gabriel-bettanin/LAIKA/Docs/Fotos/3D Printed Robot Actuator.jpg

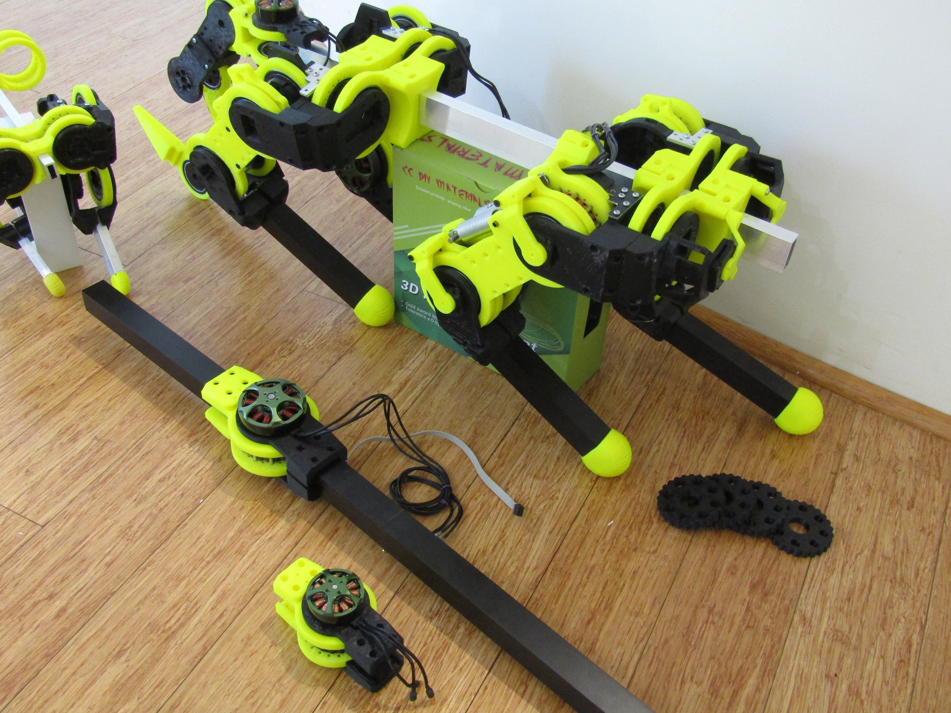
Docs/Fotos/3D Printed Robot Actuator.jpg
