gabriel-bettanin/LAIKA/Actuator/Electronics/3D Models/JST_Pins/JST/HLB1uQQOXyzxK1RjSspjq6AS.pXaA.jpg_q50.jpg

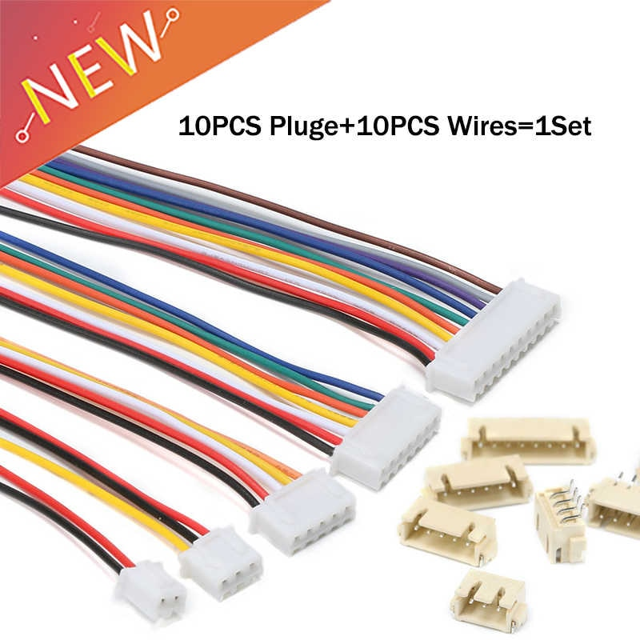
Actuator/Electronics/3D Models/JST_Pins/JST/HLB1uQQOXyzxK1RjSspjq6AS.pXaA.jpg_q50.jpg
