gabriel-bettanin/LAIKA/README.md

# laika
Affordable robotic's actuator for dynamic robots
