gabriel-bettanin/LAIKA/Docs/PET/1. Reunião de Projetos - Iniciação.pptx

## LAIKA

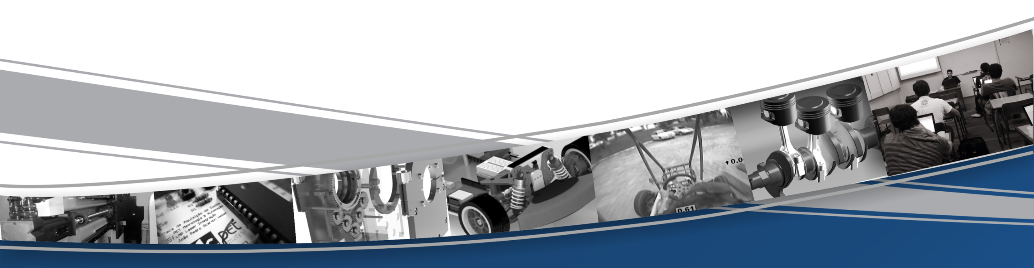
[picture p3: figure]

Gabriel Antonio Nalin Bettanin

## Agenda

- Apresentação do Projeto
  - Motivação
  - Escopo
  - Objetivo
- Análise de Riscos
- Etapas

## Apresentação do Projeto

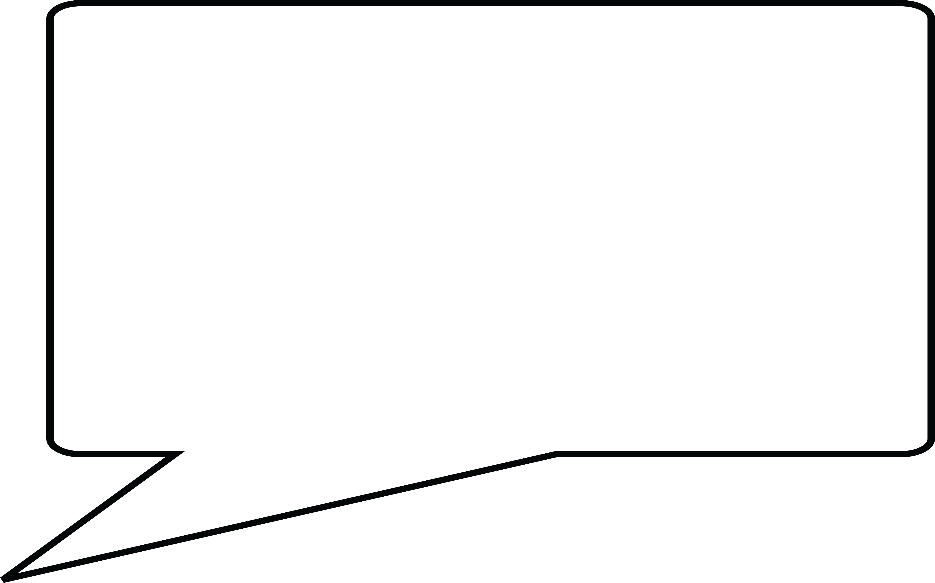
[picture p4: figure]

Pô Bettanin por quê você escolheu esse nome ??

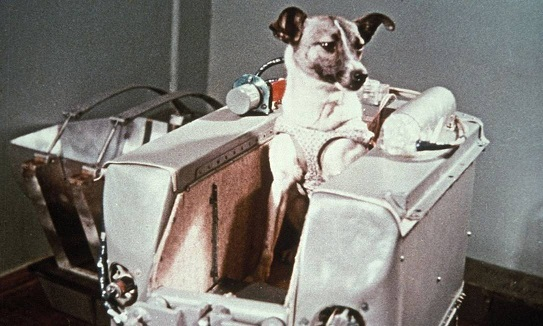
[picture p5: figure]
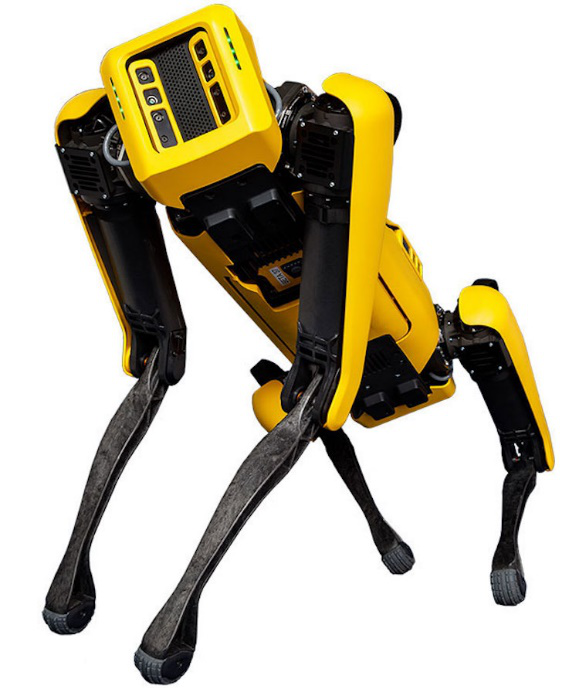
[picture p6: figure]

1954 - 1957

## Apresentação do Projeto

L egged
A rchitecture
for I mplementing
K inematics
A lgorithms

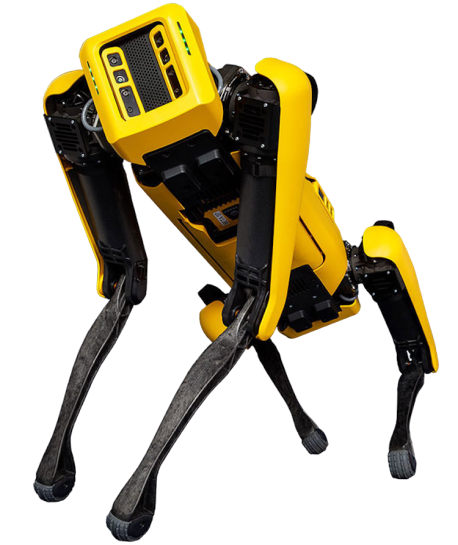
[picture p7: figure]

## Apresentação do Projeto

Arquitetura robótica quadrupede para a implementação de algoritmos cinemáticos

## Apresentação do Projeto

- Robôs são o futuro
- Brasil possui poucas iniciativas nessa área
- Plataforma P&D multidisciplinar

## Apresentação do Projeto

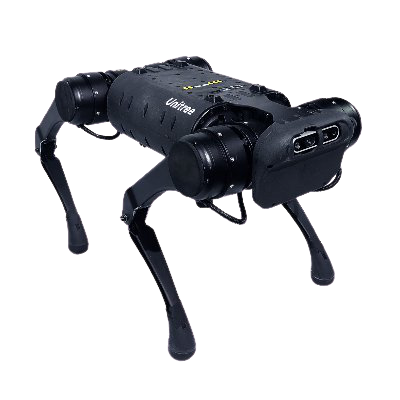
[picture p8: figure]
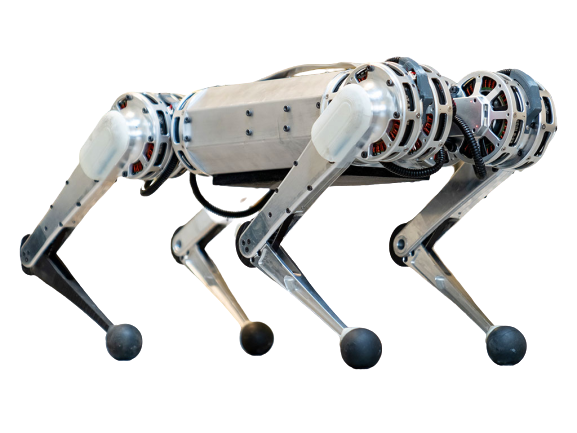
[picture p9: figure]
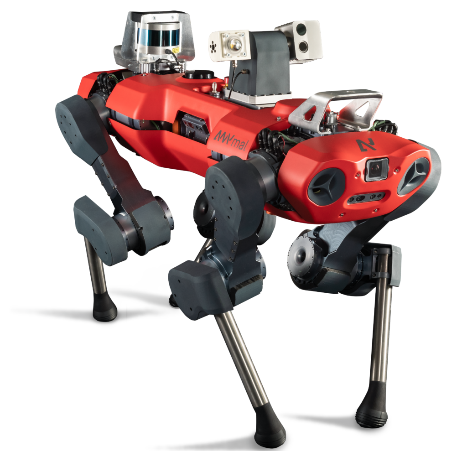
[picture p10: figure]
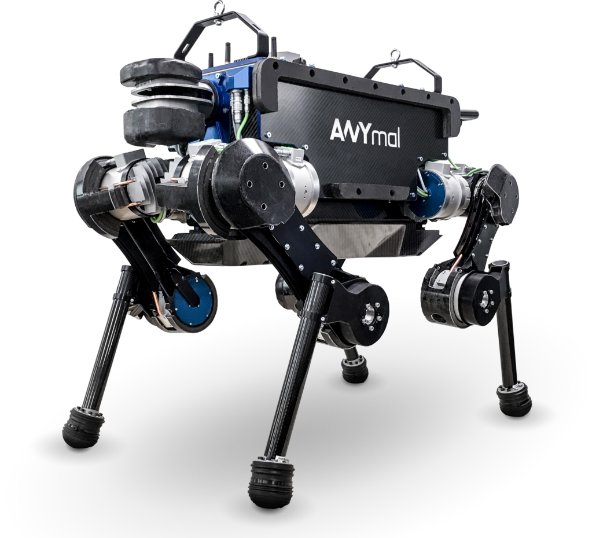
[picture p11: figure]

## Definição do Escopo

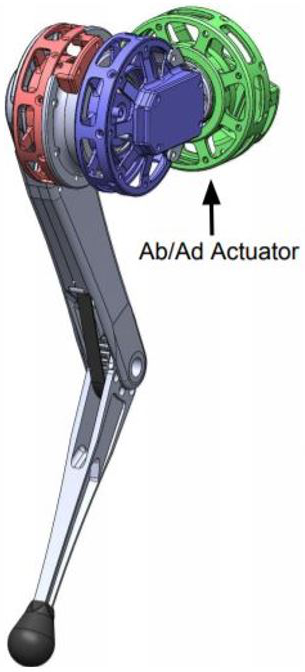
[picture p12: figure]

Perna

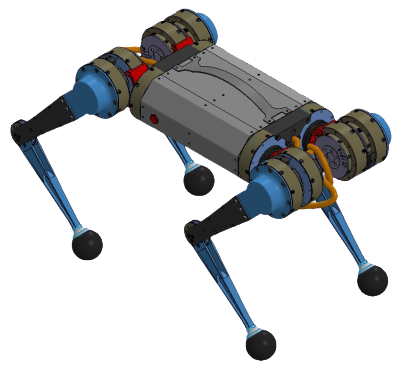
[picture p13: figure]

Quadrupede

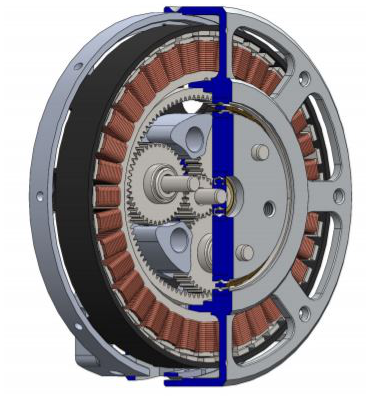
[picture p14: figure]

Atuador

## Objetivos

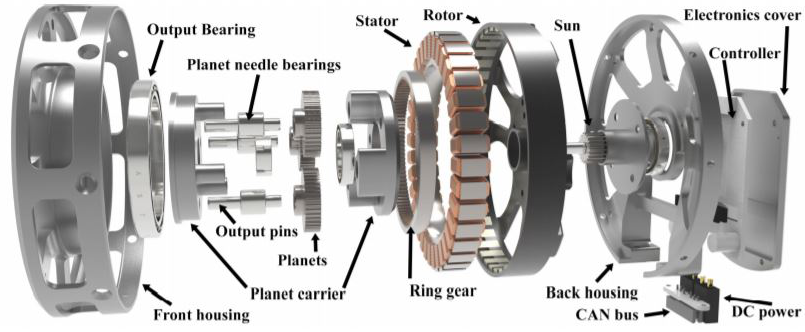
[picture p15: figure]

## Objetivos

- Desenvolvimento de um atuador robótico de baixo custo
  - Custo: < R$ 2000,00
  - Torque máximo: ~15N.m
  - Torque contínuo : ~7N.m
  - Robusto, dinâmico e backdrivable
  - OpenSource

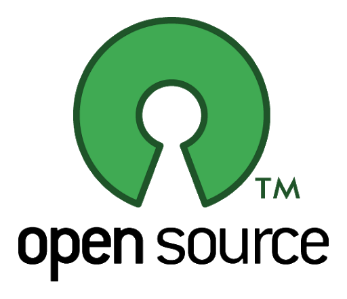
[picture p16: figure]

## Análise de Riscos

  - Possíveis problemas:
    - Orçamento
    - Prototipação em quarentena
    - Áreas complexas e diversas
  - Problemas descartados:
    - Escassez de informações

## Etapas

- Macro 1 – Estudos
  - Leitura de artigos (IEEE, ICRA, MIT, ETH, ...)
  - Documentação de referência (Git, CAD, ...)
  - Acompanhamento de projetos existentes (Hackaday)
  - Cursos (Controle de motores, dinâmica, robótica)
Duração de 30 dias

## Etapas

- Macro 2 – Eletrônica
  - Driver para motor BLDC
  - Placa “mestre”
  - Duração de 30 dias
- Macro 3 – Firmware
  - Adaptação de firmwares existentes
  - Modelo cinemático para testes
  - Duração de 20 dias

Macro 4 – Mecânica
Adaptar motor
Embutir engrenagens
Duração de 30 dias
Macro 5 – Validação
Testes de desempenho (mecânico, elétrico, térmico)
Duração de 10 dias

## Slide 14

Gabriel Antonio Nalin Bettanin
gabriel.bettanin@labmetro.ufsc.br

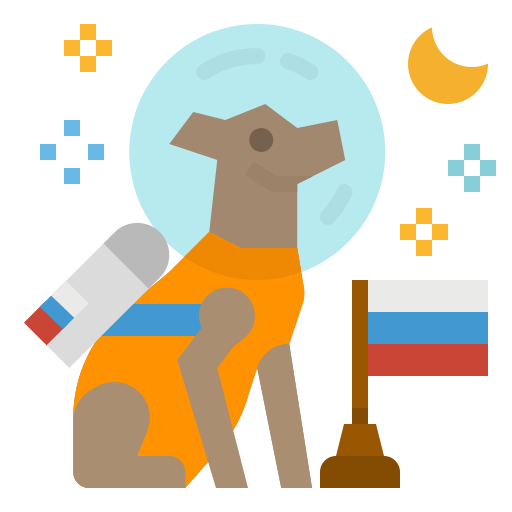
[picture p17: figure]
