gabriel-bettanin/LAIKA/References/Artigos/BLDC/Motor Modelling notes.pdf

# Motor Modeling Notes

Ben Katz

November 2016
Last Modified 1/5/2017

In the process of writing a motor simulator, I found it frustratingly difficult to find easily-understandable references which made assumptions similar to those I care about, and easily allowed for things like funny flux-linkages, non-sinusoidaly varying inductance, and computing everything from the stator reference frame, rather than the D/Q frame. These notes are a neater version of the chicken-scratch I generated while working through the relevant equations on my own. Maybe someone will read this and find it useful. This work was done in the process of building a motor-simulation tool, the source of which is available at https://github.com/bgkatz/motor-modeling

Full warning, these notes assume some basic motor and E&M familiarity. I’m not starting with a diagram of a motor and explaining from scratch how it works. This is mostly for myself, really, so I can look back and see how I approached this problem. And writing things down is a good way to clarify them to myself.

If you spot any egregious errors please let me know.

## 1 Modeling Goals

Here are the goals of this motor modeling exercise:

- Model everything at the phases, rather than in D/Q coordinates
- Make no assumptions about phase inductances (i.e. they don’t have to be constant or vary sinusoidally, phases can saturate)
- Make no assumptions about the shape of the rotor-flux linkage (i.e. it doesn’t need to be sinusoidal, it can very with current, etc.)
- Account for mutual inductance between phases

1

## 2 Voltage Equations

### 2.1 A Single Phase

The first step is to look at the voltage equation for a single phase of the motor. This phase has a resistance R, a current through it i, and a flux linkage λ. Voltage across that phase is:

v = R · i +

dλ
dt | (1)

The first trick is decomposing the dλ
dt term. First of all, what is λ, equal to, let alone its time derivative? Depending on what effects you choose to model, the λ term can become very large. In this case, I’m choosing to consider:
- The flux linked by the the rotor permanent magnets, λr
- The flux linked by the phase itself, which is equal to the self-inductance of the phase times the current through the phase: La · ia, where La is the self-inductance of phase a.
- The flux linked to the phase by all the other phases. For every other phase, the flux linked to the phase of interest is their mutual inductance times the current through the other phase: For phase a, this is the sum of Lan · in for every other phase n.

To put everything into context, here’s flux linked by phase a in a 3-phase motor, which has phases b and c as well.

λa = λra + La · ia + Lab · ib + Lac · ic | (2)

In general, none of these values are constants! λr, La, Lab, and Lac are typically functions of the rotor position and current (θ, and ia, ib, and ic), λr and a function of rotor position and phase current. For special motors under certain operating conditions, some terms might be pretty much constant, causing their time derivatives to be zero and drop out. For example, in a surface permanent magnet motor operating at low-ish currents, (i.e. a typical ”brushless” motor), the inductances are basically constant, so their derivatives are equal to zero (if you ignore current-varying inductance, i.e. saturation). And for a reluctance motor, the PM flux is zero, so the derivative of λr is zero.
Since none of the values in (2) are constants, taking the time derivative of that expression makes it even longer:

dλa
dt =

dλr
dt + La

dia
dt + ia

dLa
dt + Lab

dib
dt + ib

dLab
dt + Lac

dic
dt + ic

dLac
dt (3)

Then the expanded voltage equation for phase a is:

va = La

dia
dt + Lab

dib
dt + Lac

dic
dt + ia

dLa
dt + ib

dLab
dt + ic

dLac
dt +

dλra
dt + Raia (4)

2

### 2.2 Back-EMF

You’d expect there to be some term in the phase voltage equation that looks like your classic brushed-motor ”Back-EMF”, i.e. a voltage proportional to the speed and torque constant of the motor. Since all the derivatives are with respect to time, these terms are a little less obvious. Ignoring magnetic saturation (inductance depending on current), generally, λr and L are functions of rotor position, θ. So saying L = L(θ) and λr = λr(θ) and taking the time-derivatives gives you:

d

dtλr(θ) = dθ
dt

dλr
dθ = ω

dλr
dθ | (5)

d

dtL(θ) = dθ
dt

dL
dθ = ω

dL
dθ | (6)

where ω is angular velocity.
Plugging those into (4) gives you two voltages proportional to angular velocity! The λ term is your ”normal” back-emf from the permanent magnets, and the L term is why pure reluctance motors (with no magnets) still have back-emf.

### 2.3 Model All the Phases!

By looking at (4), you can just write down the voltage equations for the remaining phases by symmetry. These equations lend themselves to being written in matrix form. In it’s entirety, the system of equations is as follows. I think it’s important to fully write it out once:

va
vb
vc
- =
La | Lab | Lac
Lab | Lb | Lbc
Lac | Lbc | Lc

dia
dt
dib
dt +

dic
dt

+

d
dt
La | Lab | Lac
Lab | Lb | Lbc
Lac | Lbc | Lc

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
Ra | 0 | 0
0 | Rb | 0
0 | 0 | Rc

ia
ib
ic
- (7)

That’s extremely long, so from now on, I’ll use the following abbreviations.

•

L
is the matrix of inductances.

•

dL
dt
is the matrix of inductance derivatives.

3

•

R
is the resistance matrix.

•

v
is the column vector of phase voltages.

•

i
is the column vector of currents.

•

di
dt
is the column vector of current derivatives.

•

dλr
dt
is the column vector of PM flux linkage derivatives.

Given those abbreviations, the voltage equation is:

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
Since I’m trying to model motors on a computer, the order of things needs some re-scrambling. In my case, -v
is a known (set by the inverter), and I’m trying to solve for the currents and current derivatives. The way about this is to assume that over a short time period, currents are constant, and solve for their derivatives, -

di
dt
. Numerically integrating these derivatives gives currents. So the actual equation getting solved by the computer is:

di
dt
=
L

−1 -
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
| (9)

## 3 Winding Termination

The previously described voltage equations solve for the voltages across each phase. This is not the same thing as the terminal voltages of the motor. Since an inverter sets the terminal voltages, not the phase voltages, to actually simulate a motor we need to get the equations in terms of the terminal voltages (u, v, w) rather than the phase voltages (va, vb, vc).

### 3.1 Independent Phases

Here’s the simplest case. Each phase is independently controlled. This looks like a wye-terminated motor with the center point grounded. The phase voltages are equal to the terminal voltages.

va | = u
vb | = v | (10)
vc | = w

### 3.2 Delta

The delta case is also easy. The phase voltages are just the differences of the terminal voltages:

va | = u − v
vb | = v − w | (11)
vc | = w − u
| 4

### 3.3 Wye

Things get a bit more unpleasant when dealing with a wye-terminated motor. To solve wye motors, I introduced another unknown variable: N, the neutral voltage (at the center point). The phase voltages are then equal to:

va | = u − N
vb | = v − N | (12)
vc | = w − N

The extra unknown comes with another constraint, ia +ib +ic = 0, i.e. KCL at the center node.
To solve, I substituted the above into the voltage equations (8), so there were terminal voltages on the left, and neutral voltages on the right. Then I re-scrambled the matrices to be 4x4 to add the current constraint. Intuitively, I’m fairly sure there’s a more elegant way to enforce the currents-sum-to-zero constraint without explicitly solving for N, (like a reaction force in a mechanical dynamics problem, usually you can solve the dynamics without solving for the reaction force) but this was the method that I went with. Also, I actually enforce the constraint on the current derivatives (which must also sum to zero). Here’s the equation I end up solving for a wye motor:

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
1 | 1 | 1 0

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
0 | 0 | 0 0

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
| [R] | 0
| | 0
0 | 0 | 0 0

[i]
0
(13)

To solve, like (10), move things to the left side of the equation and multiply by the inverse of the new, modified inductance matrix. The resulting vector is the current derivatives and the neutral voltage.

## 4 Power and Torque

To find power from the voltage equations, both sides get dotted with the current vector, since power is current times voltage. The left side of the equation is

5

electrical power going into the terminals of the motor (phase voltages times phase currents). The right side of the equation takes a little interpretation. First, the easiest term is the one with resistances. Doing the dot product, the term is
Rai

2
a + Rbi

2
b + Rci

2
c

(14)

which is the power dissipated in the stator resistance.

Next up is the inductance term, which comes out to

L

di
dt
·
i
(15)

which is the power going into the inductors (i.e. rate of energy getting stored in the magnetic fields)
Finally, there are the remaining Back-EMF terms:

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
(16)

which correspond to the mechanical power of the motor. The two summed terms in (16) come from the two different torque sources - permanent-magnet torque, and reluctance torque.

To get torque, just divide this term by the angular velocity of the motor, since power is also equal to torque times angular velocity. Keep in mind that these equations have all been per pole-pair, so to get actual speed and torque, divide and mulitply by number of pole-pairs respectively.

## 5 Useful References

Kirtley, J.L. 6.061 Class Notes, Ch 12 Permanent Magnet ”Brushless” DC Motors
https://ocw.mit.edu/courses/electrical-engineering-and-computer-science/6-061-introduction-to-electric-power-systems-spring-2011/readings/MIT6_061S11_ch12.pdf (https://ocw.mit.edu/courses/electrical-engineering-and-computer-science/6-061-introduction-to-electric-power-systems-spring-2011/readings/MIT6_061S11_ch12.pdf)

Mevey, James Robert. Sensorless Field Oriented Control of Brushless Permanent Magnet Synchronous Motors http://krex.k-state.edu/dspace/bitstream/handle/2097/1507/JamesMevey2009.pdf;jsessionid=932443A6F509B241FE69DA96D4A0207A?sequence=1 (http://krex.k-state.edu/dspace/bitstream/handle/2097/1507/JamesMevey2009.pdf;jsessionid=932443A6F509B241FE69DA96D4A0207A?sequence=1)

6
