gabriel-bettanin/LAIKA/Actuator/Financial/JLCPCB_PCB Invoice.pdf

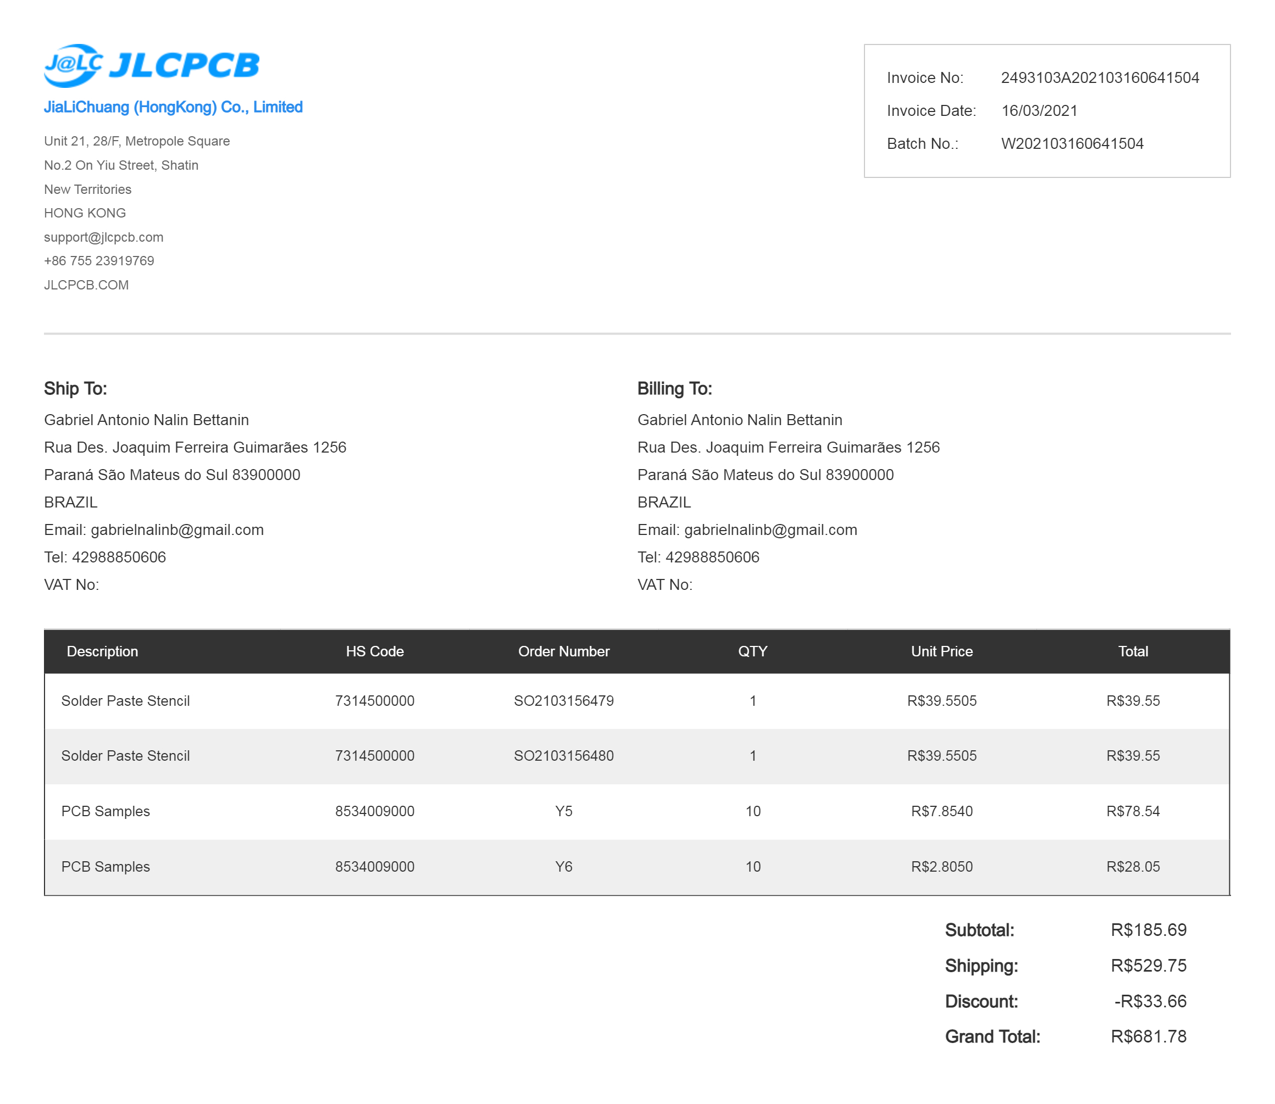
[picture p18: page 1]
