gabriel-bettanin/LAIKA/Actuator/Electronics/3D Models/JST_Pins/JST/3-Pin JST XH Female/85227.jpg

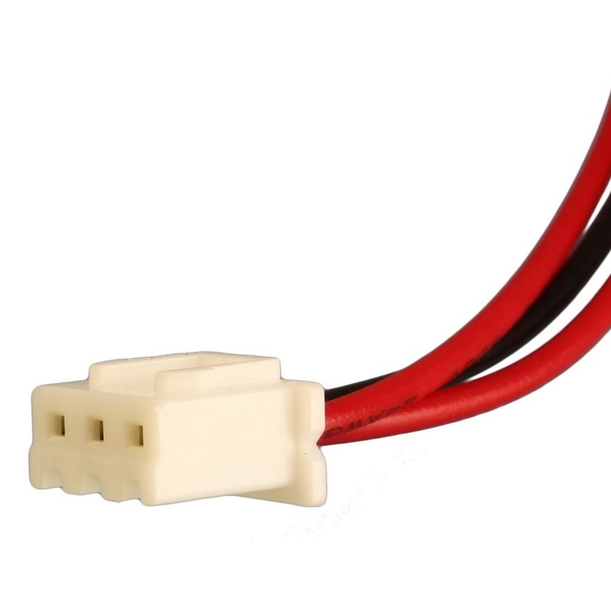
Actuator/Electronics/3D Models/JST_Pins/JST/3-Pin JST XH Female/85227.jpg
