gabriel-bettanin/LAIKA/Actuator/Electronics/3D Models/XT-60/XT60 Female Connector 3DView.JPG

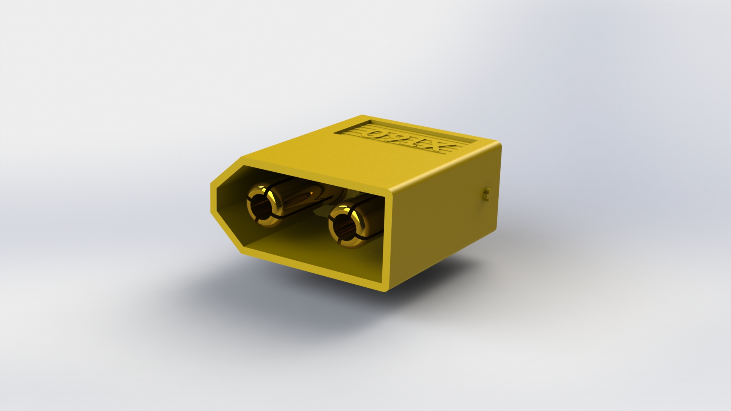
Actuator/Electronics/3D Models/XT-60/XT60 Female Connector 3DView.JPG
