gabriel-bettanin/LAIKA/Actuator/Electronics/3D Models/XT_30/XT30PW-M_1.png

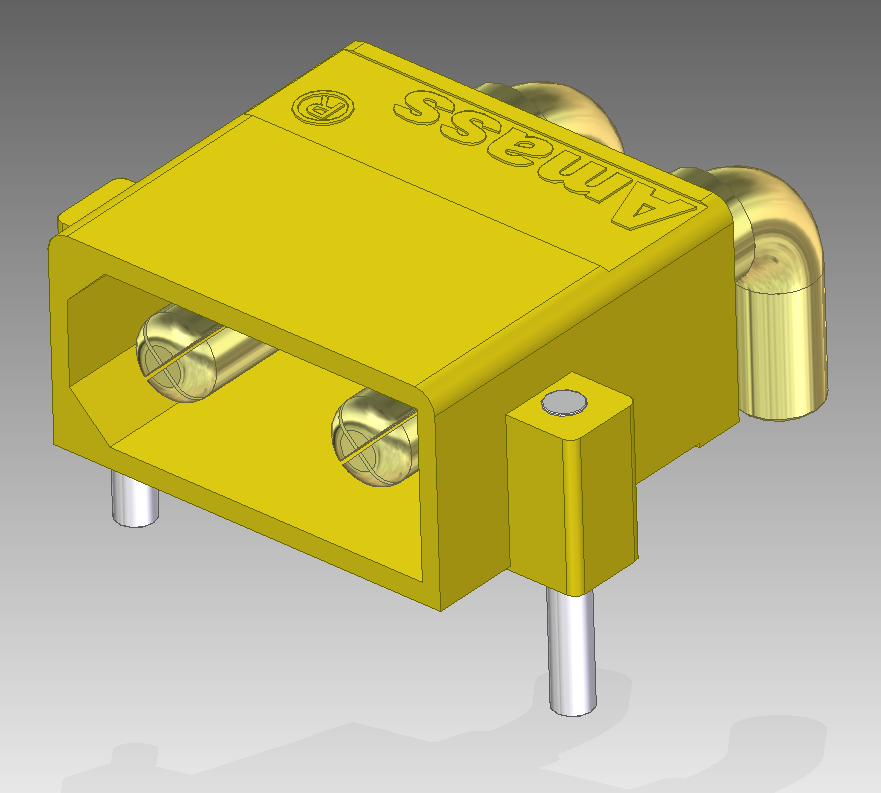
Actuator/Electronics/3D Models/XT_30/XT30PW-M_1.png
