gabriel-bettanin/LAIKA/Actuator/Electronics/3D Models/XT_30/XT30PW-M_2.png

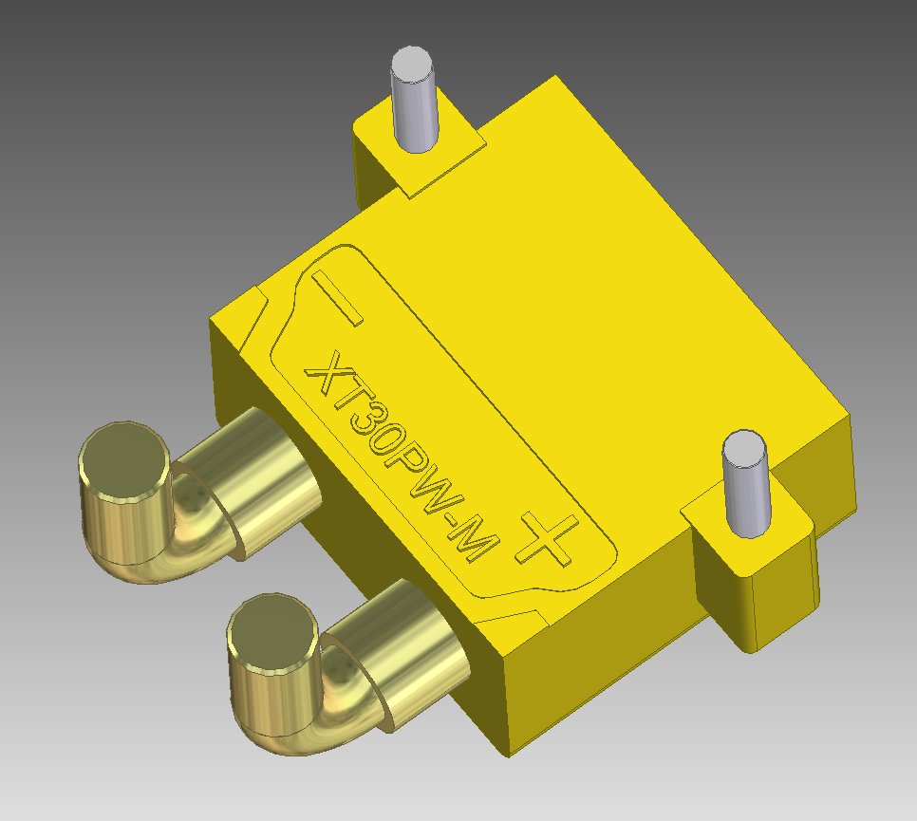
Actuator/Electronics/3D Models/XT_30/XT30PW-M_2.png
