gabriel-bettanin/LAIKA/Actuator/Mechanics/Cycloidal Drive/Screws/Hex Nut/Rendering/Capture.PNG

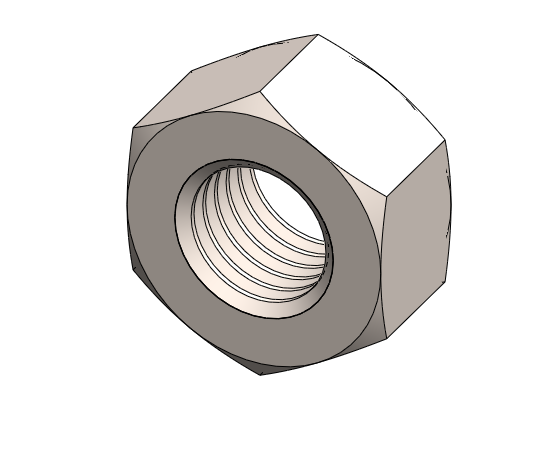
Actuator/Mechanics/Cycloidal Drive/Screws/Hex Nut/Rendering/Capture.PNG
