gabriel-bettanin/LAIKA/Actuator/Mechanics/Cycloidal Drive/Screws/Hex Nut/Rendering/Nut.3.jpg

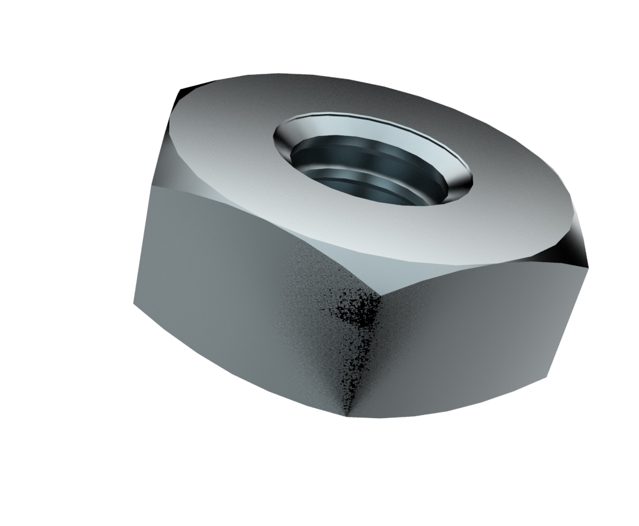
Actuator/Mechanics/Cycloidal Drive/Screws/Hex Nut/Rendering/Nut.3.jpg
