gabriel-bettanin/LAIKA/Actuator/Mechanics/Cycloidal Drive/Screws/Hex Nut/Rendering/Nut.jpg

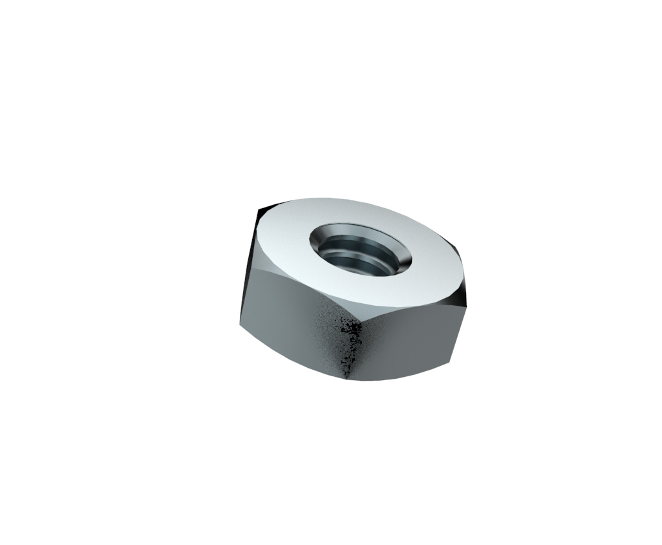
Actuator/Mechanics/Cycloidal Drive/Screws/Hex Nut/Rendering/Nut.jpg
