gabriel-bettanin/LAIKA/Actuator/Mechanics/Cycloidal Drive/Screws/screws-m3-to-m6-din912-iso4762-1.snapshot.2/RENDERING/din912-m3tom6.png

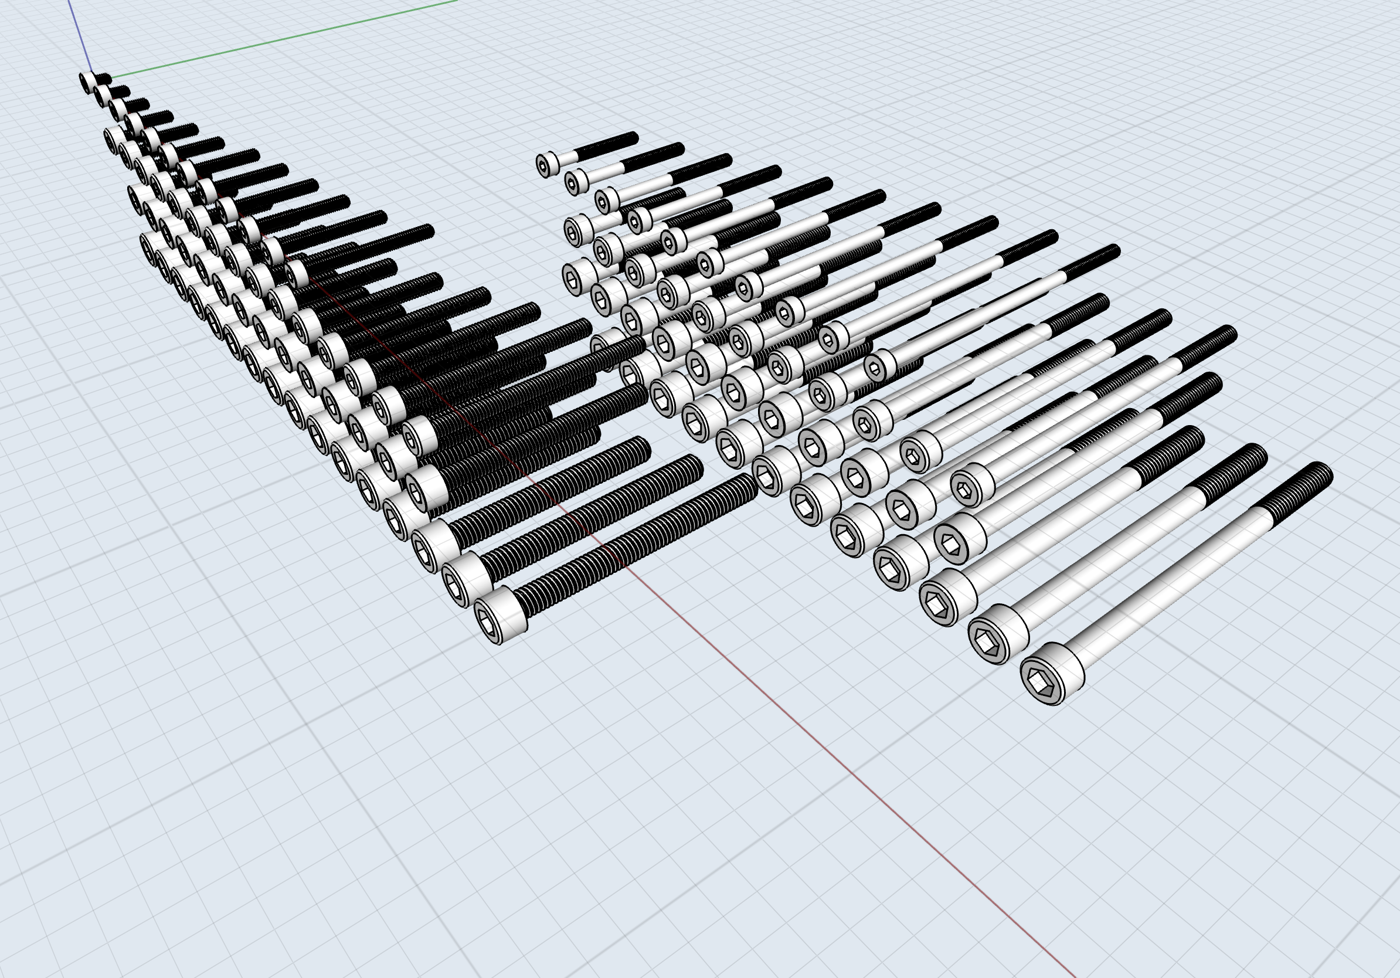
Actuator/Mechanics/Cycloidal Drive/Screws/screws-m3-to-m6-din912-iso4762-1.snapshot.2/RENDERING/din912-m3tom6.png
