gabriel-bettanin/LAIKA/Docs/Fotos/9bb722f0e85ddbc1ce0f064534fd2311---cone-da-linguagem-de-programa----o-python-by-vexels.png

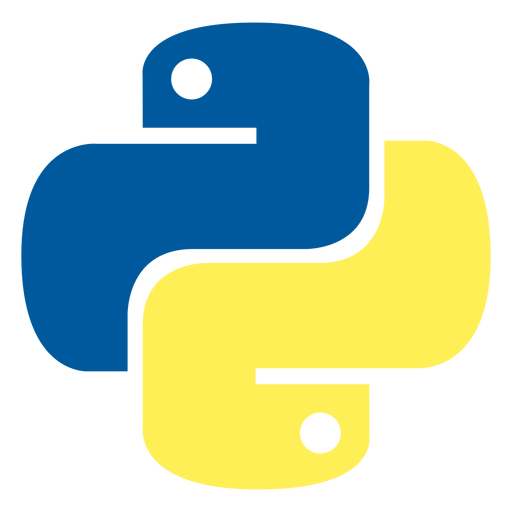
Docs/Fotos/9bb722f0e85ddbc1ce0f064534fd2311---cone-da-linguagem-de-programa----o-python-by-vexels.png
