gabriel-bettanin/LAIKA/Docs/Fotos/actuator.JPG

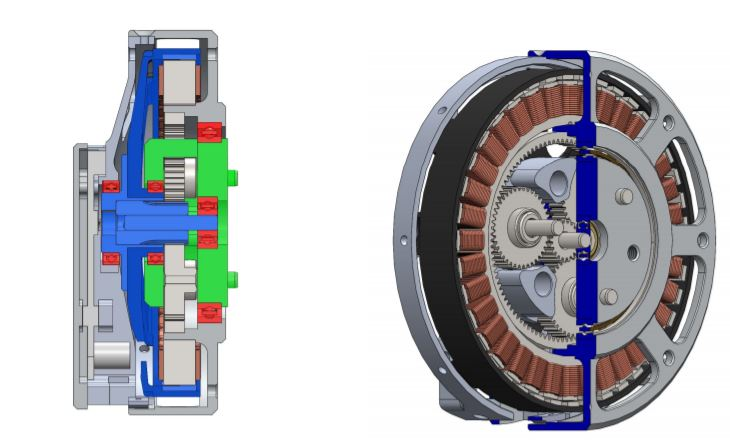
Docs/Fotos/actuator.JPG
