gabriel-bettanin/LAIKA/Docs/Fotos/anymal 2.png

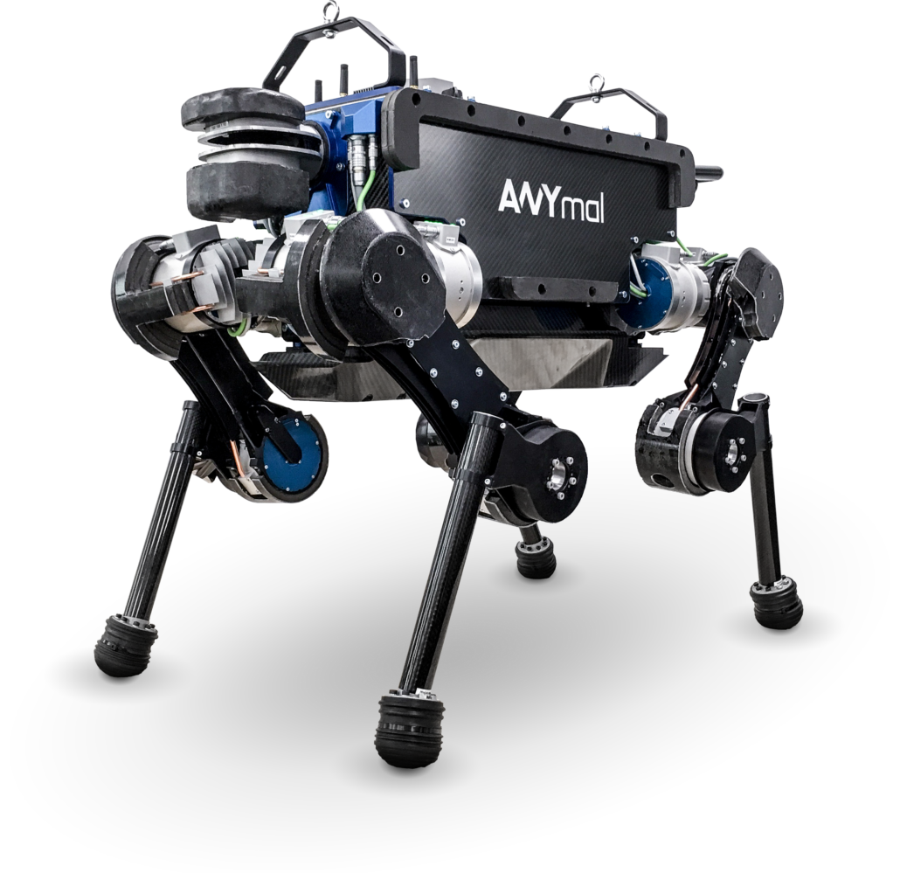
Docs/Fotos/anymal 2.png
