gabriel-bettanin/LAIKA/Docs/Fotos/Atlas_DRC.jpg

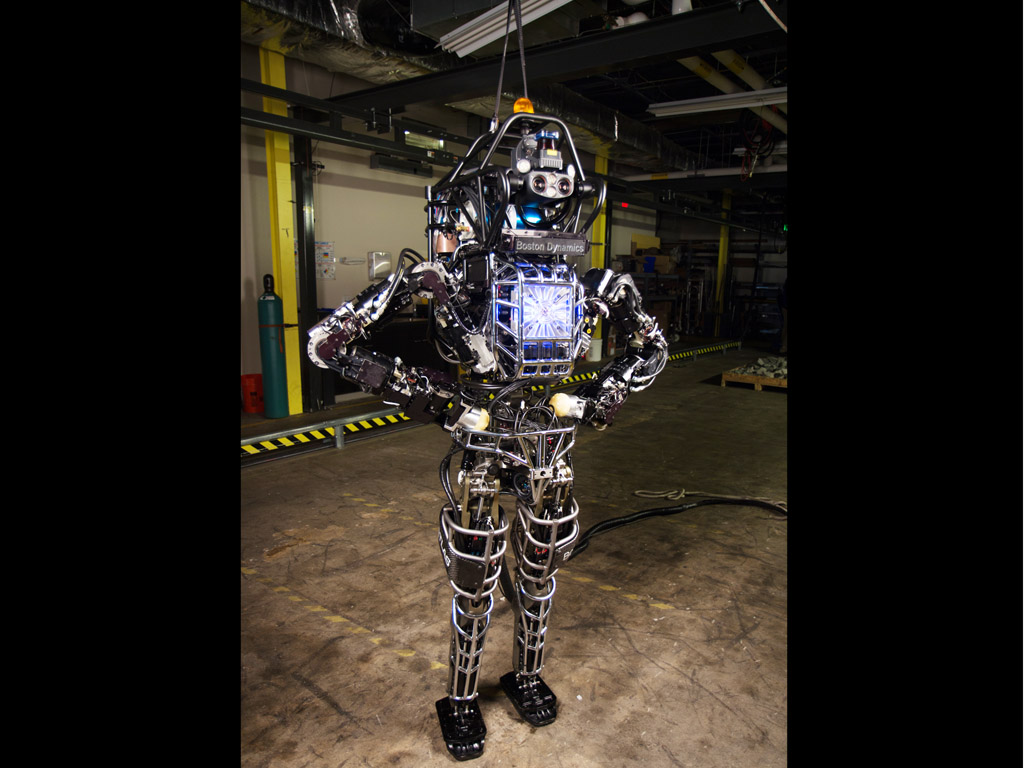
Docs/Fotos/Atlas_DRC.jpg
