gabriel-bettanin/LAIKA/Docs/Fotos/bigdog-thumb@2x.jpg

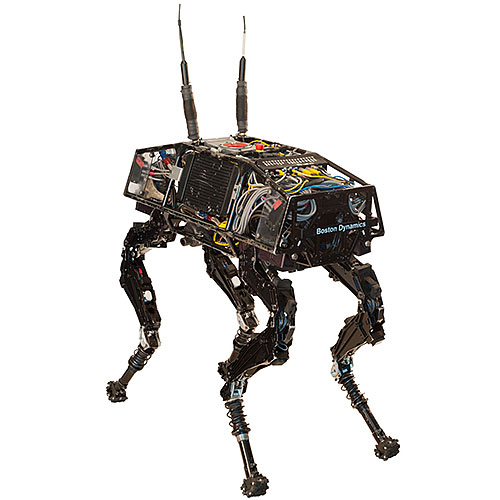
Docs/Fotos/bigdog-thumb@2x.jpg
