gabriel-bettanin/LAIKA/Docs/Fotos/Blackbird Bipedal Robot.jpeg

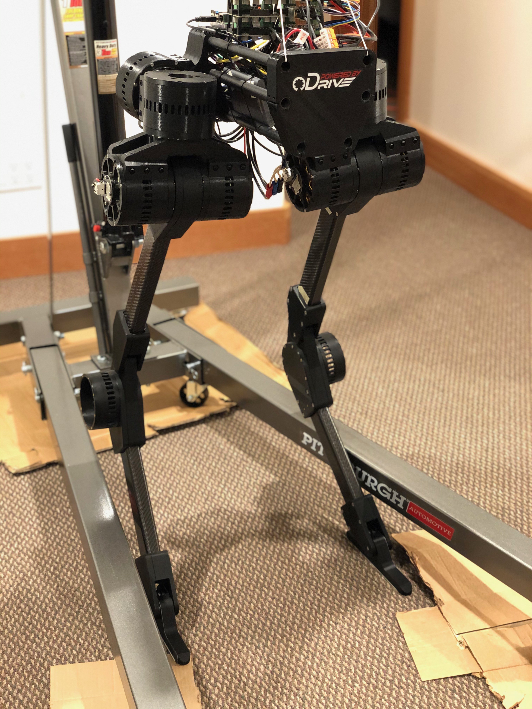
Docs/Fotos/Blackbird Bipedal Robot.jpeg
