gabriel-bettanin/LAIKA/Docs/Fotos/BLDC Walker.jpg

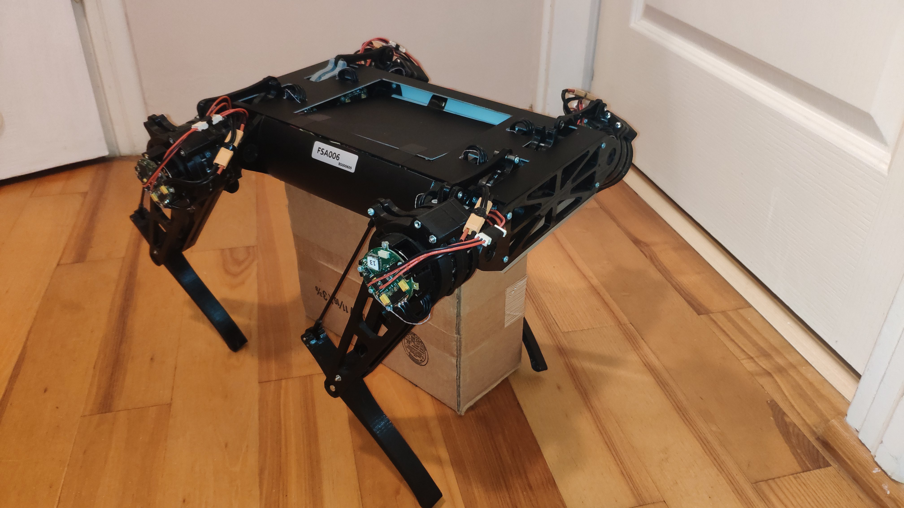
Docs/Fotos/BLDC Walker.jpg
