gabriel-bettanin/LAIKA/Docs/Fotos/bldc.JPG

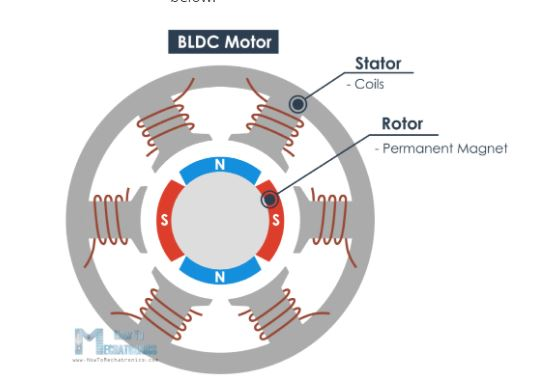
Docs/Fotos/bldc.JPG
