gabriel-bettanin/LAIKA/Docs/Fotos/Capturar.JPG

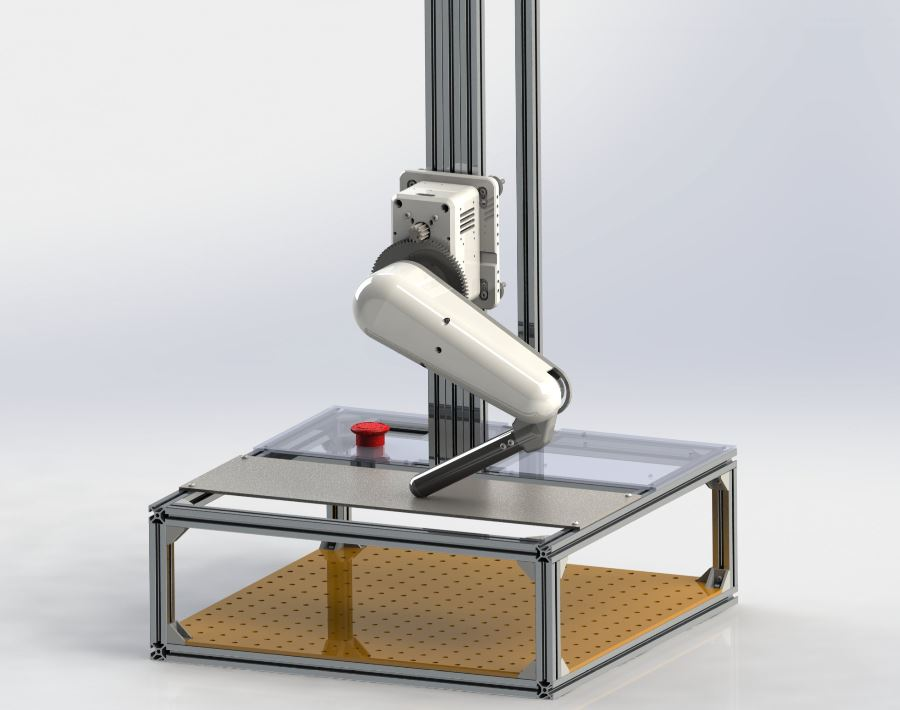
Docs/Fotos/Capturar.JPG
