gabriel-bettanin/LAIKA/Docs/Fotos/cheetah-removebg-preview.png

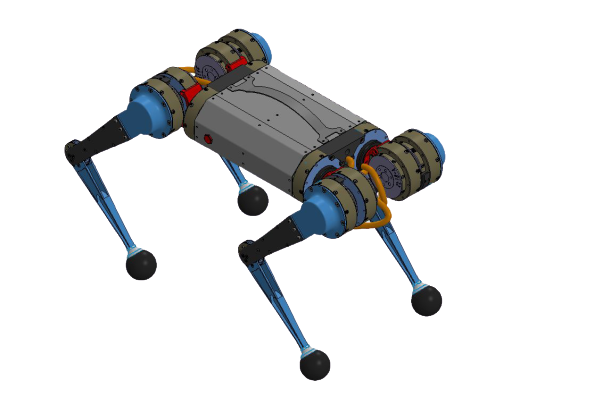
Docs/Fotos/cheetah-removebg-preview.png
