gabriel-bettanin/LAIKA/Docs/Fotos/cheetah.JPG

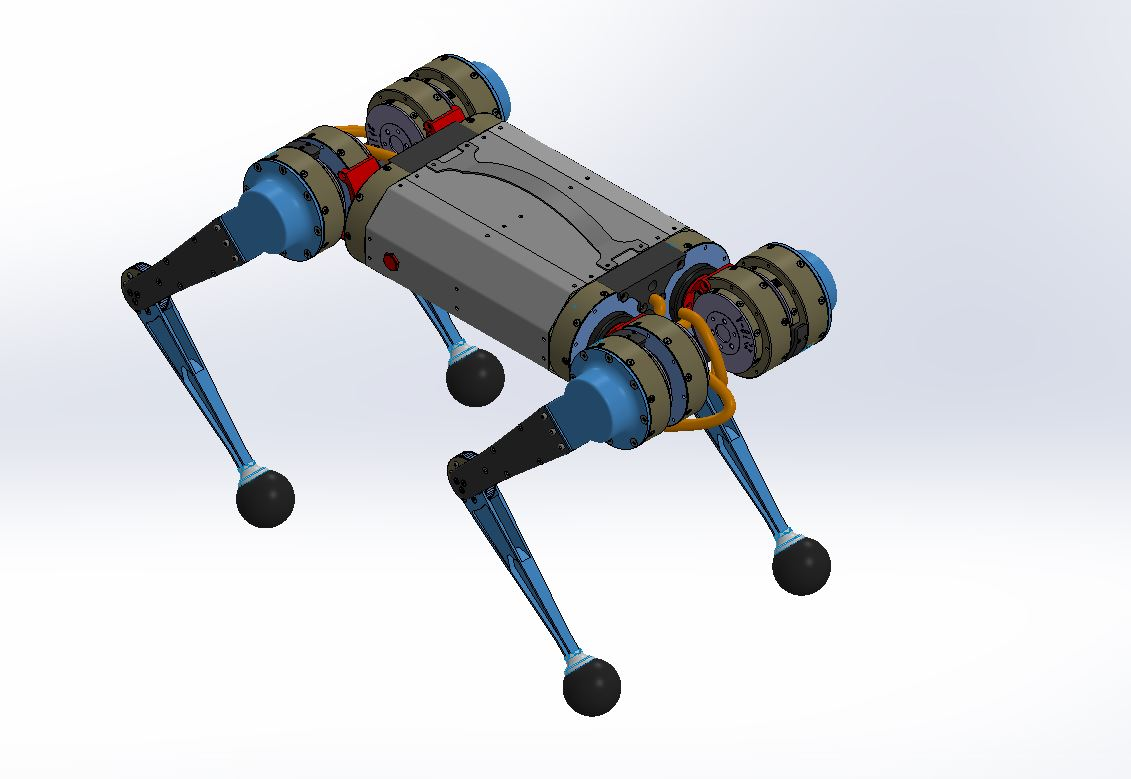
Docs/Fotos/cheetah.JPG
