gabriel-bettanin/LAIKA/Docs/Fotos/dialog.png

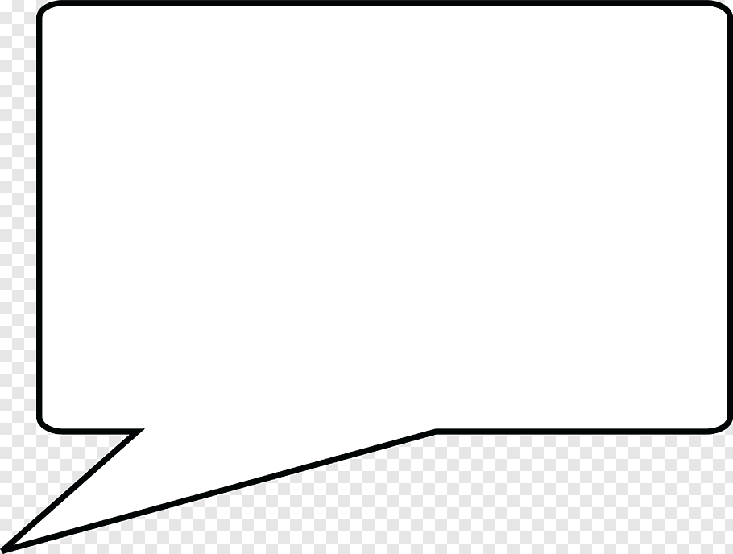
Docs/Fotos/dialog.png
