gabriel-bettanin/LAIKA/Docs/Fotos/dogs.png

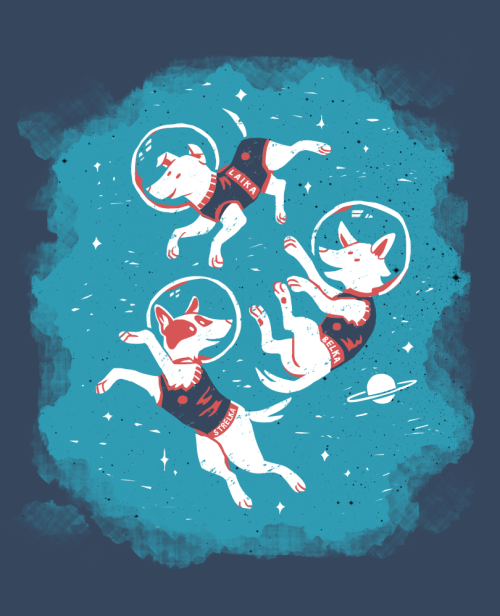
Docs/Fotos/dogs.png
