gabriel-bettanin/LAIKA/Docs/Fotos/engrenagem-planetaria-03.jpg

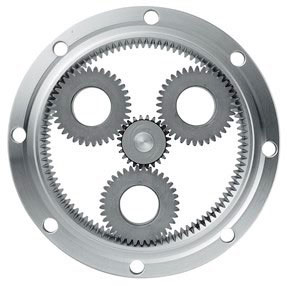
Docs/Fotos/engrenagem-planetaria-03.jpg
