gabriel-bettanin/LAIKA/Docs/Fotos/Estator.JPG

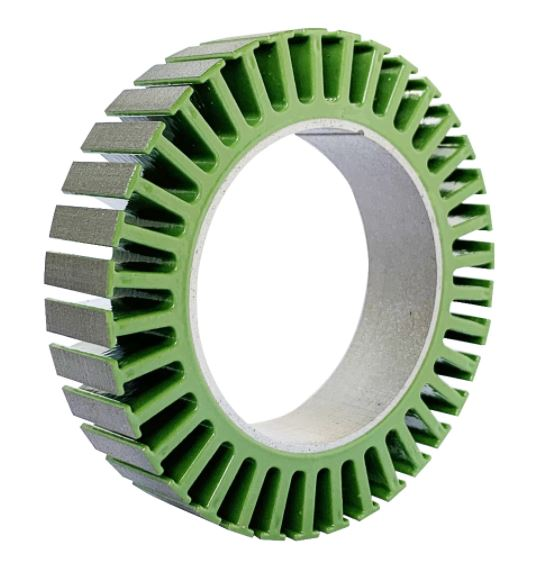
Docs/Fotos/Estator.JPG
