gabriel-bettanin/LAIKA/Docs/Fotos/leg 2.JPG

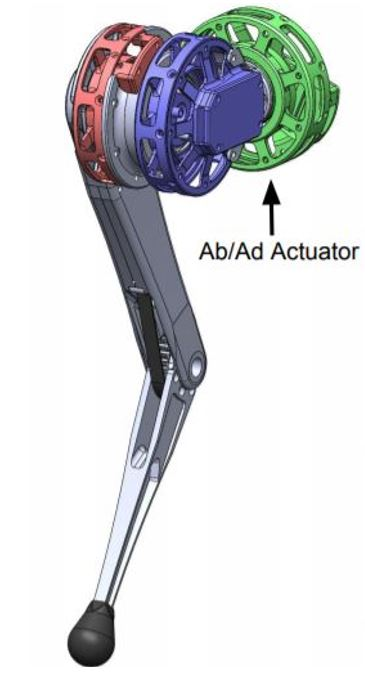
Docs/Fotos/leg 2.JPG
