gabriel-bettanin/LAIKA/Docs/Fotos/Leg.JPG

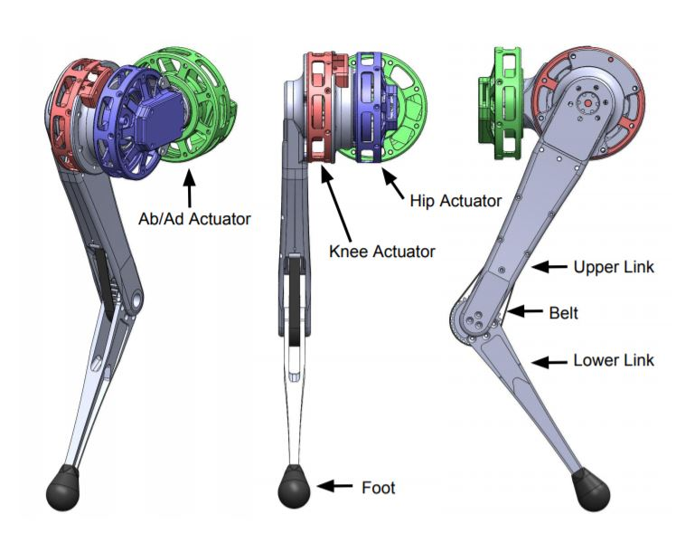
Docs/Fotos/Leg.JPG
