gabriel-bettanin/LAIKA/Docs/Fotos/minicheetah-photo1-full.jpg

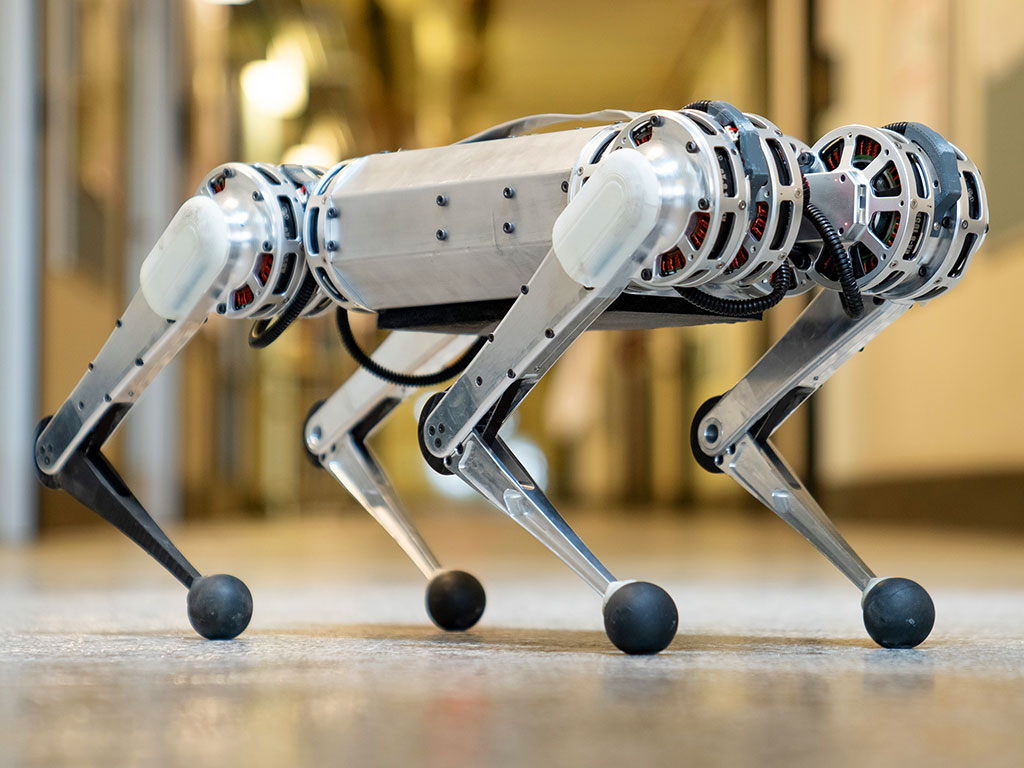
Docs/Fotos/minicheetah-photo1-full.jpg
