gabriel-bettanin/LAIKA/Docs/Fotos/MIT actuator.JPG

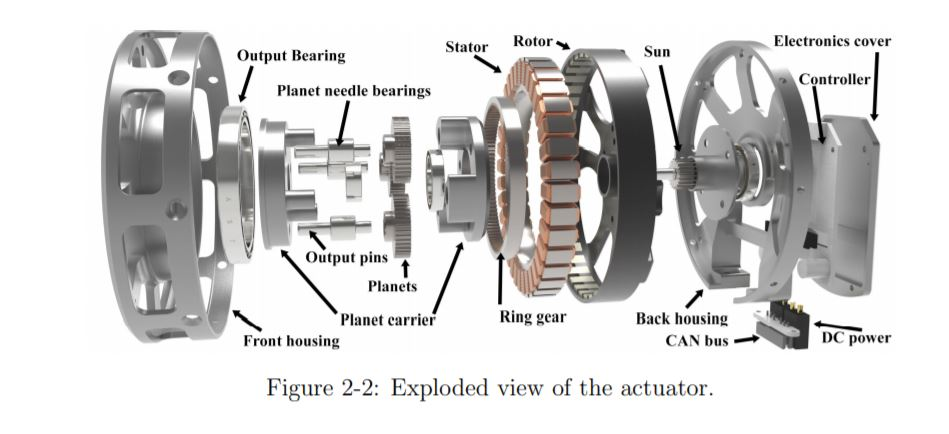
Docs/Fotos/MIT actuator.JPG
