gabriel-bettanin/LAIKA/Docs/Fotos/mj.JPG

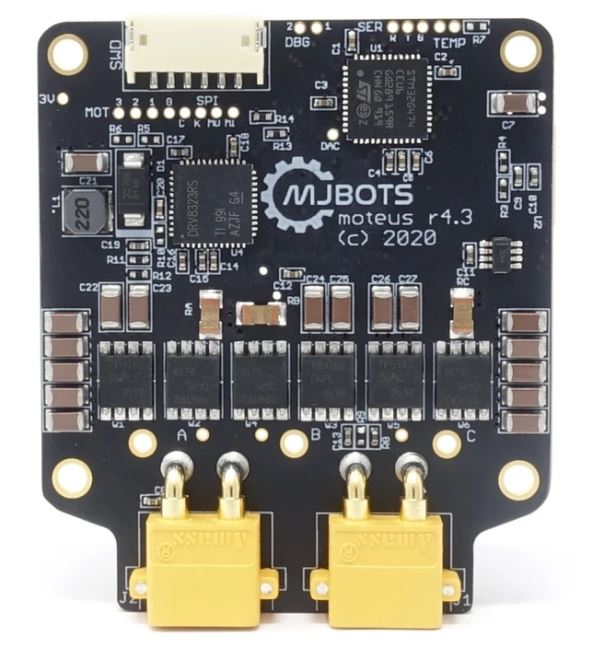
Docs/Fotos/mj.JPG
