gabriel-bettanin/LAIKA/Docs/Fotos/motor 2.JPG

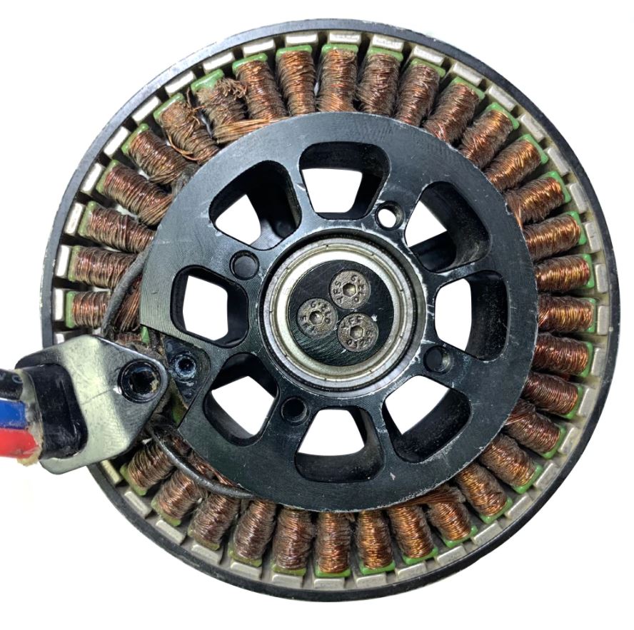
Docs/Fotos/motor 2.JPG
