gabriel-bettanin/LAIKA/Docs/Fotos/motor.JPG

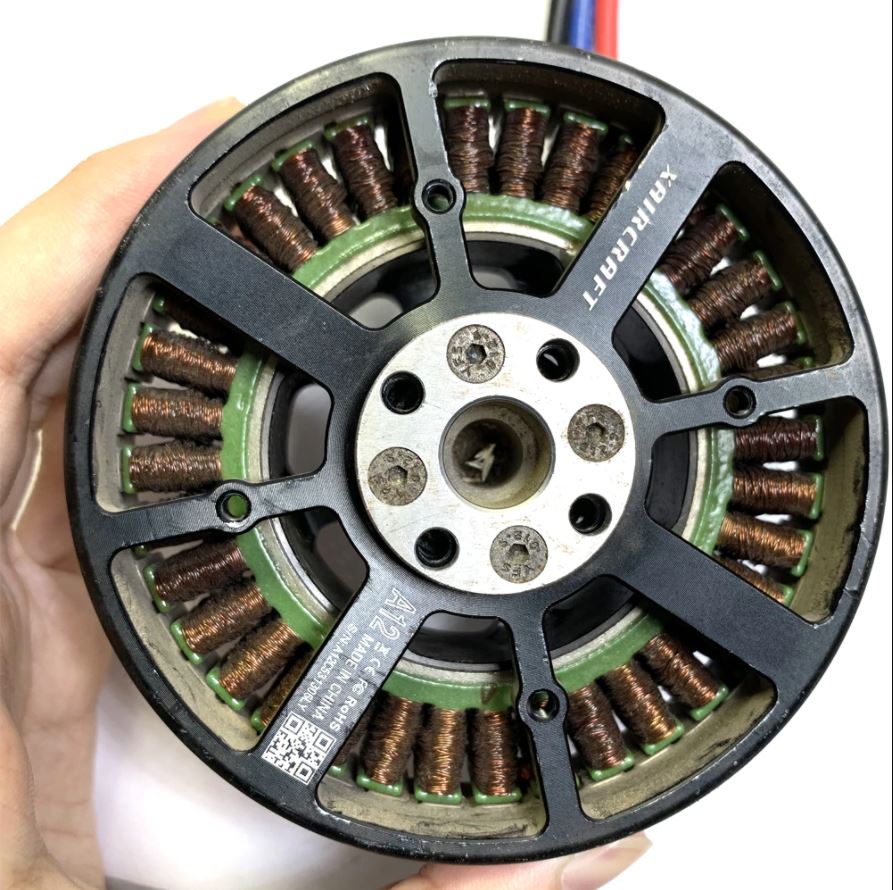
Docs/Fotos/motor.JPG
