gabriel-bettanin/LAIKA/Docs/Fotos/odrive.jpeg

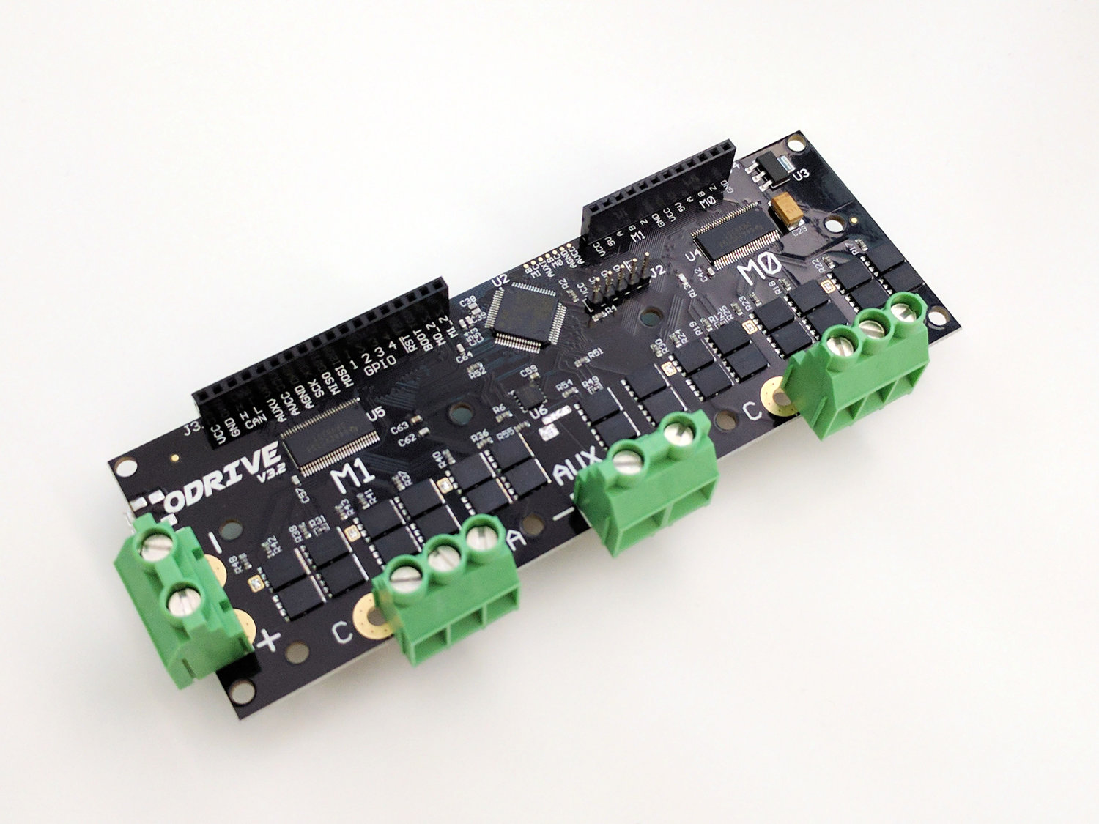
Docs/Fotos/odrive.jpeg
