gabriel-bettanin/LAIKA/Docs/Fotos/OpenTorque.png

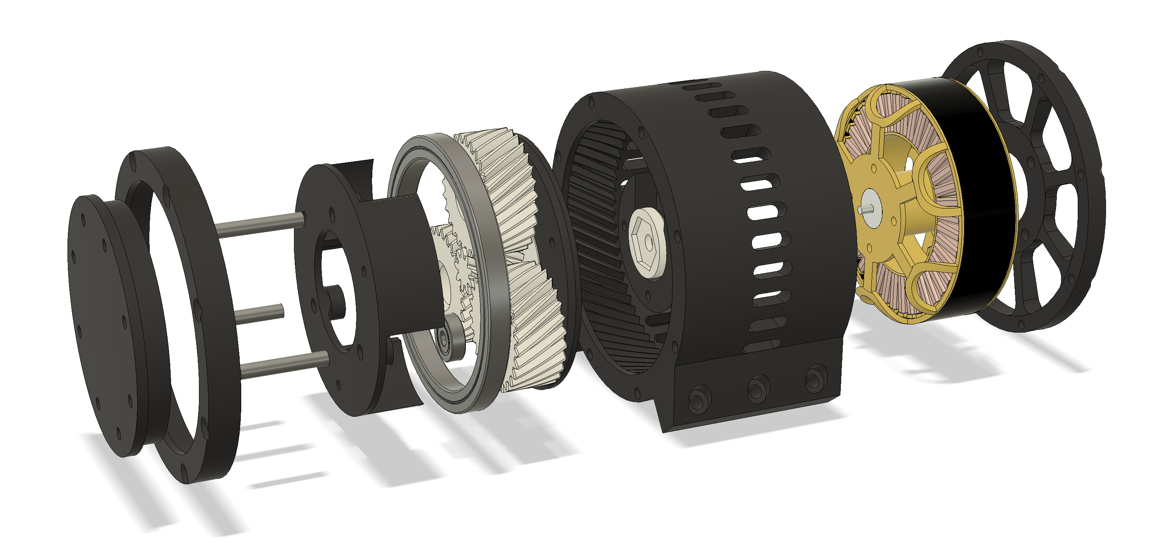
Docs/Fotos/OpenTorque.png
