gabriel-bettanin/LAIKA/Docs/Fotos/papers.JPG

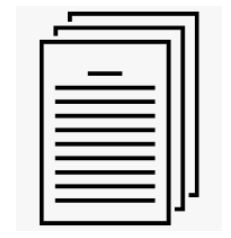
Docs/Fotos/papers.JPG
