gabriel-bettanin/LAIKA/Docs/Fotos/pcb.jpg

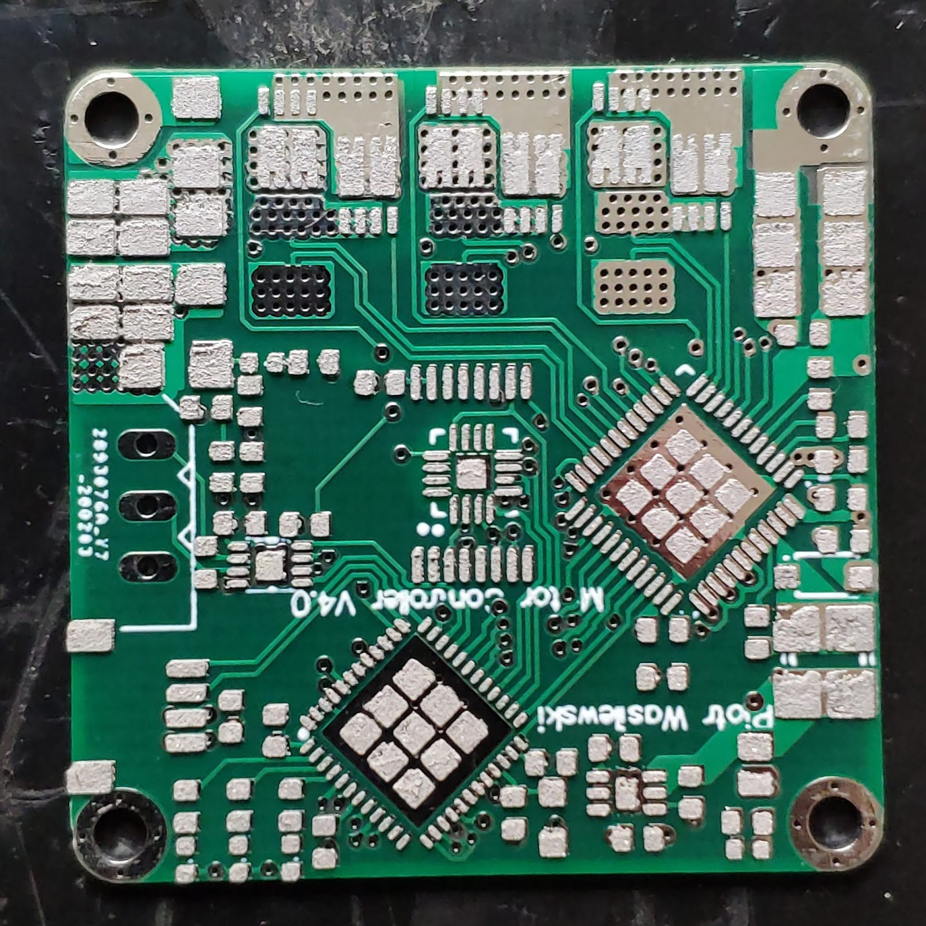
Docs/Fotos/pcb.jpg
