gabriel-bettanin/LAIKA/Docs/Fotos/ring gear.jpg

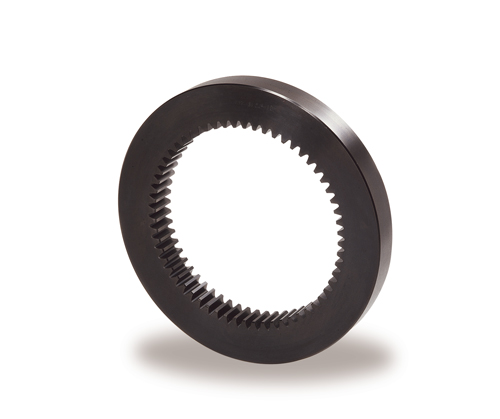
Docs/Fotos/ring gear.jpg
