gabriel-bettanin/LAIKA/Docs/Fotos/spot 3.png

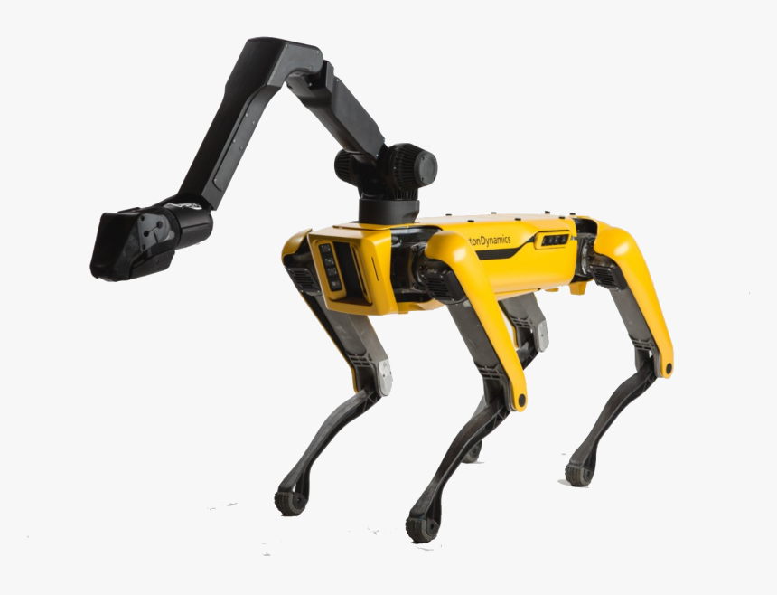
Docs/Fotos/spot 3.png
