gabriel-bettanin/LAIKA/Docs/Fotos/spot.jpeg

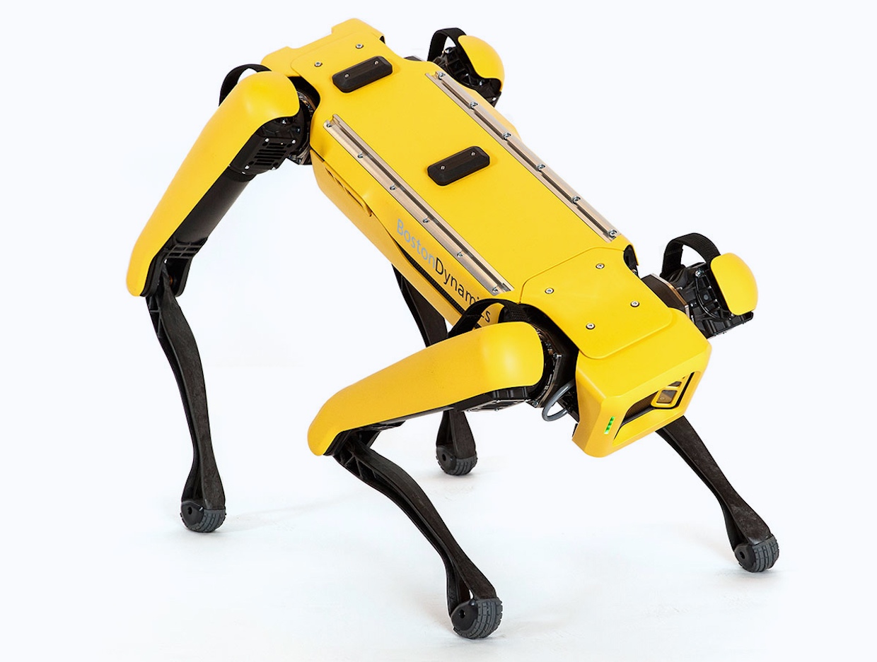
Docs/Fotos/spot.jpeg
