gabriel-bettanin/LAIKA/Docs/Fotos/Spot_field.JPG

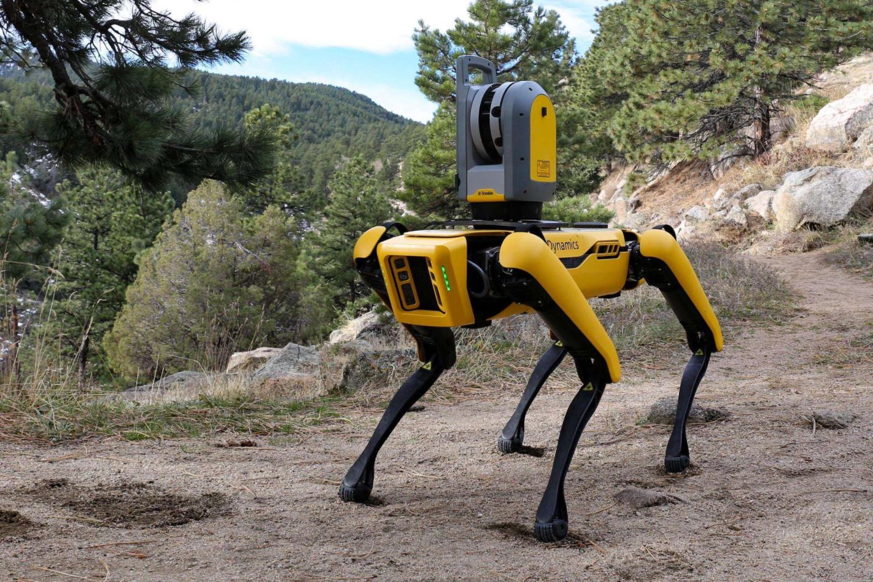
Docs/Fotos/Spot_field.JPG
