gabriel-bettanin/LAIKA/Docs/Fotos/TipTap.png

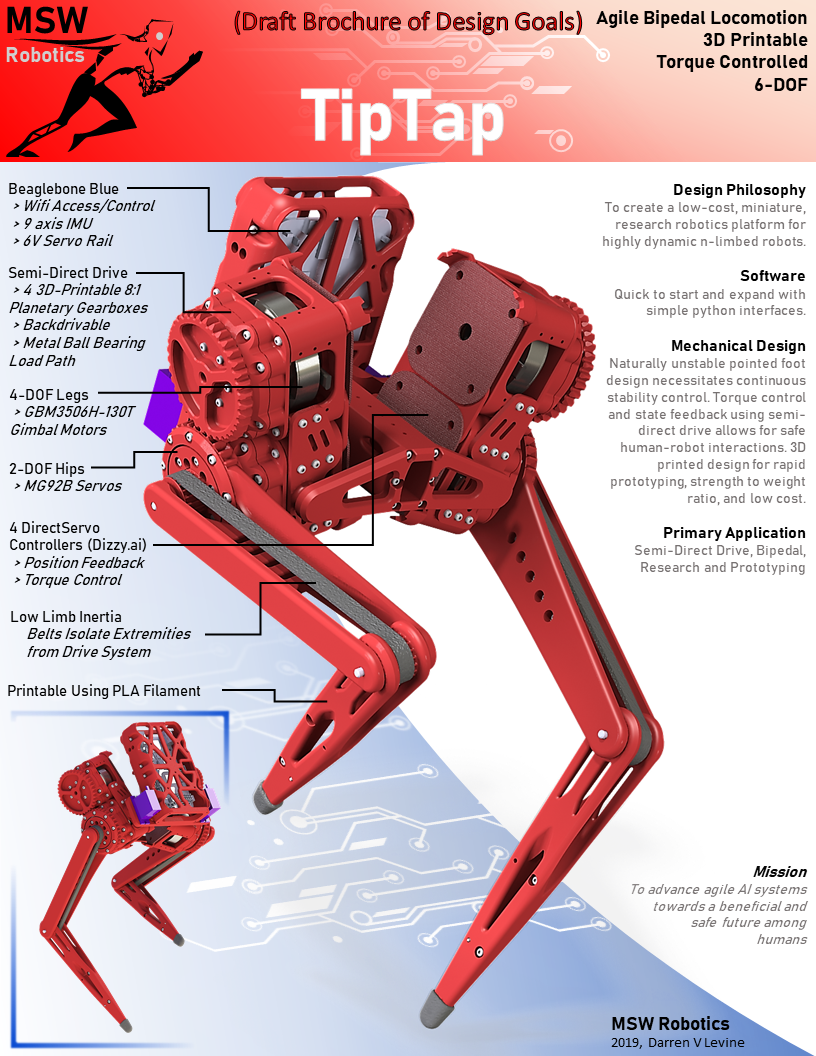
Docs/Fotos/TipTap.png
