gabriel-bettanin/LAIKA/Docs/Fotos/unitree.jpg

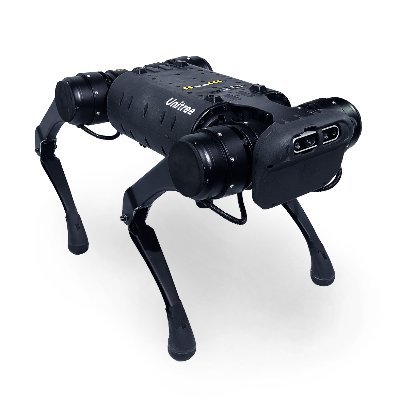
Docs/Fotos/unitree.jpg
