gabriel-bettanin/LAIKA/Docs/Fotos/Vooo-Insights-Image_python_02.png

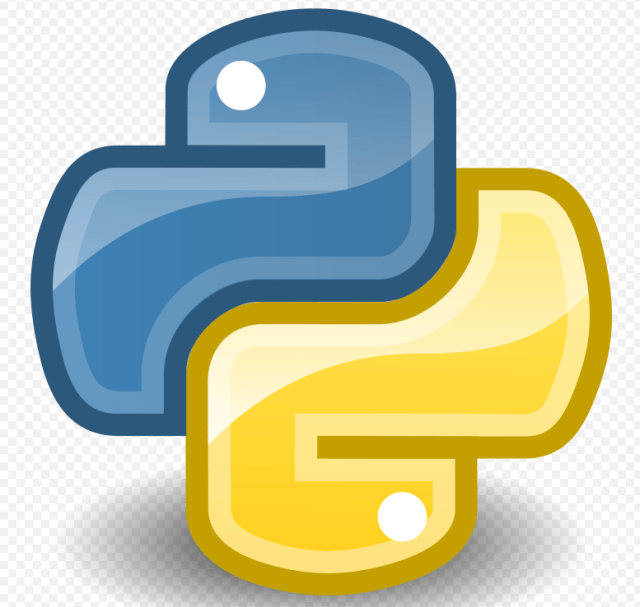
Docs/Fotos/Vooo-Insights-Image_python_02.png
