gabriel-bettanin/LAIKA/References/Windings.JPG

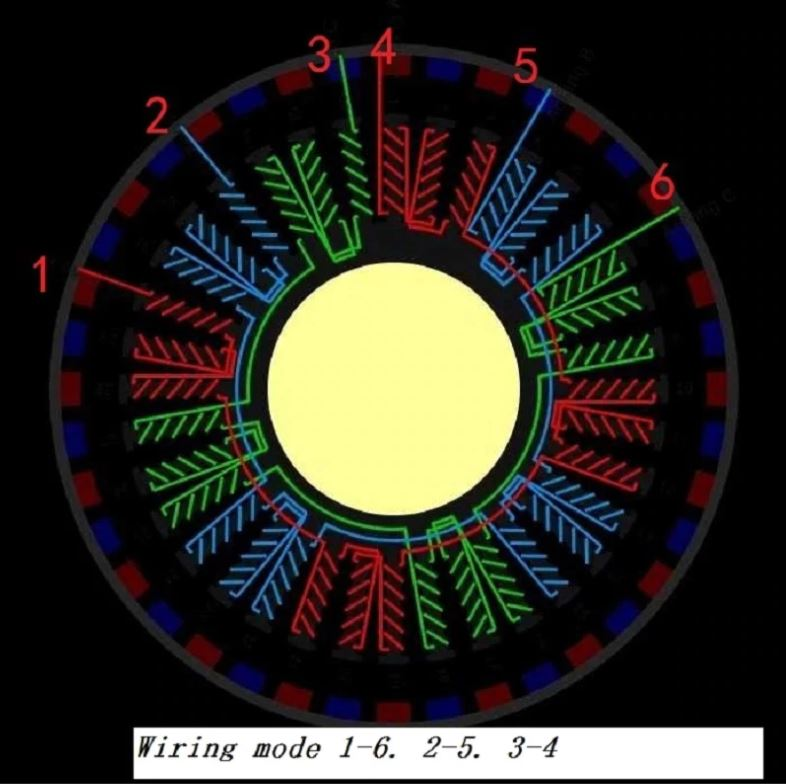
References/Windings.JPG
