gabriel-bettanin/LAIKA/Actuator/Electronics/BOM - Total.xlsx

Qty | Value | Supplier | Link | Price | Device | Package | Parts | Description | Type
1 | 1uF 50v | LCSC (50un) | https://lcsc.com/product-detail/Multilayer-Ceramic-Capacitors-MLCC-SMD-SMT_Samsung-Electro-Mechanics-CL10A105KB8NNNC_C15849.html | $0.39 | C-USC0603K | C0603K | C6 | CAPACITOR, American symbol | Capacitors
1 | 4.7uF 10v | LCSC (50un, C0603K) | https://lcsc.com/product-detail/Multilayer-Ceramic-Capacitors-MLCC-SMD-SMT_Samsung-Electro-Mechanics-CL10A475KP8NNNC_C1705.html | $0.27 | C-USC0402K | C0402K | C9 | CAPACITOR, American symbol
1 | 47nF 50v | LCSC (50un) | https://lcsc.com/product-detail/Multilayer-Ceramic-Capacitors-MLCC-SMD-SMT_Samsung-Electro-Mechanics-CL05B473KB5VPNC_C307339.html | $0.61 | C-USC0402K | C0402K | C5 | CAPACITOR, American symbol
2 | .1uF 50v | LCSC (50un) | https://lcsc.com/product-detail/Multilayer-Ceramic-Capacitors-MLCC-SMD-SMT_Samsung-Electro-Mechanics-CL10B104JB8NNNC_C24452.html | $0.37 | C-USC0603K | C0603K | C2, C4 | CAPACITOR, American symbol
3 | 1uF 10v | LCSC (50un) | https://lcsc.com/product-detail/Multilayer-Ceramic-Capacitors-MLCC-SMD-SMT_Samsung-Electro-Mechanics-CL05A105KP5NNNC_C14445.html | $0.29 | C-USC0402K | C0402K | C7, C10, MC1 | CAPACITOR, American symbol
3 | 22uF 10v | LCSC (50un) | https://lcsc.com/product-detail/Multilayer-Ceramic-Capacitors-MLCC-SMD-SMT_Murata-Electronics-GRM188R61A226ME15D_C84419.html | $1.89 | C-USC0603K | C0603K | C3, C19, C20 | CAPACITOR, American symbol
3 | DNP | DNP |  |  | C-USC0402K | C0402K | YCAP1, YCAP2, YCAP3 | CAPACITOR, American symbol
8 | .1uF 10v | LCSC (100un) | https://lcsc.com/product-detail/Multilayer-Ceramic-Capacitors-MLCC-SMD-SMT_Walsin-Tech-Corp-0402B104K100CT_C387941.html | $0.17 | C-USC0402K | C0402K | C18, C27, C31, C32, C33, C34, C41, VREFCAP | CAPACITOR, American symbol
17 | 10uF 50v | LCSC (200un) | https://lcsc.com/product-detail/Multilayer-Ceramic-Capacitors-MLCC-SMD-SMT_Samsung-Electro-Mechanics-CL31A106KBHNNNE_C13585.html | $7.32 | C-USC1206K | C1206K | C1, C8, C11, C12, C13, C14, C15, C16, C17, C21, C22, C23, C24, C25, C26, C28, C29 | CAPACITOR, American symbol
1 | 150kΩ 1% | LCSC (100un) | https://lcsc.com/product-detail/Chip-Resistor-Surface-Mount_KOA-Speer-Elec-RK73H1ETTP1503F_C159955.html | $0.25 | R-US_R0402 | R0402 | R26 | RESISTOR, American symbol | Resistors
1 | 54.9kΩ 1% | LCSC (100un) | https://lcsc.com/product-detail/Chip-Resistor-Surface-Mount_YAGEO-RC0402FR-0754K9L_C137959.html | $0.07 | R-US_R0402 | R0402 | R1 | RESISTOR, American symbol
2 | 10kΩ | LCSC (100un) | https://lcsc.com/product-detail/Chip-Resistor-Surface-Mount_Viking-Tech-AS02FTE1002_C304153.html | $0.20 | R-US_R0402 | R0402 | R3, R4 | RESISTOR, American symbol
2 | 10kΩ 1% |  |  |  | R-US_R0402 | R0402 | R2, R27 | RESISTOR, American symbol
2 | 200Ω | LCSC (100un) | https://lcsc.com/product-detail/Chip-Resistor-Surface-Mount_Resistor-Today-AECR0402F200RK9_C328309.html | $0.18 | R-US_R0402 | R0402 | R5, R22 | RESISTOR, American symbol
2 | .001Ω | LCSC (30un, R2512) | https://lcsc.com/product-detail/Chip-Resistor-Surface-Mount_Vishay-Intertech-WSL25121L000FEA18_C149567.html | $7.68 | R-US_R1210 | R1210 | R6, R7 | RESISTOR, American symbol
6 | TPH | LCSC (72un, TPH2R608NH,L1Q) | https://lcsc.com/product-detail/MOSFET_TOSHIBA-TPH2R608NH-L1Q_C146377.html | $93.30 | TPH | TPH5900CNH,L1Q | Q1, Q2, Q3, Q4, Q5, Q6 | Silicon N-channel MOSFET | MOSFETs
1 | CSTCE | LCSC (15un, 3213) | https://lcsc.com/product-detail/Ceramic-Resonators_Murata-Electronics-CSTCE8M00G52-R0_C22549.html | $2.87 | CSTCE8M00G15C99-R0 | SMD/SMT | XT1 | 8MHz Ceramic Resonator | Resonators
1 | 500mA 60V | LCSC (20un) | https://lcsc.com/product-detail/Schottky-Barrier-Diodes-SBD_Changjiang-Electronics-Tech-CJ-MBR0560_C77338.html | $0.60 | MBR0520 | SOD123 | D1 | Schottky Barrier Diode | Diodes
2 | GREEN | LCSC (40un) | https://lcsc.com/product-detail/Light-Emitting-Diodes-LED_Everlight-Elec-19-217-GHC-YR1S2-3T_C72043.html | $0.98 | LED0603 | LED0603 | LED1, LED2 | LEDs
1 | 22uH | LCSC (15un, 4.5x4x3.2mm) | https://lcsc.com/product-detail/Power-Inductors_BOURNS-SDR0403-220ML_C139479.html | $2.89 | SDR0302 | SDR0302 | L1 | POWER INDUCTOR | Inductors
1 | 600Ω | LCSC (20un) Mouser(1210) | https://lcsc.com/product-detail/Common-Mode-Chokes-Filters_EMTEK-CMF2012F-601M-2P-T_C252127.html | $1.81 | INDUCTOR0603 | INDUCTOR0603 | CHOKE | Inductors
1 | STM32F446RET6 | AliExpress (10un) | https://pt.aliexpress.com/item/1005001658454277.html?spm=a2g0o.cart.0.0.5ca63c002DVQYl&mp=1 | $89.40 | STM32F446RET6 | TQFP64 | U$3 | ARM DSP Chip used on the WAV Trigger board. | ICs
1 | DRV8323RH | AliExpress (15un) | https://pt.aliexpress.com/item/4001211591250.html?spm=a2g0o.cart.0.0.70de3c00iFTwoO&mp=1 | $77.76 | DRV8323RH | QFN50P700X700X90-49N | U$1
1 | MA700 | Ali Express (20un) | https://pt.aliexpress.com/item/4001190707122.html?spm=a2g0o.cart.0.0.70de3c00iFTwoO&mp=1 | $34.40 | MA700 | QFN16 | U$11
1 | MCP2542 | LCSC (15un) | https://lcsc.com/product-detail/CAN-ICs_Microchip-Tech-MCP2542FDT-E-MNY_C114028.html | $14.00 | MCP2542 | TDFN-8 | U$6
1 | LDFM | LCSC (15un, NCP176AM) | https://lcsc.com/product-detail/Dropout-Regulators-LDO_ON-Semiconductor-NCP176AMX330TCG_C233363.html | $2.10 | NCP176AMX330TCG (LDFM33PUR) | DFN6-3X3 | LDFM33PUR | Low drop voltage regulator
1 | SM07B-SRSS-TB | LCSC (15un) | https://lcsc.com/product-detail/Wire-To-Board-Wire-To-Wire-Connector_JST-Sales-America-SM07B-SRSS-TB-LF-SN_C160406.html | $3.13 | SM07B-SRSS-TB | SM07B-SRSS-TB | PROG | Disconnectable Crimp style connector, 1.0mm pitch7 contacts | Connectors
1 | XT30 | LCSC (15un, XT30PW-M) | https://lcsc.com/product-detail/Wire-To-Board-Wire-To-Wire-Connector_JST-Sales-America-SM03B-SRSS-TB-LF-SN_C160403.html | $1.42 | XT30 | XT30_HORIZONTAL | U$9
1 | 5267-3 | LCSC (15un, SM03B-SRSS) | https://lcsc.com/product-detail/Power-Connectors_Changzhou-Amass-Elec-XT30PW-M_C431092.html | $6.60 | 5267-3 | 5267-3 | CAN
3 | 18_AWG_PAD |  |  |  | 18_AWG_PAD | 18_AWG_PAD | U$2, U$4, U$5
 |  |  |  | $350.95
 |  |  |  | R$1754.75
12 | A12 BLDC Motor | AliExpress (12un) | https://www.aliexpress.com/item/4000772646221.html?spm=a2g0s.9042311.0.0.5654b90asmshLd | $480.00 | Mecânica
12 | Planetary Gearbox | AliExpress (12un) | https://pt.aliexpress.com/item/4000811410917.html?spm=a2g0s.9042311.0.0.5654b90asmshLd | $528.00
 |  |  |  | $1008.00
 |  |  |  | R$5040.00
3 | Filamento PETG 1.75mm 1kg | Boa Impressão 3D (3un) | https://boaimpressao3d.com.br/shop/filamentos-para-impressora-3d/petg/petg-1kg/petg-1kg-carretel/filamento-petg-1-75mm-impacto-preto-1kg-material-3d/ | R$495 | Impressão 3D
3 | Filamento PLA 1.75mm 1kg | Boa Impressão 3D (3un) | https://boaimpressao3d.com.br/shop/filamentos-para-impressora-3d/pla/1kg/pla-1kg-carretel/filamento-material-3d-pla-1-75mm-branco-1kg/ | R$450
 |  |  |  | R$945
4 | Bateria 11.1V 5000mAh | Aliexpress (4un) | https://www.aliexpress.com/item/1005001444690413.html | $160.00 | Baterias
 |  |  |  | R$800.00
1 | NVIDIA Jetson Nano 2GB Developer Kit | Aliexpress (1un) | https://www.aliexpress.com/item/1005001688933784.html | $70.00 | Controle
1 | Teensy 4.1 | Aliexpress (1un) | https://www.aliexpress.com/item/4001148959991.html | $40.00
1 | Raspberry 4b | Aliexpress (1un) | https://www.aliexpress.com/item/4000054868537.html | $62.00
 |  |  |  | $172.00
 |  |  |  | R$860.00
 | Total | R$9399.75
