gabriel-bettanin/LAIKA/Actuator/Electronics/LCSC_Components.xlsx

"LCSC Part Number" | Manufacture Part Number | Manufacturer | Customer NO. | Package | Description | RoHS | Order Qty. | Min\Mult Order Qty. | Unit Price | Order Price
C1591 | CL10B104KB8NNNC | Samsung Electro-Mechanics |  | 1206 | 10uF Â±10% 50V X5R 1206 | YES | 200 | 10\10 | $0.046900 | $9.38
C13585 | CL31A106KBHNNNE | Samsung Electro-Mechanics |  | 603 | 100nF Â±10% 50V X7R 0603 | YES | 100 | 50\50 | $0.004800 | $0.48
C15849 | CL10A105KB8NNNC | Samsung Electro-Mechanics |  | 603 | 1uF Â±10% 50V X5R 0603 | YES | 100 | 50\50 | $0.010400 | $1.04
C19666 | CL10A475KO8NNNC | Samsung Electro-Mechanics |  | 603 | 4.7uF Â±10% 16V X5R 0603 | YES | 50 | 50\50 | $0.013900 | $0.70
C24452 | CL10B104JB8NNNC | Samsung Electro-Mechanics |  | 603 | 100nF Â±5% 50V X7R 0603 | YES | 50 | 50\50 | $0.007800 | $0.39
C84419 | GRM188R61A226ME15D | Murata Electronics |  | 603 | 22uF Â±20% 10V X5R 0603 | YES | 50 | 10\10 | $0.040600 | $2.03
C282684 | TCC0603X7R473K500CT | CCTC |  | 603 | 47nF Â±10% 50V X7R 0603 | YES | 50 | 50\50 | $0.004900 | $0.25
C22807 | 0603WAF1503T5E | UNI-ROYAL(Uniroyal Elec) |  | 603 | 150kÎ© Â±1% 0.1W Â±100ppm 0603 | YES | 100 | 100\100 | $0.001400 | $0.14
C23077 | 0603WAF5492T5E | UNI-ROYAL(Uniroyal Elec) |  | 603 | 54.9kÎ© Â±1% 0.1W Â±100ppm0603 | YES | 100 | 100\100 | $0.001400 | $0.14
C98220 | RC0603FR-0710KL | YAGEO |  | 603 | 10kÎ© Â±1% 0.1W Â±100ppm 0603 | YES | 100 | 100\100 | $0.001500 | $0.15
C163878 | WR06X2000FTL | Walsin Tech Corp |  | 603 | 200Î© Â±1% 0.1W Â±100ppm 0603 | YES | 100 | 100\100 | $0.001300 | $0.13
C914835 | PA1206FRF470R001Z | YAGEO |  | 1206 | 0.001Î© Â±1% 1W Â±100ppm 1206 | YES | 20 | 5\5 | $0.117700 | $2.35
C72043 | 19-217/GHC-YR1S2/3T | Everlight Elec |  | 603 | Green 520~535nm 0603 | YES | 40 | 20\20 | $0.030200 | $1.21
C77338 | MBR0560 | Changjiang Electronics Tech (CJ) |  | SOD-123 | 60V 500mA 700mV @ 500mA SOD-123 | YES | 20 | 20\20 | $0.035200 | $0.70
C22549 | CSTCE8M00G52-R0 | Murata Electronics |  | 3213 | 8MHz Â±0.5% 10pF 40Î© 3213 | YES | 7 | 1\1 | $0.251000 | $1.76
C307600 | LQH32PH220MNCL | Murata Electronics |  | 1210 | 22uH Â±20% 550mA 685mÎ© 1210 Inductors | YES | 10 | 1\1 | $0.211500 | $2.12
C216132 | SBM1608G601GSP | Sunltech Tech |  | 603 | 600Î© @ 100MHz 500mA 1 500mÎ© 0603 Ferrite Beads | YES | 50 | 50\50 | $0.004500 | $0.23
C114028 | MCP2542FDT-E/MNY | Microchip Tech |  | TDFN-8 | Transceiver CAN 1/1 8Mbps TDFN-8 CAN ICs RoHS | YES | 7 | 1\1 | $1.485900 | $10.40
C233363 | NCP176AMX330TCG | ON Semiconductor |  | XDFN-6 | Fixed 5.5V 3.3V 165mV @ 500mA XDFN-6 Dropout Regulators(LDO) RoHS | YES | 10 | 1\1 | $0.127000 | $1.27
C458253 | PSMN1R4-40YLDX | Nexperia |  | SOT669 | N-Channel 40V 100A(Tc) 2.2V @ 1mA 1.4mÎ© @ 25A,10V 238W(Tc) SOT669 MOSFET RoHS | YES | 30 | 1\1 | $0.714100 | $21.42
 |  |  |  |  |  |  |  |  |  | =SOMA(K3:K13)
