gabriel-bettanin/LAIKA/Actuator/Financial/Costs.xlsx

 | NOME | QTD | CUSTO UN | CUSTO | FRETE | TAXA | CUSTO TOTAL
Bangood | Baterias | 3 | R$70.77 | R$212.31 | R$76.05 | R$0 | R$288.36
Mercado Livre | Fio de Cobre | 1 | R$65.00 | R$65.00 | R$0 | R$0 | R$65.00
 | ESC e conectores | 1 | R$112.00 | R$112 | R$25.90
JLCPCB | PCB Driver | 10 | R$7.85 | R$78.54 | R$124.02 | R$0 | R$202.56
 | Stencil Driver | 1 | R$39.55 | R$39.55 | R$124.02 | R$0 | R$163.57
 | PCB CAN | 10 | R$2.81 | R$28.05 | R$124.02 | R$0 | R$152.07
 | Stencil CAN | 1 | R$39.55 | R$39.55 | R$124.02 | R$0 | R$163.57
LCSC | Componentes LCSC | 1 | R$315.68 | R$315.68 | R$69.99 | R$0 | R$385.67
Mouser | Componentes Mouser | 1 | R$514.70 | R$514.70 | R$203.10 | R$747.1 | R$1464.90
AliExpress | Conectores JST 7 | 10 | R$0.69 | R$6.91 | R$13.12 | R$0 | R$20.04
 | Conectores JST 3 | 10 | R$0.46 | R$4.60 | R$13.13 | R$0 | R$17.73
 | Sensor Hall | 5 | R$11.40 | R$56.98 | R$9.09 | R$0 | R$66.07
 | STM32 | 5 | R$30.22 | R$151.08 | R$0 | R$0 | R$151.08
 | Conectores XT30 | 10 | R$1.97 | R$19.68 | R$29.47 | R$0 | R$49.15
 | Engrenagens | 3 | R$228.85 | R$686.55 | R$0 | R$0 | R$686.55
 | Motores | 3 | R$220.40 | R$661.21 | R$116.12 | R$0 | R$777.33
