gabriel-bettanin/LAIKA/References/Controllers/MIT Electronics/0_BOM_V2.xlsx

Device | Qty | Parts | Manufacturer | Manufacturer # | Vendor | Vendor # | Cost Each (1) | Cost Each (100) | Cost Each (500)
MOSFET | 6 | Q1-Q6 | NXP | PSMN3R3-40YS,115 | Digikey | 568-5590-1-ND | 1.18 | 0.8195 | 0.67776 | 7.08 | 4.917 | 4.06656
DRV8302 | 1 | U1 | TI | DRV8302DCAR | Digikey | 296-29544-1-ND | 6.14 | 4.5225 | 3.8475 | 6.14 | 4.5225 | 3.8475
1 mOhm 1% 1210 | 2 | R13, R14 | Rohm | PMR25HZPFV1L00 | Digikey | RHM.001APCT-ND | 0.64 | 0.3593 | 0.25994 | 1.28 | 0.7186 | 0.51988
10 Ohm 0603 | 6 | R1-R6 | Yageo | RC0603JR-0710RL | Digikey | 311-10GRCT-ND | 0.1 | 0.0044 | 0.0027 | 0.6 | 0.0264 | 0.0162
10k 0603 | 6 | R7-R12, R19 | Yageo | RC0201JR-0710KL | Digikey | 311-10KNCT-ND | 0.1 | 0.0166 | 0.01014 | 0.6 | 0.0996 | 0.06084
.1 uF 50V 0603 | 10 | C11, C12, C13, C14, C16, C25, C27, C29, C31, C32, R25 | Kemet | C0603C104M5RACTU | Digikey | 399-7845-1-ND | 0.1 | 0.0121 | 0.00848 | 1 | 0.121 | 0.0848
10 uF 50V 1206 | 16 | C1-C6 | Samsung | CL31B106KBHNNNE | Digikey | 1276-6767-1-ND | 0.33 | 0.1367 | 0.10248 | 5.28 | 2.1872 | 1.63968
 | 2 | C7, C8 |  | UHE1V151MPD | Digikey | 493-1577-ND | 0.38 | 0.1518 | 0.11858 | 0.76 | 0.3036 | 0.23716
1 uF 50V 0603 | 3 | C10, C18, C19 | Yaiyo Yuden | UMK107AB7105KA-T | Digikey | 87-3247-1-ND | 0.25 | 0.0989 | 0.06982 | 0.75 | 0.2967 | 0.20946
4.7 uF 50V 0805 | 4 | C9, C15, C17, C21, | Samsung | CL21A475KBQNNNE | Digikey | 1276-1248-1-ND | 0.4 | 0.173 | 0.12608 | 1.6 | 0.692 | 0.50432
10 uF 10V 0805 | 1 | C30 | Murata | GRM21BR71A106MA73L | Digikey | 490-10517-1-ND | 0.21 | 0.074 | 0.05066 | 0.21 | 0.074 | 0.05066
47 uF 16V 1210 | 1 | C24 | Murata | GRM32ER61C476KE15K | Digikey | 490-6538-1-ND | 0.9 | 0.4554 | 0.36052 | 0.9 | 0.4554 | 0.36052
15 nF 0603 | 2 | C26, C41 | Murata | GRM188R71H153KA01D | Digikey | 490-1514-1-ND | 0.1 | 0.0198 | 0.01386 | 0.2 | 0.0396 | 0.02772
6.8 nF 0603 | 1 | C22 | Murata | GRM188R71H682KA01D | Digikey | 490-1508-1-ND | 0.1 | 0.0182 | 0.0127 | 0.1 | 0.0182 | 0.0127
120 pF 0603 | 1 | C23 | Samsung | CL10B121KB8NNNC | Digikey | 1276-1949-1-ND | 0.1 | 0.0053 | 0.00378 | 0.1 | 0.0053 | 0.00378
22 nF 0603 | 1 | C20 | Murata | GRM188R71C223KA01D | Digikey | 490-1527-1-ND | 0.1 | 0.0209 | 0.01464 | 0.1 | 0.0209 | 0.01464
150K 0603 | 1 | R17 | Panasonic | ERJ-1GEF1503C | Digikey | P150KABCT-ND | 0.1 | 0.0282 | 0.01268 | 0.1 | 0.0282 | 0.01268
200 K 0603 | 1 | R20 | Yageo | RC0603JR-07200KL | Digikey | 311-200KGRCT-ND | 0.1 | 0.0044 | 0.0027 | 0.1 | 0.0044 | 0.0027
16.2 K 1% 0603 | 1 | R21 | Panasonic | ERJ-3EKF1622V | Digikey | P16.2KHCT-ND | 0.1 | 0.0084 | 0.00514 | 0.1 | 0.0084 | 0.00514
49.9 K 1% 0603 | 1 | R18 | Panasonic | ERJ-3EKF4992V | Digikey | P49.9KHCT-ND | 0.1 | 0.0084 | 0.00514 | 0.1 | 0.0084 | 0.00514
22 uH | 1 | L1 | Bourns | SRN4018-220M | Digikey | SRN4018-220MCT-ND | 0.36 | 0.24 | 0.208 | 0.36 | 0.24 | 0.208
1.5A shotkey | 1 | D1 | Vishay | VSSA310S-M3/61T | Digikey | VSSA310S-M3/61TGICT-ND | 0.44 | 0.24 | 0.18222 | 0.44 | 0.24 | 0.18222
600R Choke | 1 | Choke | Pulse Electronics | PE-0603FB601ST | Digikey | 553-2384-1-ND | 0.1 | 0.0396 | 0.02112 | 0.1 | 0.0396 | 0.02112
JST 6 Pin | 1 |  | JST | SM06B-SRSS-TB(LF)(SN) | Digikey | 455-1806-1-ND | 0.83 | 0.5996 | 0.52136 | 0.83 | 0.5996 | 0.52136
JST 3 Pin | 2 |  | JST | SM03B-SRSS-TB(LF)(SN) | Digikey | 455-1803-1-ND | 0.53 | 0.379 | 0.3296 | 1.06 | 0.758 | 0.6592
STM32F446RET6 | 1 | Micro | ST | STM32F446RET6 | Digikey | 497-15376-ND | 8.59 | 6.4258 | 5.5955 | 8.59 | 6.4258 | 5.5955
MCP2562 CAN TXRX | 1 |  | Microchip | MCP2562-E/SN | Digikey | MCP2562-E/SN-ND | 0.9 | 0.68 | 0.68 | 0.9 | 0.68 | 0.68
AS5047D Encoder | 1 | Encoder | AMS | AS5047D-ATSM | Digikey | AS5047D-ATSMCT-ND | 12.32 | 6.9157 | 6.9157 | 12.32 | 6.9157 | 6.9157
Red LED 0603 | 2 | LED1, LED2 | Lite-On | LTST-C191KRKT | Digikey | 160-1447-1-ND | 0.29 | 0.1111 | 0.06666 | 0.58 | 0.2222 | 0.13332
200 R 0603 | 2 | R16, R22 | Yageo | RC0603JR-07200RL | Digikey | 311-200GRCT-ND | 0.1 | 0.0046 | 0.0046 | 0.2 | 0.0092 | 0.0092
8 MHz Resonator | 1 | XT1 | Murata | CSTCE8M00G15C99-R0 | Digikey | 490-7857-1-ND | 0.69 | 0.4585 | 0.43556 | 0.69 | 0.4585 | 0.43556
100 uF 50V Electrolytic | 2 | C7, C8 | Panasonic | EEE-FTH101XAP | Digikey | PCE5024CT-ND | 0.78 | 0.3932 | 0.3932 | 1.56 | 0.7864 | 0.7864
 |  |  |  |  |  |  |  |  |  | Qty 1 Total | Qty 100 Total | Qty 500 Total
 |  |  |  |  |  |  |  |  |  | 53.17 | 31.136 | 27.04326
