gabriel-bettanin/LAIKA/Actuator/Financial/Análise Financeira.xlsx

Sheet: Componentes
 | Nome | Fornecedor | Preço unitário | Frete | Qtd mínima | Qtd necessária/atuador | Situação
Motor BLDC | A12 | Swiss Motors (Aliexpress) (https://pt.aliexpress.com/item/4000772646221.html?spm=a2g0s.9042311.0.0.763cb90aiCPONc) | $40.00 | Grátis | 1 | 1 | Necessita manutenção ($10 + 5h de trabalho manual)
 | 8318 | Swiss Motors (Aliexpress) (https://pt.aliexpress.com/item/33012440834.html?spm=a2g0o.detail.1000023.5.1ef533da8Hze1i) | $65.00 | Grátis | 1 | 1 | No máximo 100 peças
 | 8318 | Freeerchgobby (Alibaba) (https://www.alibaba.com/product-detail/8318-Powerful-48V-Brushless-DC-Agriculture_60720257248.html) | $55.00 | $1700 | >= 200 (checar site) | 1
Rolamentos | 6812 2RS | Rolibras (https://loja.rolibras.com.br/produto/68122rss-m/) | R$42.00 | R$85 | 1 | 2 | Nacional
 | 6804 2RS | Rolibras (https://loja.rolibras.com.br/produto/68042rss-m/) | R$8.00 |  | 1 | 3 | Nacional
 | 6812 2RS | Zokol Precision Bearings (Aliexpress) (https://pt.aliexpress.com/item/32814750818.html) | $11.42 | $4,99 | 2 | 2 | Qualidade superior
 | 6804 2RS | Zokol Precision Bearings (Aliexpress) (https://pt.aliexpress.com/item/32814742918.html) | $5.97 | $1,98 | 10 | 3
Microcontrolador | STM32F446RET6 | Mouser (https://br.mouser.com/ProductDetail/STMicroelectronics/STM32F446RET6?qs=Ok1pvOkw6%2FqpQsWf8F4wtQ%3D%3D) | $7.87 | $40 | >= 100 (checar site) | 1 | Longo tempo de espera
 | STM32F446RET6 | Aliexpress (https://pt.aliexpress.com/item/4000117736641.html) | $13.00 | $3,72 | 5 | 1 | Em estoque
Driver do motor | DRV8323RS | Mouser (https://br.mouser.com/ProductDetail/Texas-Instruments/DRV8323RSRGZR?qs=Mv7BduZupUiaPRwy%2F9hIqw%3D%3D) | $4.00 | $40 | >= 100 (checar site) | 1 | Longo tempo de espera
 | DRV8323RS | Punuo Industrial (Alibaba) (https://www.alibaba.com/product-detail/Original-spot-DRV8323RSRGZR-screen-printing-DRV8323RS_1600317991515.html) | $27.00 | $15 | >=10 | 1 | Em estoque

Sheet: Custo Geral
 | NOME | QTD | CUSTO UN | CUSTO | FRETE | TAXA | CUSTO TOTAL
Bangood | Baterias | 3 | R$70.77 | R$212.31 | R$76.05 | R$0 | R$288.36
Mercado Livre | Fio de Cobre | 1 | R$65.00 | R$65.00 | R$0 | R$0 | R$65.00
 | ESC e conectores | 1 | R$112.00 | R$112 | R$25.90
JLCPCB | PCB Driver | 10 | R$7.85 | R$78.54 | R$124.02 | R$0 | R$202.56
 | Stencil Driver | 1 | R$39.55 | R$39.55 | R$124.02 | R$0 | R$163.57
 | PCB CAN | 10 | R$2.81 | R$28.05 | R$124.02 | R$0 | R$152.07
 | Stencil CAN | 1 | R$39.55 | R$39.55 | R$124.02 | R$0 | R$163.57
LCSC | Componentes LCSC | 1 | R$315.68 | R$315.68 | R$69.99 | R$0 | R$385.67
Mouser | Componentes Mouser | 1 | R$514.70 | R$514.70 | R$203.10 | R$747.1 | R$1464.90
AliExpress | Conectores JST 7 | 10 | R$0.69 | R$6.91 | R$13.12 | R$0 | R$20.04
 | Conectores JST 3 | 10 | R$0.46 | R$4.60 | R$13.13 | R$0 | R$17.73
 | Sensor Hall | 5 | R$11.40 | R$56.98 | R$9.09 | R$0 | R$66.07
 | STM32 | 5 | R$30.22 | R$151.08 | R$0 | R$0 | R$151.08
 | Conectores XT30 | 10 | R$1.97 | R$19.68 | R$29.47 | R$0 | R$49.15
 | Engrenagens | 3 | R$228.85 | R$686.55 | R$0 | R$0 | R$686.55
 | Motores | 3 | R$220.40 | R$661.21 | R$116.12 | R$0 | R$777.33
