gabriel-bettanin/LAIKA/References/CAD/Motors and Actuators/SpryDrive/SpryDrive BoM.xlsx

Item Number | Part Name | Per Actuator | Order Quantity | Unit Cost | Total Cost | Source | Alternate Source | Alternate Source 2 (Unverified)
1 | X318S or 9235 Motor | x1 | 1 | $55 ~ $105.50 |  | https://www.alibaba.com/product-detail/X8318S-Electric-Brushless-Motor-For-RC_60743175936.html | https://hobbyking.com/en_us/9235-100kv-turnigy-multistar-brushless-multi-rotor-motor.html | https://www.aliexpress.com/item/32980862851.html
2 | Frame | x1 | 1 | Filament |  | 3D Print - Nylon, ABS, or PLA
3 | Output Plate | x1 | 1 | Filament |  | 3D Print - Nylon, ABS, or PLA
4 | Back Plate | x1 | 1 | Filament |  | 3D Print - Nylon, ABS, or PLA
5 | Bearing Cover | x1 | 1 | Filament |  | 3D Print - Nylon, ABS, or PLA
6 | Magnet Holder | x1 | 1 | Filament |  | 3D Print - Nylon, ABS, or PLA
7 | Encoder Mount | x1 | 1 | Filament |  | 3D Print - Nylon, ABS, or PLA
8 | Output Mounting Plate | x1 | 1 | $29.00 | $29.00 | Sendcutsend.com
9 | Adapter Plate | x1
10 | M4x10 Flat Head Screws (Steel) | x4 | 1 | $1.37 | $1.37 | https://www.aliexpress.com/item/32964226154.html | https://www.mcmaster.com/91294a190
11 | M2x10 Flat Head Screws (Steel) | x16 | 1 | $1.82 | $1.82 | https://www.aliexpress.com/item/32964226154.html | https://www.mcmaster.com/91294a006
12 | M3x8 Ultra-Low Profile Socket Head Screws | x4 | 1 | $2.37 | $2.37 | https://www.aliexpress.com/item/4000231097606.html | https://www.mcmaster.com/90358a002
13 | M4x18 Dowel Pins | x3 | 1 | $5.79 | $5.79 | https://www.mcmaster.com/93600a455
14 | M2 Brass Heat-Set Inserts | x12 | 1 | $8.79 | $8.79 | https://www.mcmaster.com/94459a110 |  | https://www.aliexpress.com/item/4000232526110.html
15 | M2.5 Thin Hex Nuts | x4 | 1 | $2.35 | $2.35 | https://www.mcmaster.com/90710a025 | https://www.aliexpress.com/item/32895301400.html
16 | M4 Hex Nuts (Optional For Mounting) | x4 | 1 | $1.41 | $1.41 | https://www.mcmaster.com/90592a090
17 | Deep Groove Bearing 40x52x7 | x1 | 1 | $19.49 | $19.49 | https://www.vxb.com/6808-2RS-Bearing-Deep-Groove-6808-2RS-p/6808-2rsbearing.htm
18 | AS5048 Encoder Board and Magnet | x1 | 1 | $16.76 | $16.76 | https://www.digikey.com/product-detail/en/ams/AS5048A-TS_EK_AB/AS5048A-AB-1.0-ND/3188612
19 | VersaPlanetary 7:1 Gear Set | x1 | 1 | $14.99 | $14.99 | https://www.vexrobotics.com/versaplanetary.html
20 | VersaPlanetary Ring | x1 | 1 | $9.99 | $9.99 | https://www.vexrobotics.com/217-2816.html
 | TOTAL |  |  |  | $114.13 | Total does not include motor, 3D printing costs, and shipping.
