gabriel-bettanin/LAIKA/Actuator/Electronics/3D Models/JST_Pins/JST/3-Pin JST XH Female/JST(XH) 3Pin .SLDASM

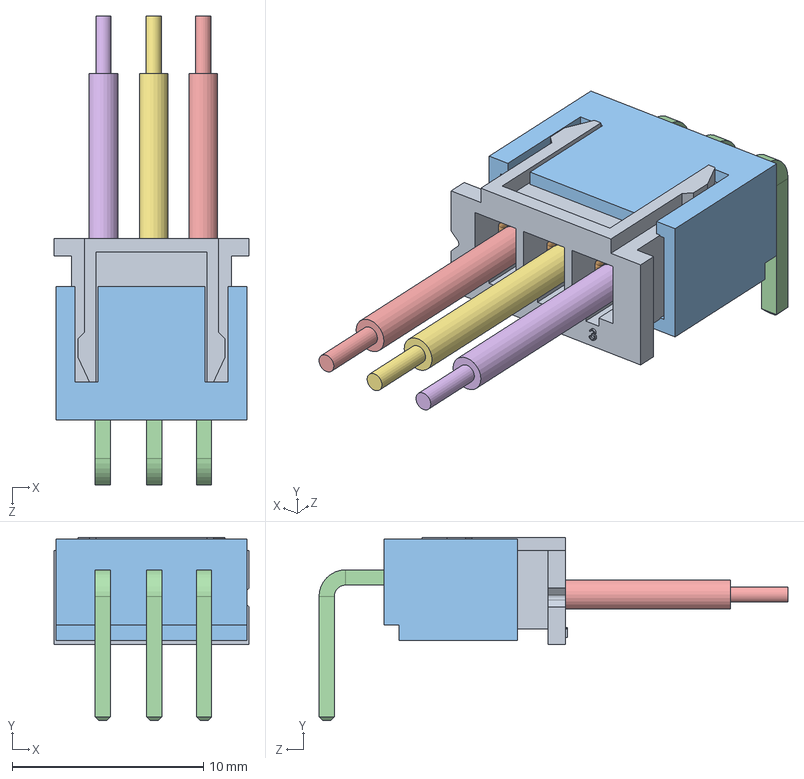
[picture p62: CAD file, 2021-11-09]
Actuator/Electronics/3D Models/JST_Pins/JST/3-Pin JST XH Female/JST(XH) 3Pin .SLDASM
10.2 x 9.60 x 24.6 mm
JST - XH MALE 2S
