gabriel-bettanin/LAIKA/Actuator/Electronics/3D Models/USB2CAN.SLDASM

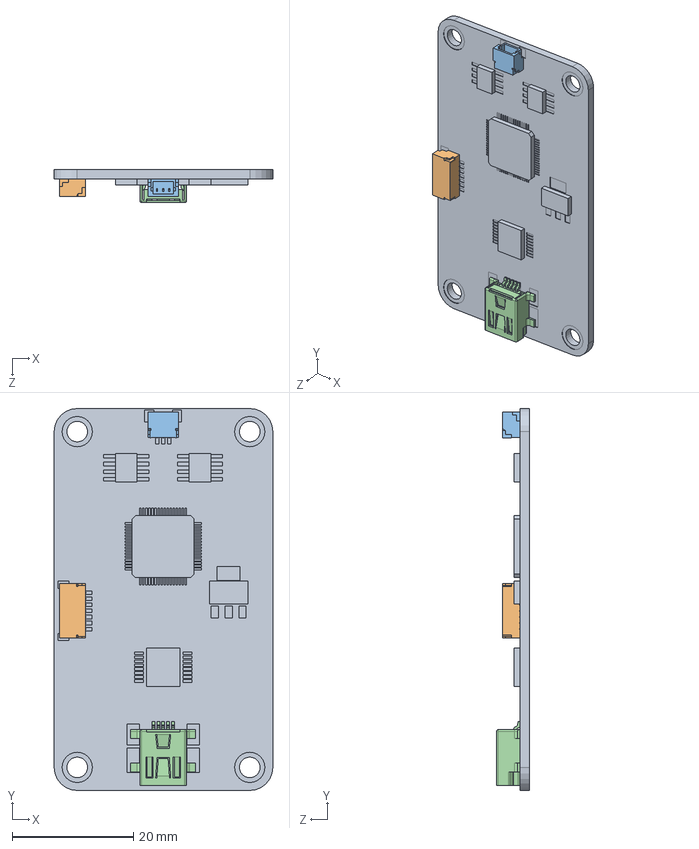
[picture p63: CAD file, 2021-11-09]
Actuator/Electronics/3D Models/USB2CAN.SLDASM
36.1 x 63.0 x 5.50 mm
USB2CAN_Board
JST 7
JST 3
Mini USB
