gabriel-bettanin/LAIKA/Actuator/Mechanics/Planetary Geabox/Gearbox.SLDASM

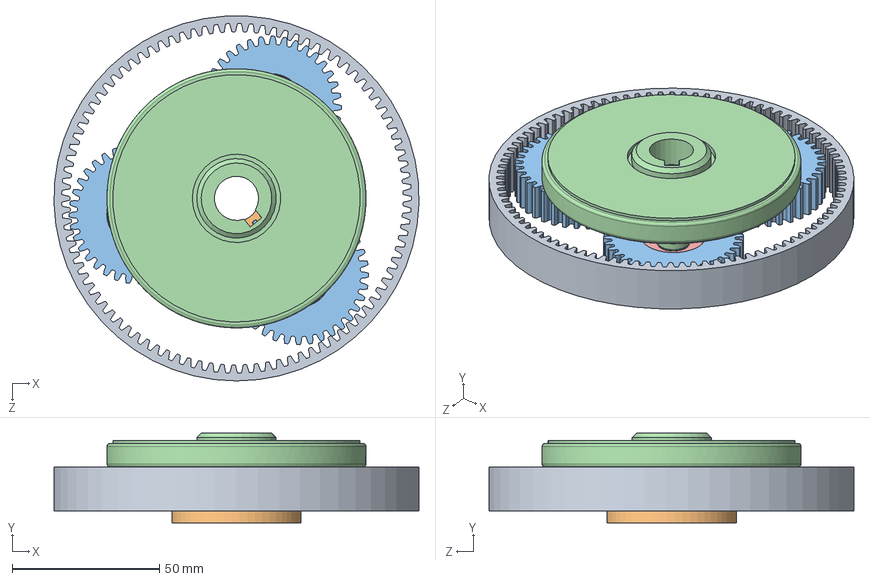
[picture p64: CAD file, 2021-11-09]
Actuator/Mechanics/Planetary Geabox/Gearbox.SLDASM
123.9 x 30.5 x 123.9 mm
Ring gear
Sun Gear
Planet Gear x 3
Planet Carrier
608RS x 3
