gabriel-bettanin/LAIKA/References/CAD/Motors and Actuators/Cheetah_thesis/cam4.SLDASM

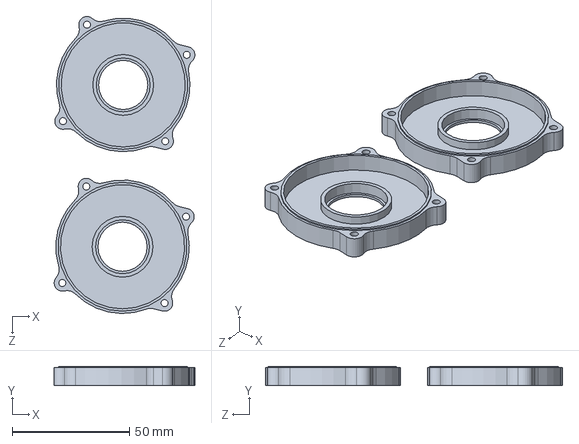
[picture p65: CAD file, 2021-11-09]
References/CAD/Motors and Actuators/Cheetah_thesis/cam4.SLDASM
60.1 x 8.15 x 126.8 mm
Front Housing x 2
