gabriel-bettanin/LAIKA/References/CAD/Motors and Actuators/MOTOR 9235.SLDASM

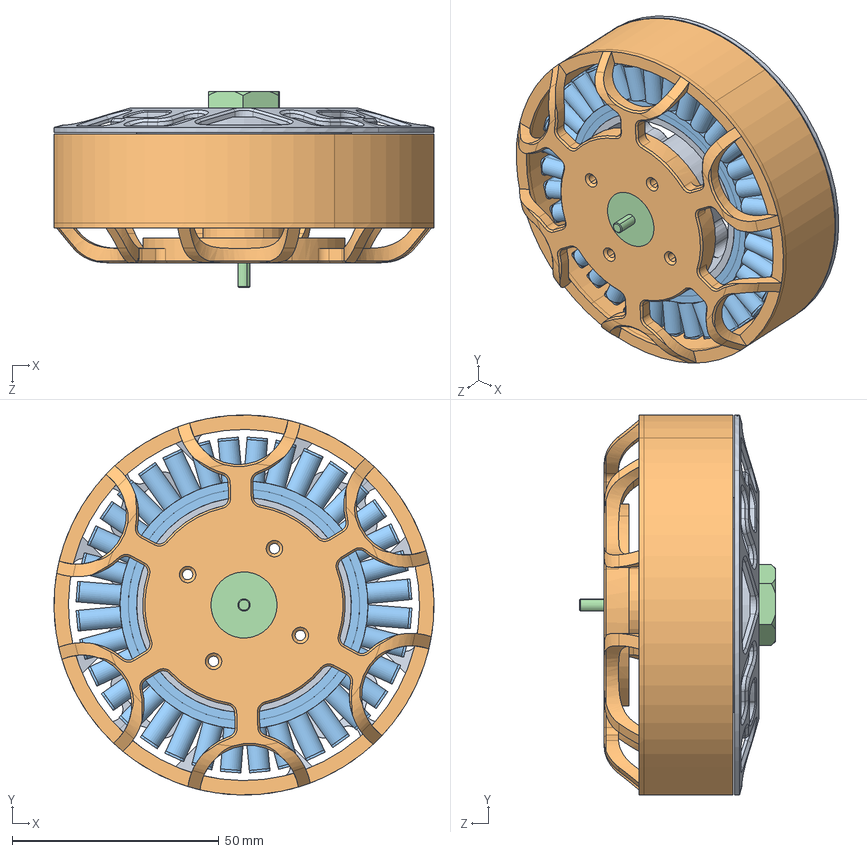
[picture p66: CAD file, 2021-11-09]
References/CAD/Motors and Actuators/MOTOR 9235.SLDASM
92.0 x 92.0 x 47.5 mm
MOTOR BACK HOUSING REV01.STEP
MOTOR ROTOR REV01_9235.STEP
MOTOR STATOR REV01.STEP
MOTOR SHAFT REV01_9235.STEP
NMB L2112KK BEARING.STEP x 2
