gabriel-bettanin/LAIKA/Actuator/Electronics/3D Models/JST_Pins/Assem1.SLDASM

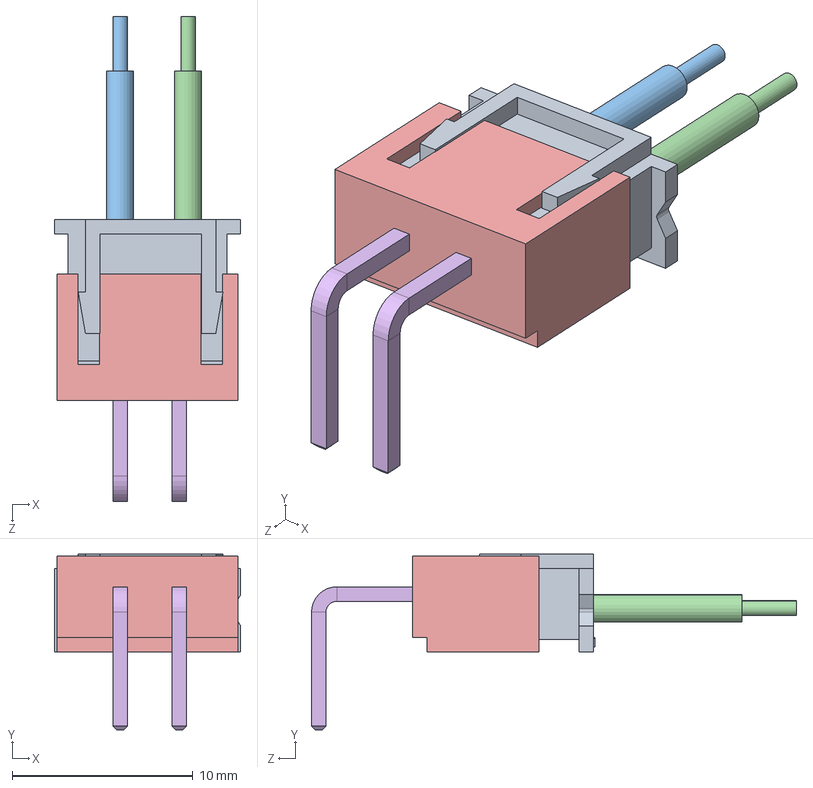
[picture p67: CAD file, 2021-11-09]
Actuator/Electronics/3D Models/JST_Pins/Assem1.SLDASM
10.3 x 9.70 x 26.8 mm
JST - XH MALE 2 pin
