gabriel-bettanin/LAIKA/Actuator/Electronics/3D Models/JST_Pins/JST/4-Pin JST XH Female/Assem1.SLDASM

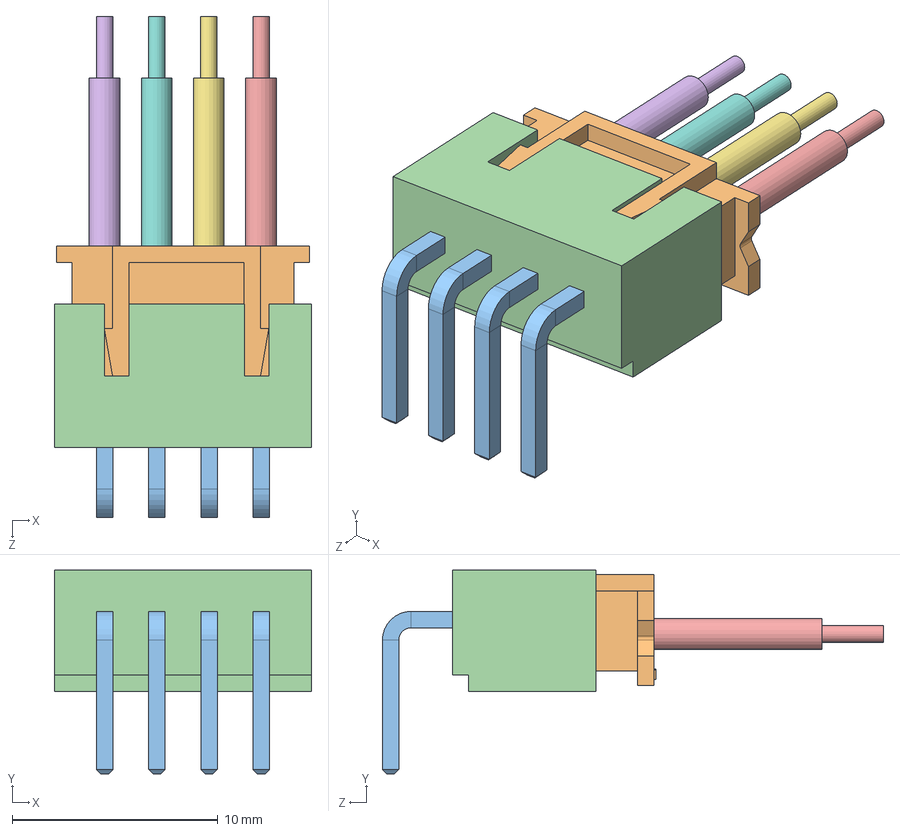
[picture p68: CAD file, 2021-11-09]
Actuator/Electronics/3D Models/JST_Pins/JST/4-Pin JST XH Female/Assem1.SLDASM
12.5 x 9.90 x 24.4 mm
JST - XH MALE 4 pin
