gabriel-bettanin/LAIKA/Actuator/Electronics/3D Models/LAIKA_Driver.SLDASM

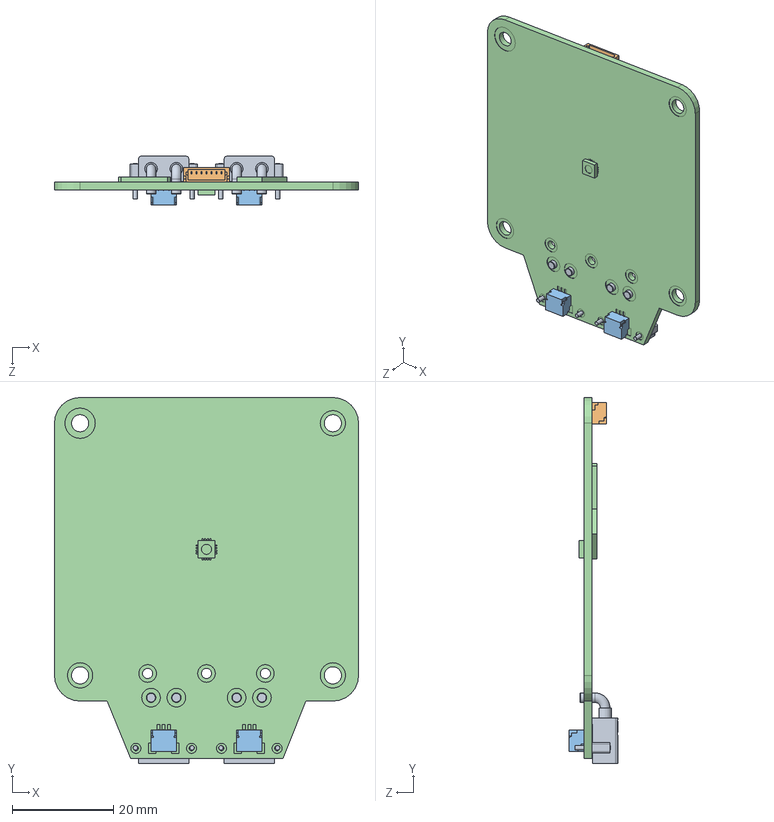
[picture p69: CAD file, 2021-11-09]
Actuator/Electronics/3D Models/LAIKA_Driver.SLDASM
60.1 x 72.3 x 9.60 mm
XT30 x 2
JST 7
JST 3 x 2
LAIKA_Driver_Board
