gabriel-bettanin/LAIKA/Actuator/Electronics/3D Models/XT-60/Adapter.SLDASM

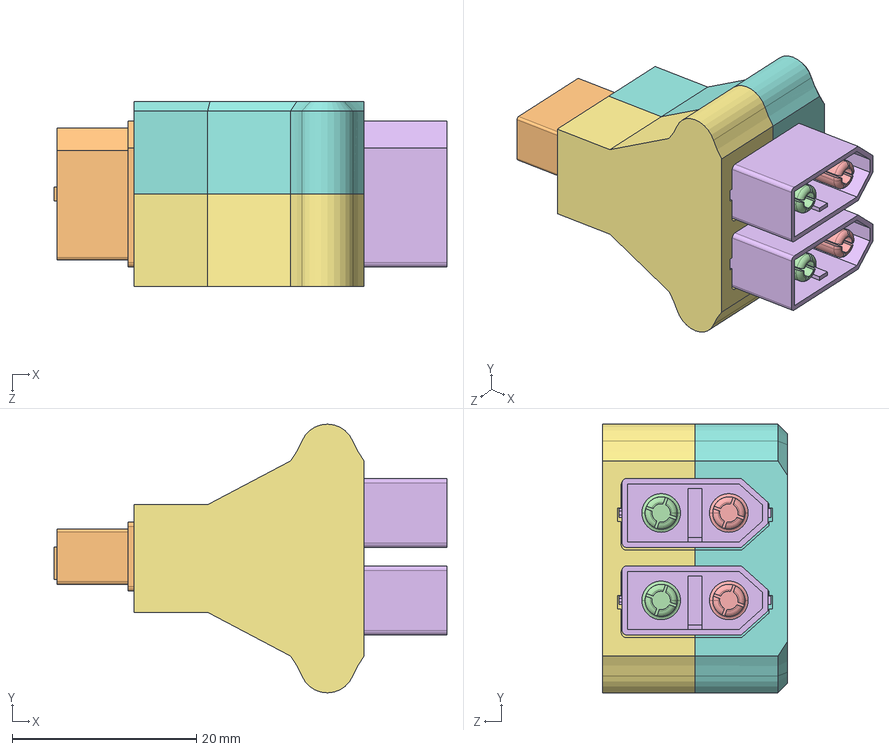
[picture p70: CAD file, 2021-11-09]
Actuator/Electronics/3D Models/XT-60/Adapter.SLDASM
42.7 x 29.2 x 20.0 mm
XT60MaleConnector1.STEP
XT60MaleConnector2.STEP
XT60MaleConnector3.STEP
XT60FemaleConnector1.STEP x 2
XT60FemaleConnector2.STEP x 2
XT60FemaleConnector3.STEP x 2
Adapter Bottom
Adapter Top
