gabriel-bettanin/LAIKA/Actuator/Mechanics/Motor/A12 Motor.SLDASM

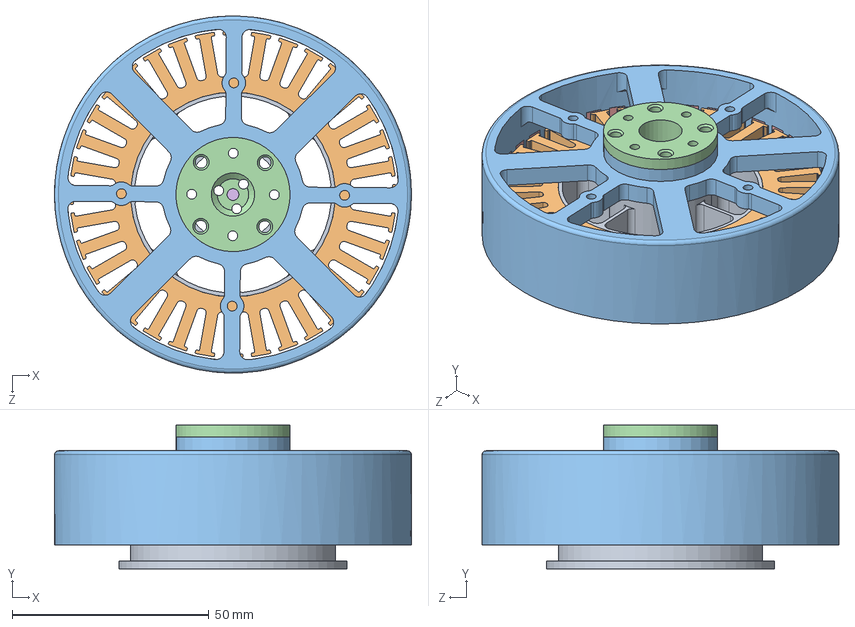
[picture p71: CAD file, 2021-11-09]
Actuator/Mechanics/Motor/A12 Motor.SLDASM
90.7 x 36.5 x 90.7 mm
Middle
Stator
Rotor
Shaft
Magnets
Cap
