gabriel-bettanin/LAIKA/Actuator/Electronics/3D Models/JST_Pins/JST/6-Pin JST XH Female/Assem3.SLDASM

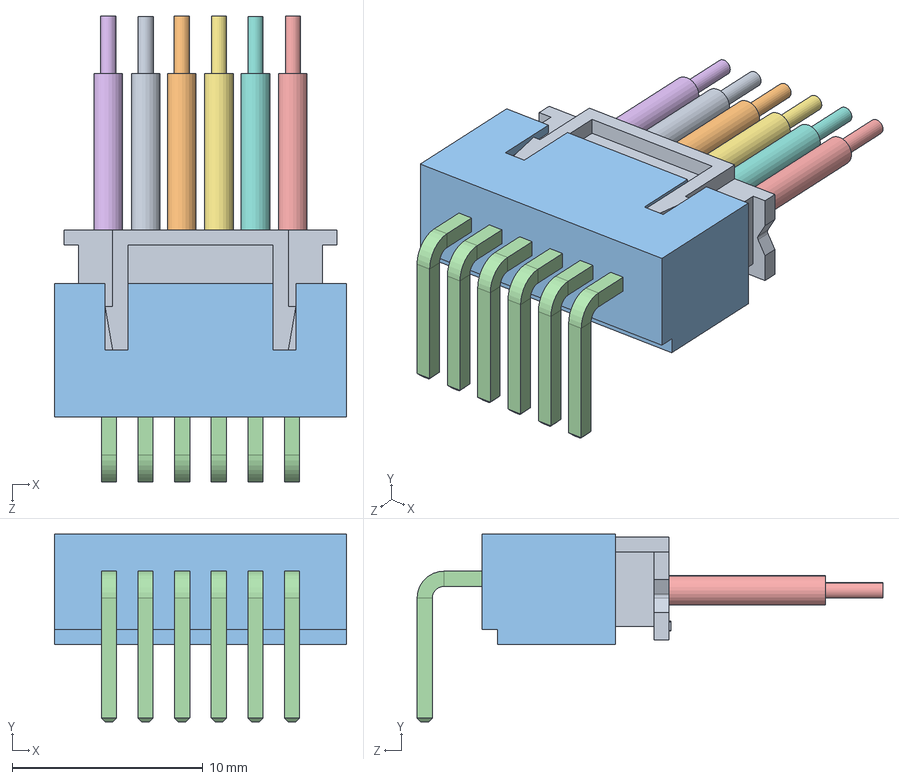
[picture p73: CAD file, 2021-11-09]
Actuator/Electronics/3D Models/JST_Pins/JST/6-Pin JST XH Female/Assem3.SLDASM
15.3 x 9.85 x 24.4 mm
JST - XH MALE 6pin
