gabriel-bettanin/LAIKA/Actuator/Electronics/3D Models/JST_Pins/JST/JST - XH MALE 5 pin/Assem2.SLDASM

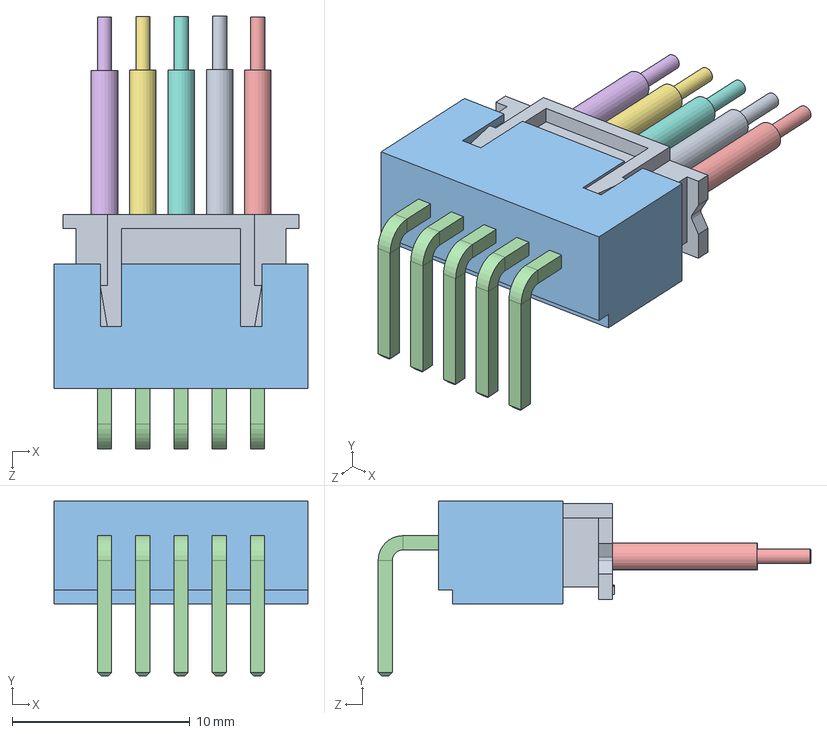
[picture p74: CAD file, 2021-11-09]
Actuator/Electronics/3D Models/JST_Pins/JST/JST - XH MALE 5 pin/Assem2.SLDASM
14.3 x 9.85 x 24.4 mm
JST - XH MALE 5 pin
