gabriel-bettanin/LAIKA/References/CAD/Motors and Actuators/MOTOR 8318.SLDASM

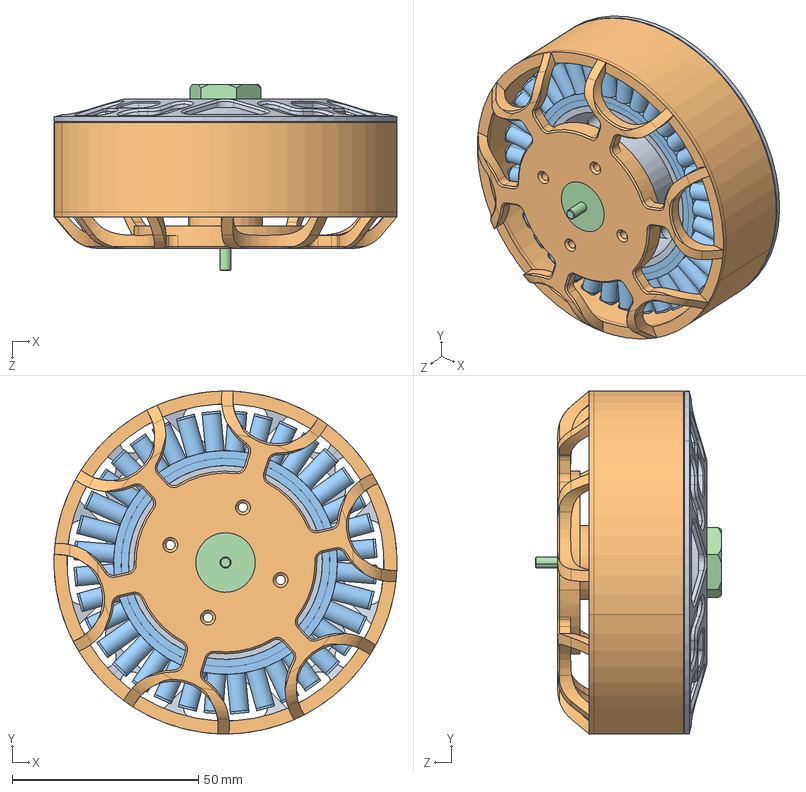
[picture p75: CAD file, 2021-11-09]
References/CAD/Motors and Actuators/MOTOR 8318.SLDASM
92.0 x 92.0 x 50.0 mm
MOTOR BACK HOUSING REV01.STEP
MOTOR ROTOR REV01_X8318S.STEP
MOTOR STATOR REV01.STEP
MOTOR SHAFT REV01_X8318S.STEP
NMB L2112KK BEARING.STEP x 2
