gabriel-bettanin/LAIKA/Actuator/Electronics/3D Models/JST_Pins/JST/7-Pin JST XH Female/Assem1.SLDASM

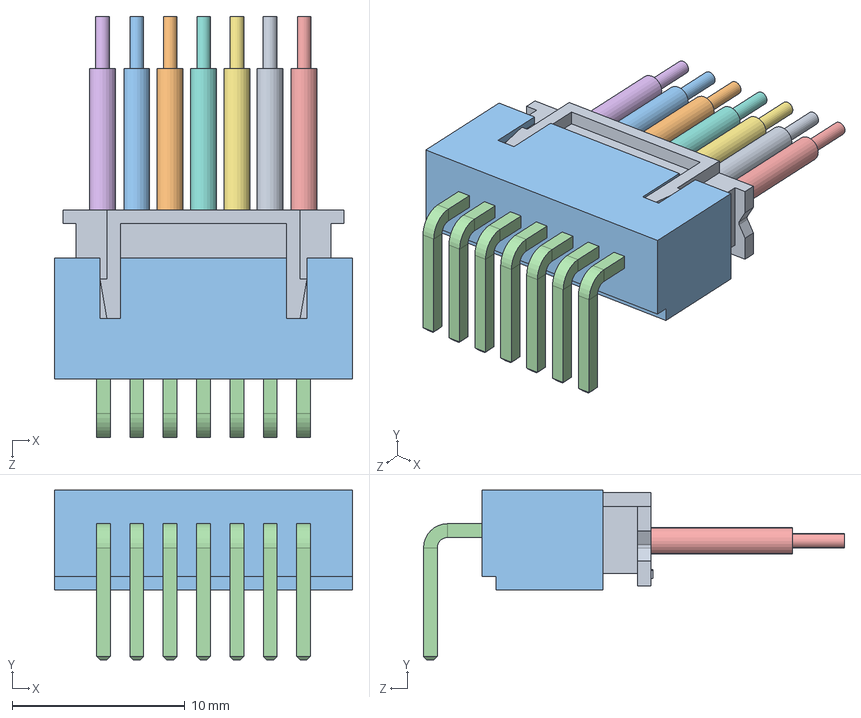
[picture p76: CAD file, 2021-11-09]
Actuator/Electronics/3D Models/JST_Pins/JST/7-Pin JST XH Female/Assem1.SLDASM
17.3 x 9.85 x 24.4 mm
JST - XH MALE 7pin
