gabriel-bettanin/LAIKA/References/CAD/Motors and Actuators/Cheetah_thesis/cam5.SLDASM

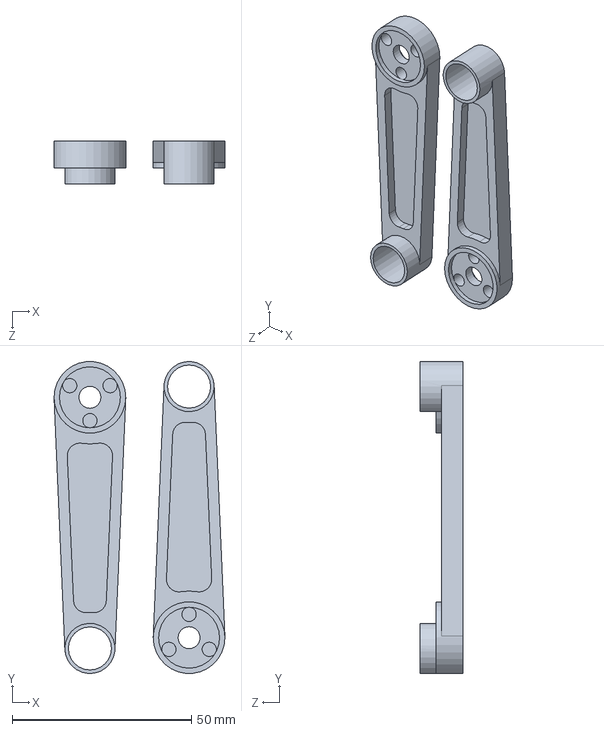
[picture p77: CAD file, 2021-11-09]
References/CAD/Motors and Actuators/Cheetah_thesis/cam5.SLDASM
47.6 x 87.0 x 12.0 mm
Link 1 x 2
