gabriel-bettanin/LAIKA/References/CAD/Motors and Actuators/hackaday.SLDASM

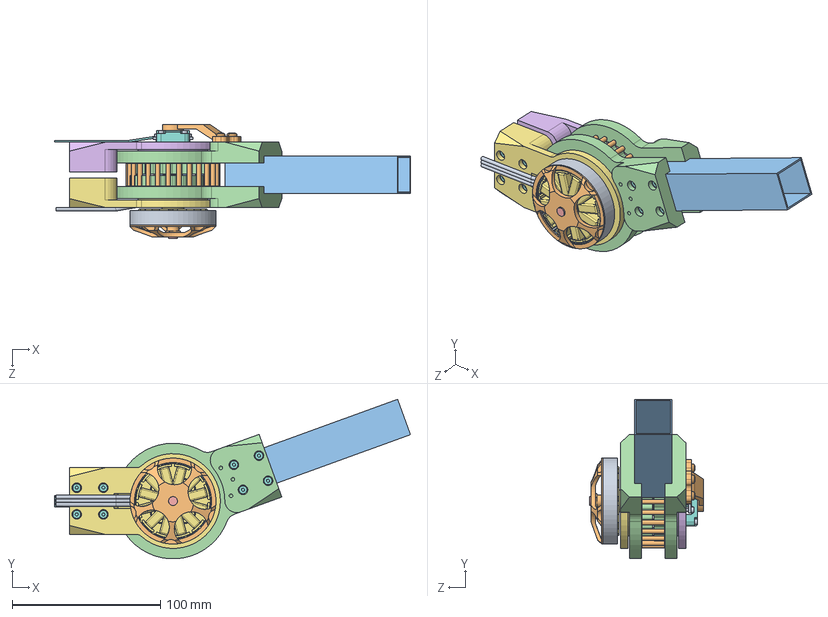
[picture p78: CAD file, 2021-11-09]
References/CAD/Motors and Actuators/hackaday.SLDASM
240.3 x 107.6 x 77.0 mm
motor 5008 flux.stp
motor 5008 top.stp
magnet 5008.stp x 14
6809_joint_out.stp x 2
58x45x7_bearing.stp x 2
encoder in 6809.stp
motor in 6809.stp
outer_bearing_holder.stp
enc_pcb.stp x 2
magnet_holder.stp
inner_ring_25l.stp x 2
shaft_6mm.stp
encoder_bearing_holder-45.stp
motor 5008 stator.stp
sensor_cable.stp
motor cable.stp
outer_pins.stp x 26
inner_pins.stp x 8
12x6x4 bearing.stp x 3
18x12x4 bearing.stp x 5
8x5x2_5 bearing.stp x 16
offset 6id 12od.stp
ANSI B18.3.5M - M3x6(1).stp x 16
ANSI B18.3.1M - M2x0.4 x 10.stp x 8
ANSI B18.6.7M - M3x0.5 x 4.stp x 3
6mm diametric.stp x 2
motor_bearing_holder.stp
silicon_steel.stp
