gabriel-bettanin/LAIKA/Actuator/Mechanics/Cycloidal Drive/Bearings/MR84ZZ.sldasm

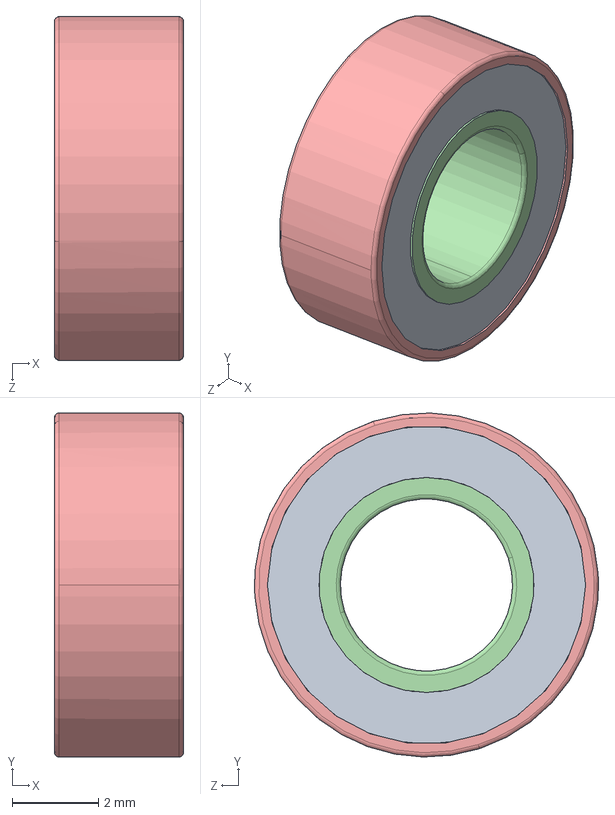
[picture p79: CAD file, 2021-11-09]
Actuator/Mechanics/Cycloidal Drive/Bearings/MR84ZZ.sldasm
3.00 x 8.00 x 8.00 mm
MR84ZZ_3
MR84ZZ_18
MR84ZZ_20
MR84ZZ_22
