gabriel-bettanin/LAIKA/Actuator/Mechanics/Test Stands/Encoder Stand.SLDASM

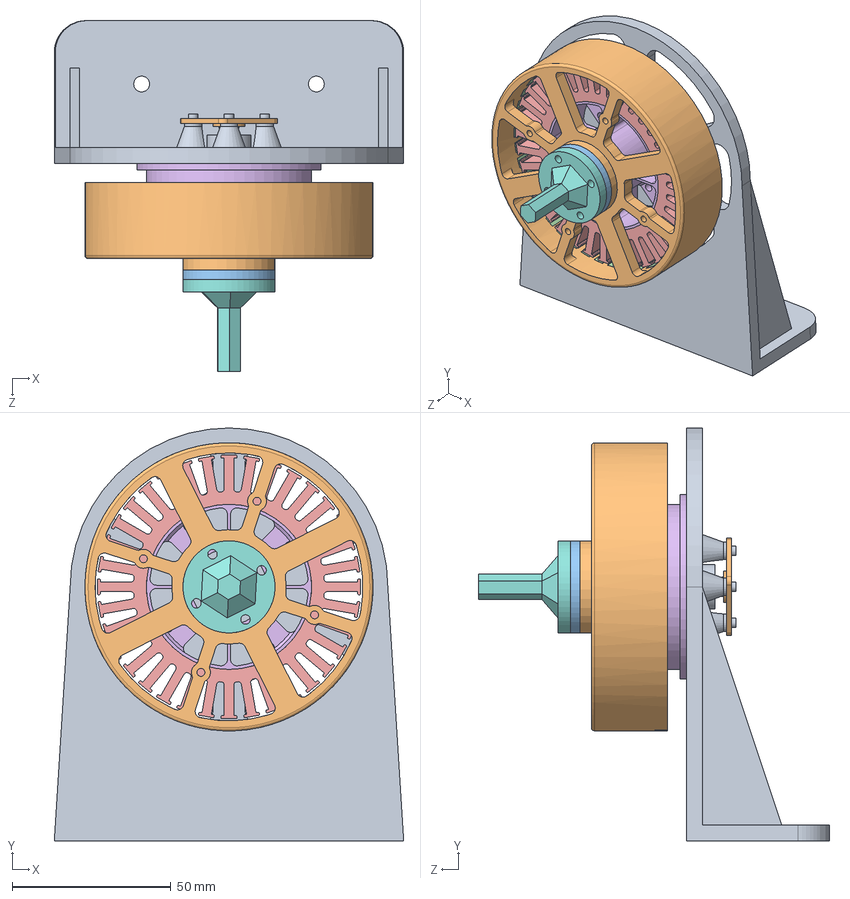
[picture p80: CAD file, 2021-11-09]
Actuator/Mechanics/Test Stands/Encoder Stand.SLDASM
110.0 x 130.0 x 110.5 mm
Encoder Support
Rotor
Shaft
Magnets
Stator
Middle
Crank
Magnet Holder
Encoder
Magnet
