gabriel-bettanin/LAIKA/References/CAD/Motors and Actuators/Cheetah_thesis/Motor.SLDASM

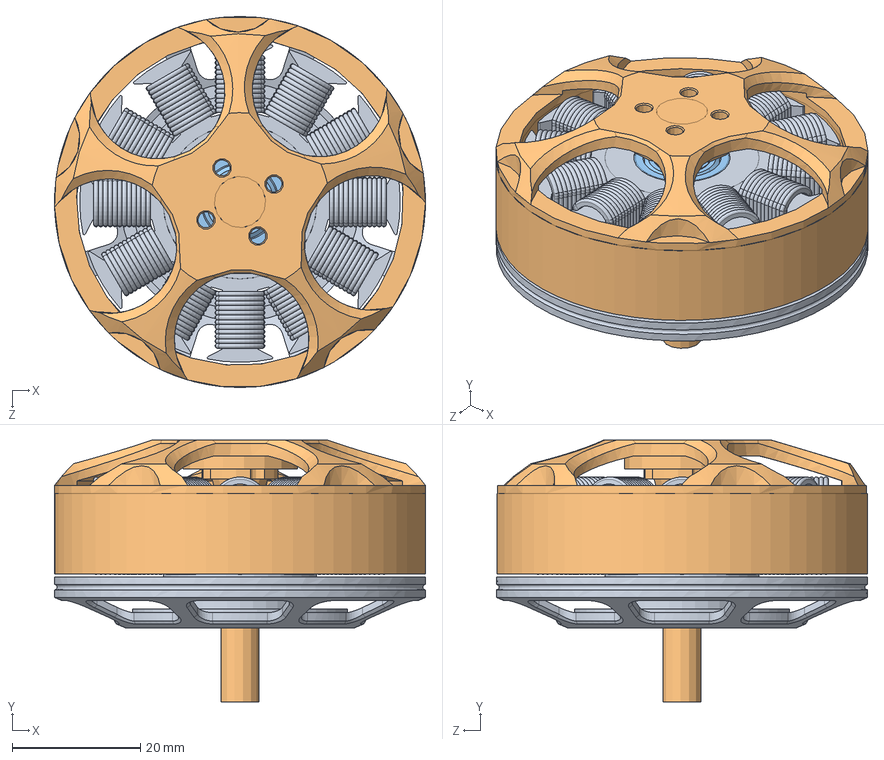
[picture p81: CAD file, 2021-11-09]
References/CAD/Motors and Actuators/Cheetah_thesis/Motor.SLDASM
57.9 x 40.9 x 57.9 mm
Stator
Rotor
Motor Bearing x 2
