gabriel-bettanin/LAIKA/Actuator/Mechanics/Cycloidal Drive/Cycloidal Drive v1.4.SLDASM

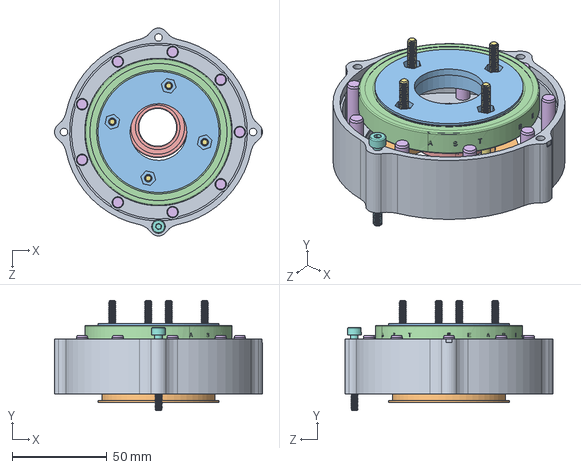
[picture p82: CAD file, 2021-11-09]
Actuator/Mechanics/Cycloidal Drive/Cycloidal Drive v1.4.SLDASM
110.0 x 58.3 x 110.0 mm
Dowel Pin x 9
M4_50 x 4
