gabriel-bettanin/LAIKA/Actuator/Mechanics/Cycloidal Drive/Eccentric Shaft Complete.3mf

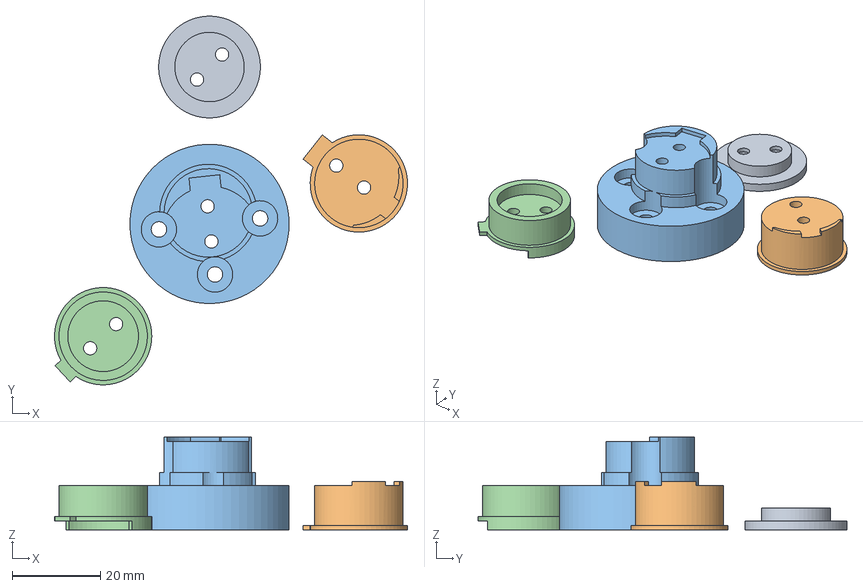
[picture p83: CAD file, 2021-11-09]
Actuator/Mechanics/Cycloidal Drive/Eccentric Shaft Complete.3mf
79.8 x 83.3 x 21.0 mm
Eccentric Shaft Cap.STL
Eccentric Shaft Middle.STL
Eccentric Shaft Top v1.2.STL
