gabriel-bettanin/LAIKA/Actuator/Mechanics/Test Stands/Driver Stand.SLDASM

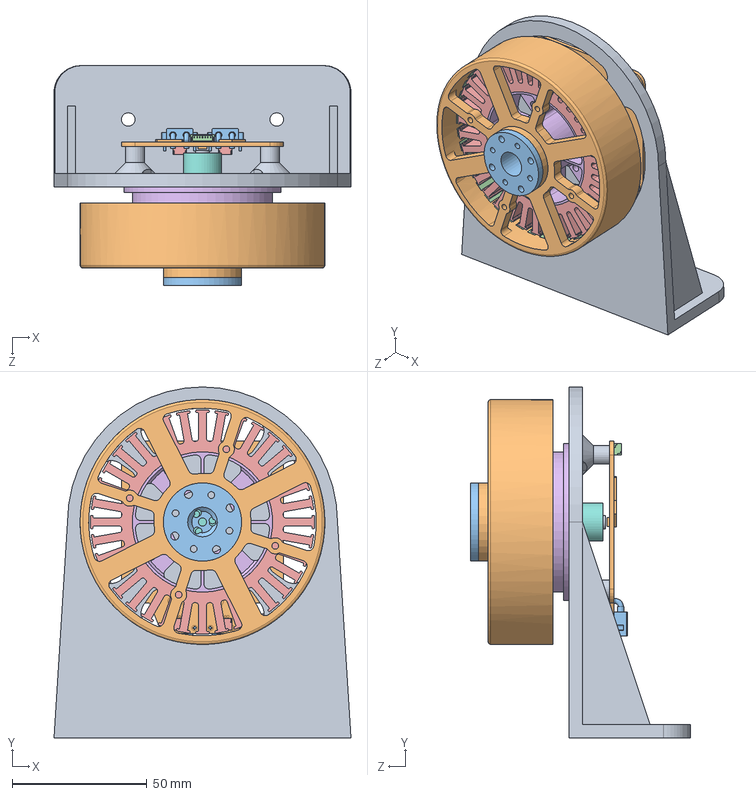
[picture p84: CAD file, 2021-11-09]
Actuator/Mechanics/Test Stands/Driver Stand.SLDASM
110.0 x 130.0 x 81.5 mm
Driver Support
Rotor
Shaft
Magnets
Stator
Middle
Magnet Holder
Magnet
LAIKA_Driver_Board
XT30 x 2
JST 7
JST 3 x 2
