gabriel-bettanin/LAIKA/References/CAD/Motors and Actuators/Cheetah_thesis/cam3.SLDASM

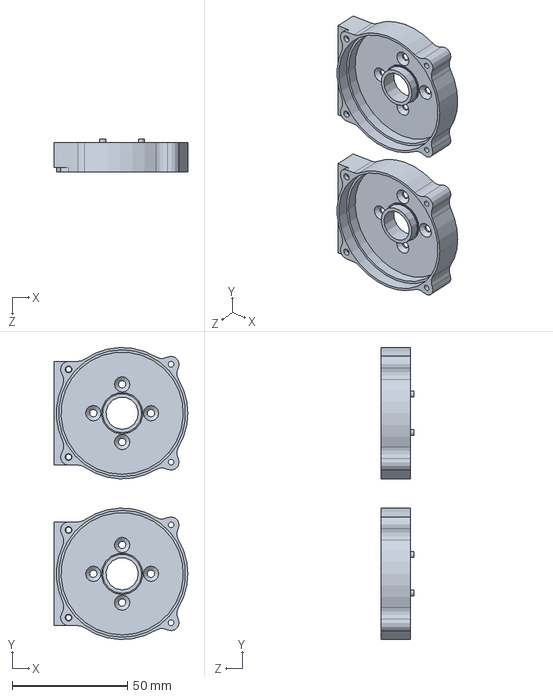
[picture p85: CAD file, 2021-11-09]
References/CAD/Motors and Actuators/Cheetah_thesis/cam3.SLDASM
58.0 x 126.6 x 14.2 mm
Back Housing x 2
