gabriel-bettanin/LAIKA/References/CAD/Motors and Actuators/Cheetah_thesis/Gearbox Assembly.SLDASM

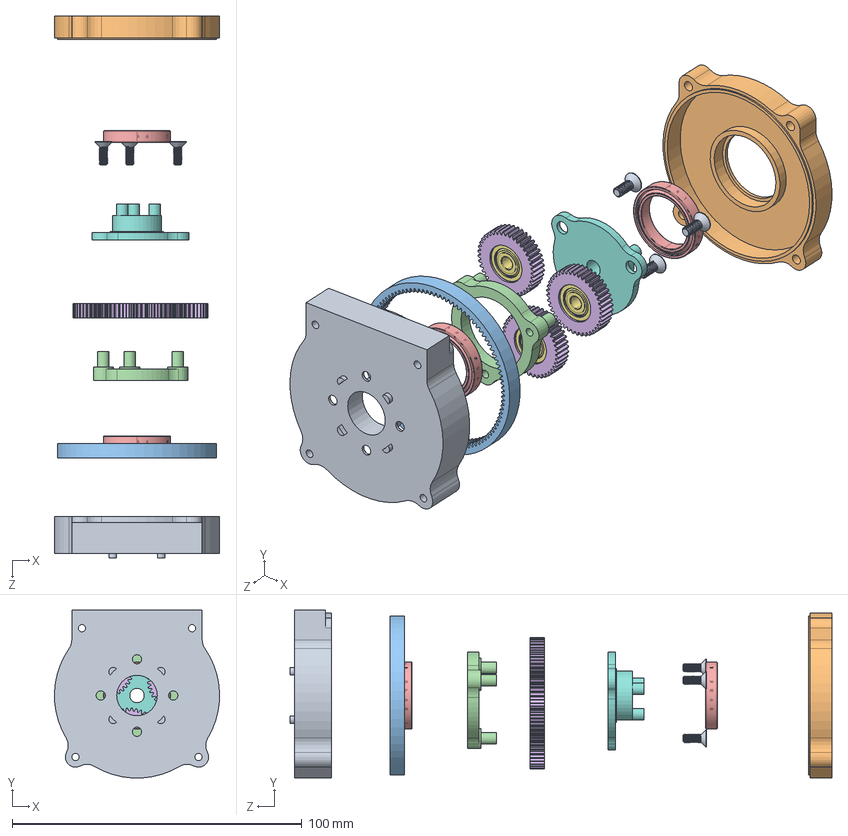
[picture p86: CAD file, 2021-11-09]
References/CAD/Motors and Actuators/Cheetah_thesis/Gearbox Assembly.SLDASM
57.0 x 57.9 x 187.0 mm
Back Housing
Front Housing
Ring
Planet Carrier Back
Carrier Bearing x 2
Planet x 3
Planet Bearing x 3
Planet Carrier Front
Flat_Socket_M3x8 x 3
