gabriel-bettanin/LAIKA/References/CAD/Motors and Actuators/Cheetah_thesis/cam1.SLDASM

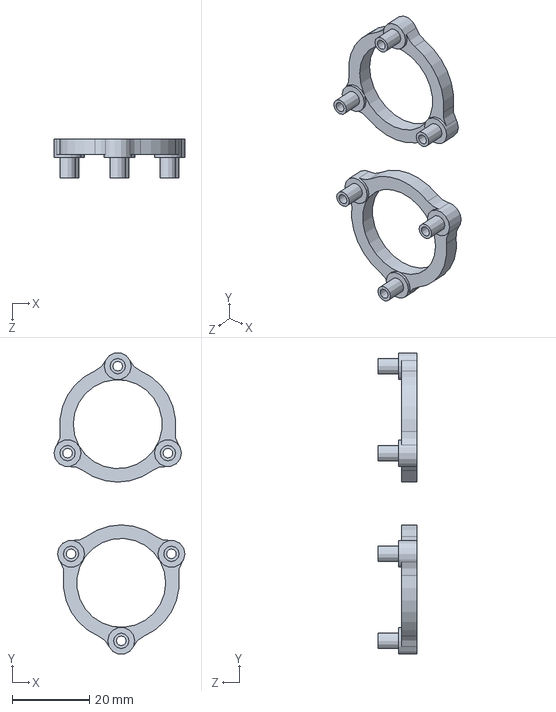
[picture p87: CAD file, 2021-11-09]
References/CAD/Motors and Actuators/Cheetah_thesis/cam1.SLDASM
33.9 x 77.9 x 10.0 mm
Planet Carrier Back x 2
