gabriel-bettanin/LAIKA/Actuator/Mechanics/Cycloidal Drive/Eccentric Shaft Assembly.SLDASM

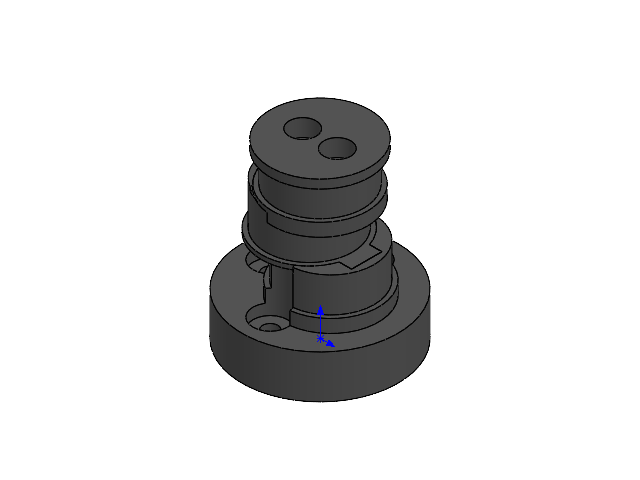
[picture p88: CAD file, 2021-11-09]
Actuator/Mechanics/Cycloidal Drive/Eccentric Shaft Assembly.SLDASM
Eccentric Shaft Bottom
Eccentric Shaft Middle
Eccentric Shaft Top
Eccentric Shaft Cap
