gabriel-bettanin/LAIKA/(list of files, cad)

Other CAD files:
References/CAD/Robots/MIT Mini Cheetah/Smart Engines.sldasm-Part-48.sldprt
References/CAD/Robots/MIT Mini Cheetah/Smart Engines.sldasm-Part-51.sldprt
References/CAD/Robots/MIT Mini Cheetah/Smart Engines.sldasm-Part-10.sldprt
References/CAD/Robots/MIT Mini Cheetah/Smart Engines.sldasm-Part-109.sldprt
References/CAD/Robots/MIT Mini Cheetah/Smart Engines.sldasm-Part-56.sldprt
References/CAD/Robots/MIT Mini Cheetah/Smart Engines.sldasm-Part-99.sldprt
References/CAD/Robots/MIT Mini Cheetah/Smart Engines.sldasm-Part-83.sldprt
References/CAD/Robots/MIT Mini Cheetah/Smart Engines.sldasm-Part-60.sldprt
References/CAD/Robots/MIT Mini Cheetah/Smart Engines.sldasm-Part-121.sldprt
References/CAD/Robots/MIT Mini Cheetah/Smart Engines.sldasm-Part-111.sldprt
References/CAD/Robots/MIT Mini Cheetah/Smart Engines.sldasm-Part-30.sldprt
References/CAD/Robots/MIT Mini Cheetah/Smart Engines.sldasm-Part-115.sldprt
References/CAD/Robots/MIT Mini Cheetah/Smart Engines.sldasm-Part-22.sldprt
References/CAD/Robots/MIT Mini Cheetah/Smart Engines.sldasm-Part-8.sldprt
References/CAD/Robots/MIT Mini Cheetah/Smart Engines.sldasm-Part-103.sldprt
References/CAD/Robots/MIT Mini Cheetah/Smart Engines.sldasm-Part-123.sldprt
References/CAD/Robots/MIT Mini Cheetah/Smart Engines.sldasm-Part-88.sldprt
References/CAD/Robots/MIT Mini Cheetah/Smart Engines.sldasm-Part-55.sldprt
References/CAD/Robots/MIT Mini Cheetah/Smart Engines.sldasm-Part-98.sldprt
References/CAD/Robots/MIT Mini Cheetah/Smart Engines.sldasm-Part-77.sldprt
References/CAD/Robots/MIT Mini Cheetah/Smart Engines.sldasm-Part-93.sldprt
References/CAD/Robots/MIT Mini Cheetah/Smart Engines.sldasm-Part-119.sldprt
References/CAD/Robots/MIT Mini Cheetah/Smart Engines.sldasm-Part-16.sldprt
References/CAD/Robots/MIT Mini Cheetah/Smart Engines.sldasm-Part-34.sldprt
References/CAD/Robots/MIT Mini Cheetah/Smart Engines.sldasm-Part-53.sldprt
References/CAD/Robots/MIT Mini Cheetah/Smart Engines.sldasm-Part-84.sldprt
References/CAD/Robots/MIT Mini Cheetah/Smart Engines.sldasm-Part-28.sldprt
References/CAD/Robots/MIT Mini Cheetah/Smart Engines.sldasm-Part-69.sldprt
References/CAD/Robots/MIT Mini Cheetah/Smart Engines.sldasm-Part-54.sldprt
References/CAD/Robots/MIT Mini Cheetah/Smart Engines.sldasm-Part-19.sldprt
References/CAD/Robots/MIT Mini Cheetah/Smart Engines.sldasm-Part-66.sldprt
References/CAD/Robots/MIT Mini Cheetah/Smart Engines.sldasm-Part-14.sldprt
References/CAD/Robots/MIT Mini Cheetah/Smart Engines.sldasm-Part-94.sldprt
References/CAD/Robots/MIT Mini Cheetah/Smart Engines.sldasm-Part-120.sldprt
References/CAD/Robots/MIT Mini Cheetah/Smart Engines.sldasm-Part-64.sldprt
References/CAD/Robots/MIT Mini Cheetah/Smart Engines.sldasm-Part-73.sldprt
References/CAD/Robots/MIT Mini Cheetah/Smart Engines.sldasm-Part-49.sldprt
References/CAD/Robots/MIT Mini Cheetah/Smart Engines.sldasm-Part-95.sldprt
References/CAD/Robots/MIT Mini Cheetah/Smart Engines.sldasm-Part-29.sldprt
References/CAD/Robots/MIT Mini Cheetah/Smart Engines.sldasm-Part-100.sldprt
References/CAD/Robots/MIT Mini Cheetah/Smart Engines.sldasm-Part-89.sldprt
References/CAD/Robots/MIT Mini Cheetah/Smart Engines.sldasm-Part-101.sldprt
References/CAD/Robots/MIT Mini Cheetah/Smart Engines.sldasm-Part-110.sldprt
References/CAD/Robots/MIT Mini Cheetah/Smart Engines.sldasm-Part-108.sldprt
References/CAD/Robots/MIT Mini Cheetah/Smart Engines.sldasm-Part-85.sldprt
References/CAD/Robots/MIT Mini Cheetah/Smart Engines.sldasm-Part-9.sldprt
References/CAD/Robots/MIT Mini Cheetah/Smart Engines.sldasm-Part-37.sldprt
References/CAD/Robots/MIT Mini Cheetah/Smart Engines.sldasm-Part-24.sldprt
References/CAD/Robots/MIT Mini Cheetah/Smart Engines.sldasm-Part-21.sldprt
References/CAD/Robots/MIT Mini Cheetah/Smart Engines.sldasm-Part-67.sldprt
References/CAD/Robots/MIT Mini Cheetah/Smart Engines.sldasm-Part-39.sldprt
References/CAD/Robots/MIT Mini Cheetah/Smart Engines.sldasm-Part-43.sldprt
References/CAD/Robots/MIT Mini Cheetah/Smart Engines.sldasm-Part-122.sldprt
References/CAD/Robots/MIT Mini Cheetah/Smart Engines.sldasm-Part-15.sldprt
References/CAD/Robots/MIT Mini Cheetah/Smart Engines.sldasm-Part-117.sldprt
References/CAD/Robots/MIT Mini Cheetah/Smart Engines.sldasm-Part-5.sldprt
References/CAD/Robots/MIT Mini Cheetah/Smart Engines.sldasm-Part-97.sldprt
References/CAD/Robots/MIT Mini Cheetah/Smart Engines.sldasm-Part-6.sldprt
References/CAD/Robots/MIT Mini Cheetah/Smart Engines.sldasm-Part-81.sldprt
References/CAD/Robots/MIT Mini Cheetah/Smart Engines.sldasm-Part-65.sldprt
References/CAD/Robots/MIT Mini Cheetah/Smart Engines.sldasm-Part-87.sldprt
References/CAD/Robots/MIT Mini Cheetah/Smart Engines.sldasm-Part-70.sldprt
References/CAD/Robots/MIT Mini Cheetah/Smart Engines.sldasm-Part-45.sldprt
References/CAD/Robots/MIT Mini Cheetah/Smart Engines.sldasm-Part-35.sldprt
References/CAD/Robots/MIT Mini Cheetah/Smart Engines.sldasm-Part-106.sldprt
References/CAD/Robots/MIT Mini Cheetah/Smart Engines.sldasm-Part-116.sldprt
References/CAD/Robots/MIT Mini Cheetah/Smart Engines.sldasm-Part-63.sldprt
References/CAD/Robots/MIT Mini Cheetah/Smart Engines.sldasm-Part-104.sldprt
References/CAD/Robots/MIT Mini Cheetah/Smart Engines.sldasm-Part-7.sldprt
References/CAD/Robots/MIT Mini Cheetah/Smart Engines.sldasm-Part-26.sldprt
References/CAD/Robots/MIT Mini Cheetah/Smart Engines.sldasm-Part-38.sldprt
References/CAD/Robots/MIT Mini Cheetah/Smart Engines.sldasm-Part-113.sldprt
References/CAD/Robots/MIT Mini Cheetah/Smart Engines.sldasm-Part-74.sldprt
References/CAD/Robots/MIT Mini Cheetah/Smart Engines.sldasm-Part-118.sldprt
References/CAD/Robots/MIT Mini Cheetah/Smart Engines.sldasm-Part-46.sldprt
References/CAD/Robots/MIT Mini Cheetah/Smart Engines.sldasm-Part-91.sldprt
References/CAD/Robots/MIT Mini Cheetah/Smart Engines.sldasm-Part-102.sldprt
References/CAD/Robots/MIT Mini Cheetah/Smart Engines.sldasm-Part-31.sldprt
References/CAD/Robots/MIT Mini Cheetah/Smart Engines.sldasm-Part-4.sldprt
References/CAD/Robots/MIT Mini Cheetah/Smart Engines.sldasm-Part-58.sldprt
References/CAD/Robots/MIT Mini Cheetah/Smart Engines.sldasm-Part-2.sldprt
References/CAD/Robots/MIT Mini Cheetah/Smart Engines.sldasm-Part-1.sldprt
References/CAD/Robots/MIT Mini Cheetah/Smart Engines.sldasm-Part-61.sldprt
References/CAD/Robots/MIT Mini Cheetah/Smart Engines.sldasm-Part-40.sldprt
References/CAD/Robots/MIT Mini Cheetah/Smart Engines.sldasm-Part-59.sldprt
References/CAD/Robots/MIT Mini Cheetah/Smart Engines.sldasm-Part-32.sldprt
References/CAD/Robots/MIT Mini Cheetah/Smart Engines.sldasm-Part-50.sldprt
References/CAD/Robots/MIT Mini Cheetah/Smart Engines.sldasm-Part-47.sldprt
References/CAD/Robots/MIT Mini Cheetah/Smart Engines.sldasm-Part-107.sldprt
References/CAD/Robots/MIT Mini Cheetah/Smart Engines.sldasm-Part-76.sldprt
References/CAD/Robots/MIT Mini Cheetah/Smart Engines.sldasm-Part-36.sldprt
References/CAD/Robots/MIT Mini Cheetah/Smart Engines.sldasm-Part-17.sldprt
References/CAD/Robots/MIT Mini Cheetah/Smart Engines.sldasm-Part-27.sldprt
References/CAD/Robots/MIT Mini Cheetah/Smart Engines.sldasm-Part-18.sldprt
References/CAD/Robots/MIT Mini Cheetah/Smart Engines.sldasm-Part-80.sldprt
References/CAD/Robots/MIT Mini Cheetah/Smart Engines.sldasm-Part-23.sldprt
References/CAD/Robots/MIT Mini Cheetah/Smart Engines.sldasm-Part-68.sldprt
References/CAD/Robots/MIT Mini Cheetah/Smart Engines.sldasm-Part-75.sldprt
References/CAD/Robots/MIT Mini Cheetah/Smart Engines.sldasm-Part-71.sldprt
References/CAD/Robots/MIT Mini Cheetah/Smart Engines.sldasm-Part-42.sldprt
References/CAD/Robots/MIT Mini Cheetah/Smart Engines.sldasm-Part-33.sldprt
References/CAD/Robots/MIT Mini Cheetah/Smart Engines.sldasm-Part-72.sldprt
References/CAD/Robots/MIT Mini Cheetah/Smart Engines.sldasm-Part-41.sldprt
References/CAD/Robots/MIT Mini Cheetah/Smart Engines.sldasm-Part-25.sldprt
References/CAD/Robots/MIT Mini Cheetah/Smart Engines.sldasm-Part-20.sldprt
References/CAD/Robots/MIT Mini Cheetah/Smart Engines.sldasm-Part-78.sldprt
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
