gabriel-bettanin/LAIKA/Docs/Fotos/3D Printed Quadruped Leg.png

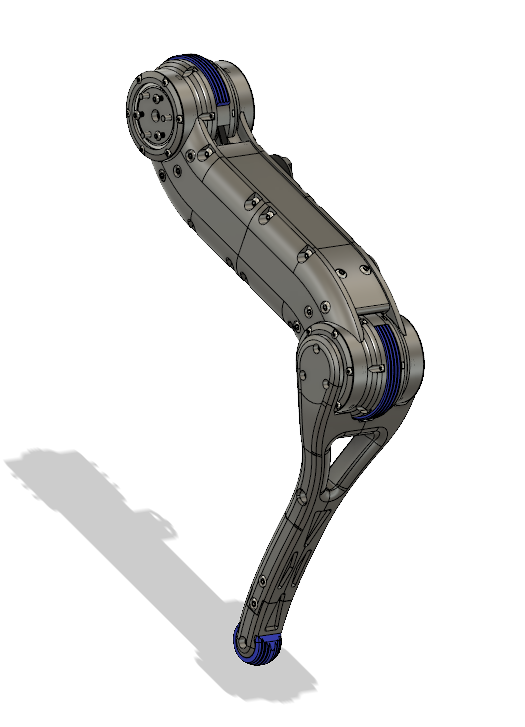
Docs/Fotos/3D Printed Quadruped Leg.png
