gabriel-bettanin/LAIKA/Actuator/Electronics/Gerbers/pcb-test-pattern-master/Negative-Artwork.pdf

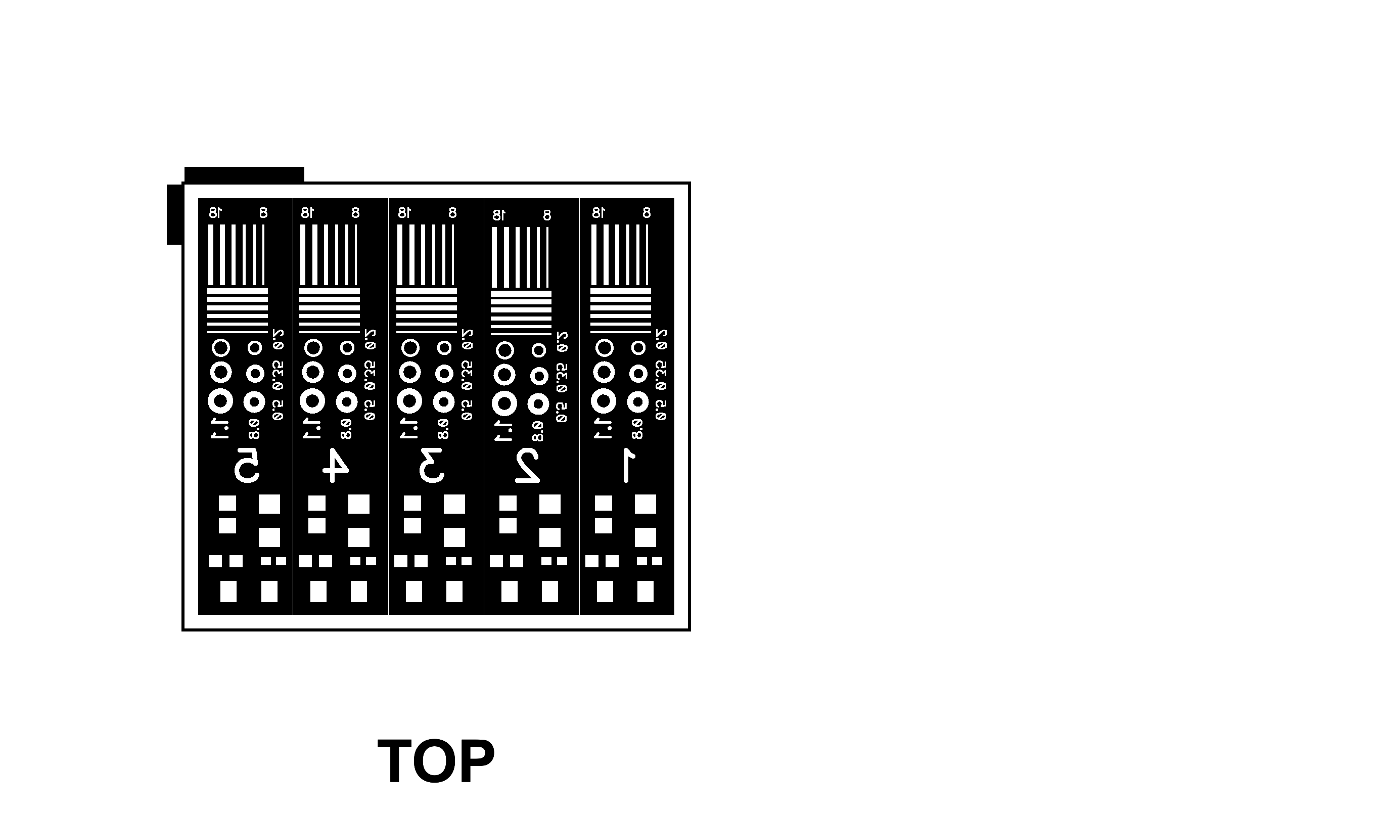
[picture p90: page 1]
