gabriel-bettanin/LAIKA/Actuator/Electronics/Gerbers/pcb-test-pattern-master/Positive-Artwork.pdf

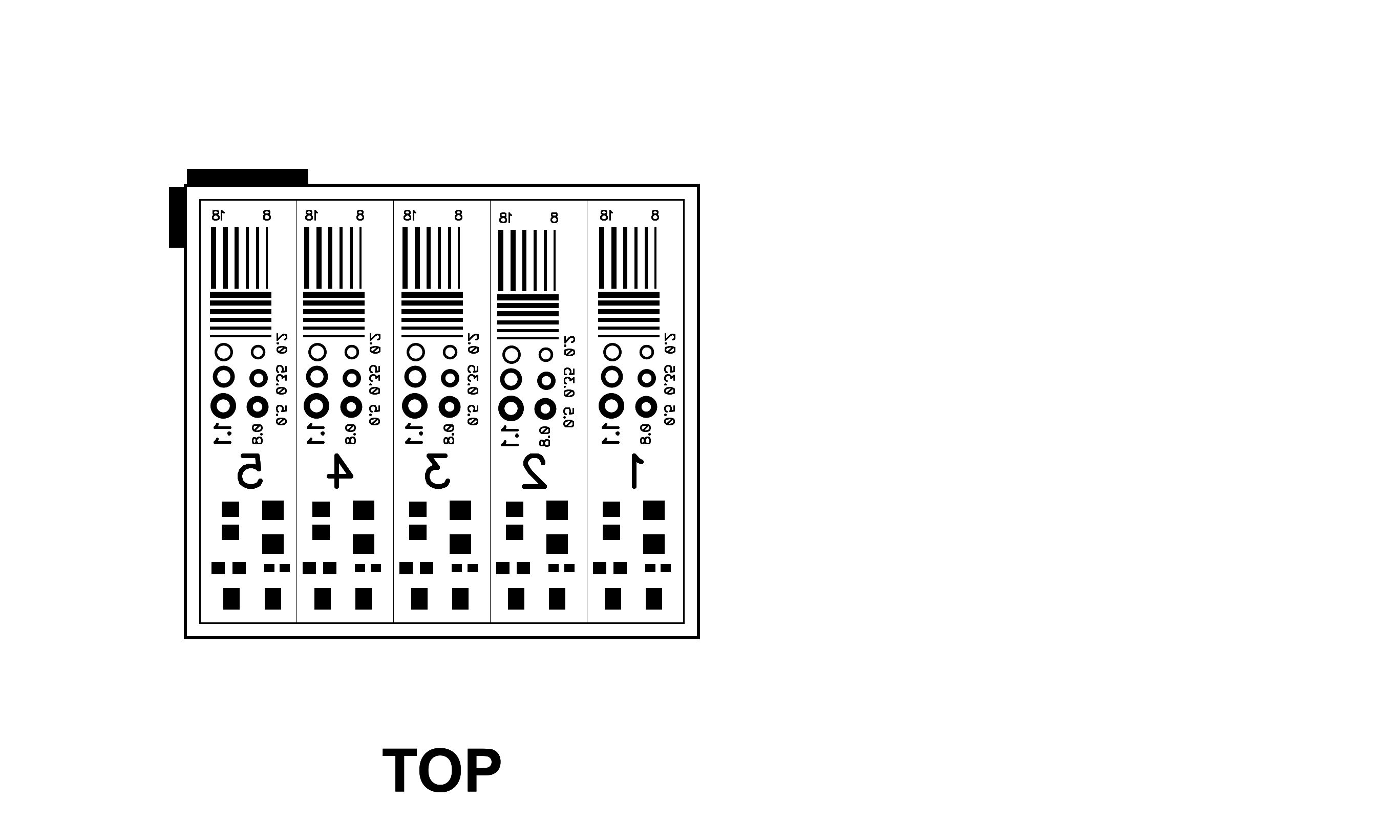
[picture p91: page 1]
