gabriel-bettanin/LAIKA/Actuator/Electronics/Gerbers/Driver_bottom_layer.pdf

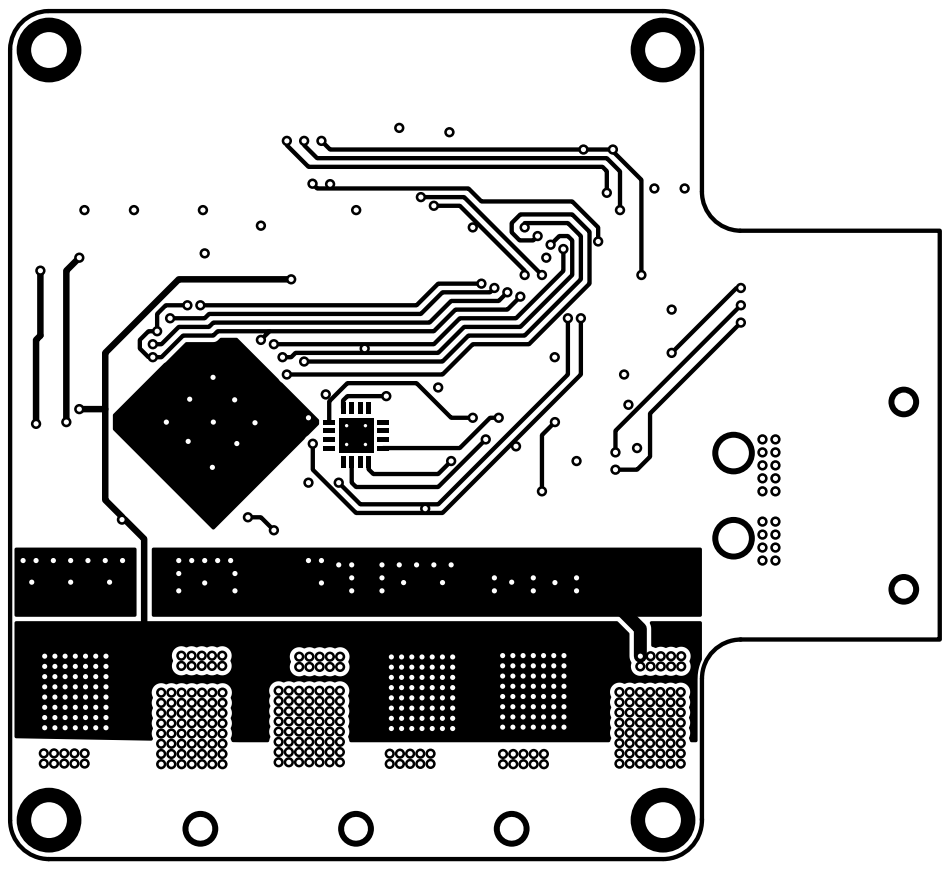
[picture p92: page 1]
