gabriel-bettanin/LAIKA/Actuator/Electronics/Gerbers/Driver_top_layer.pdf

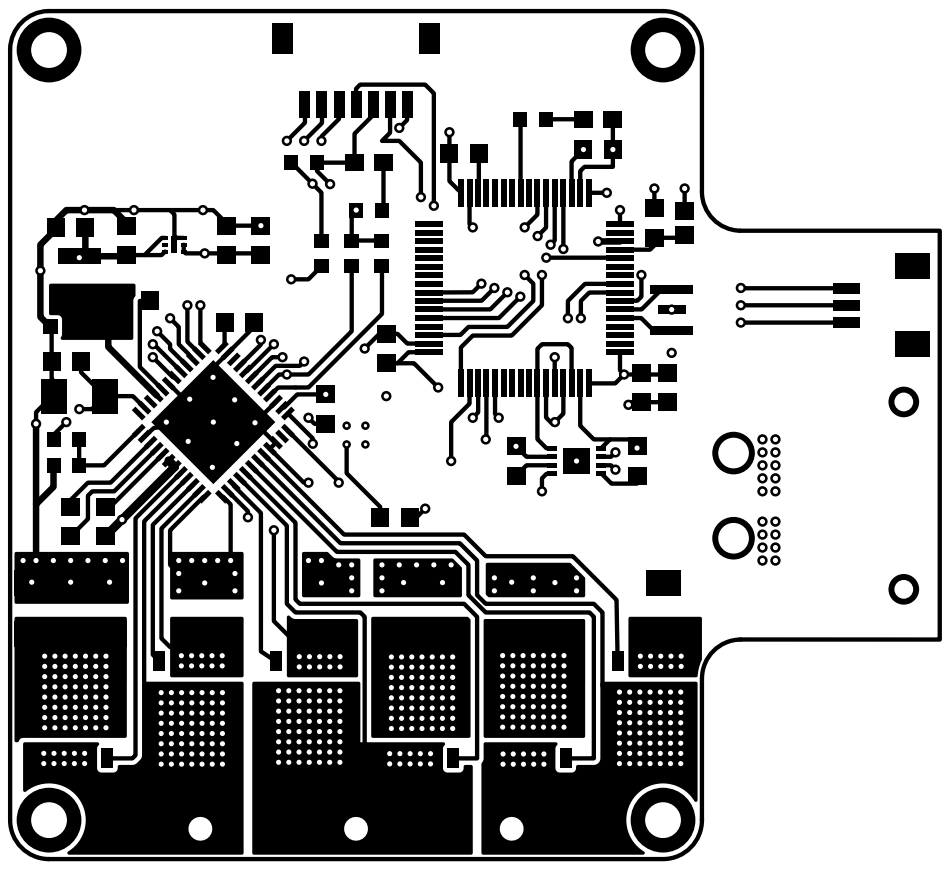
[picture p93: page 1]
