gabriel-bettanin/LAIKA/Actuator/Electronics/Gerbers/Test_layout.pdf

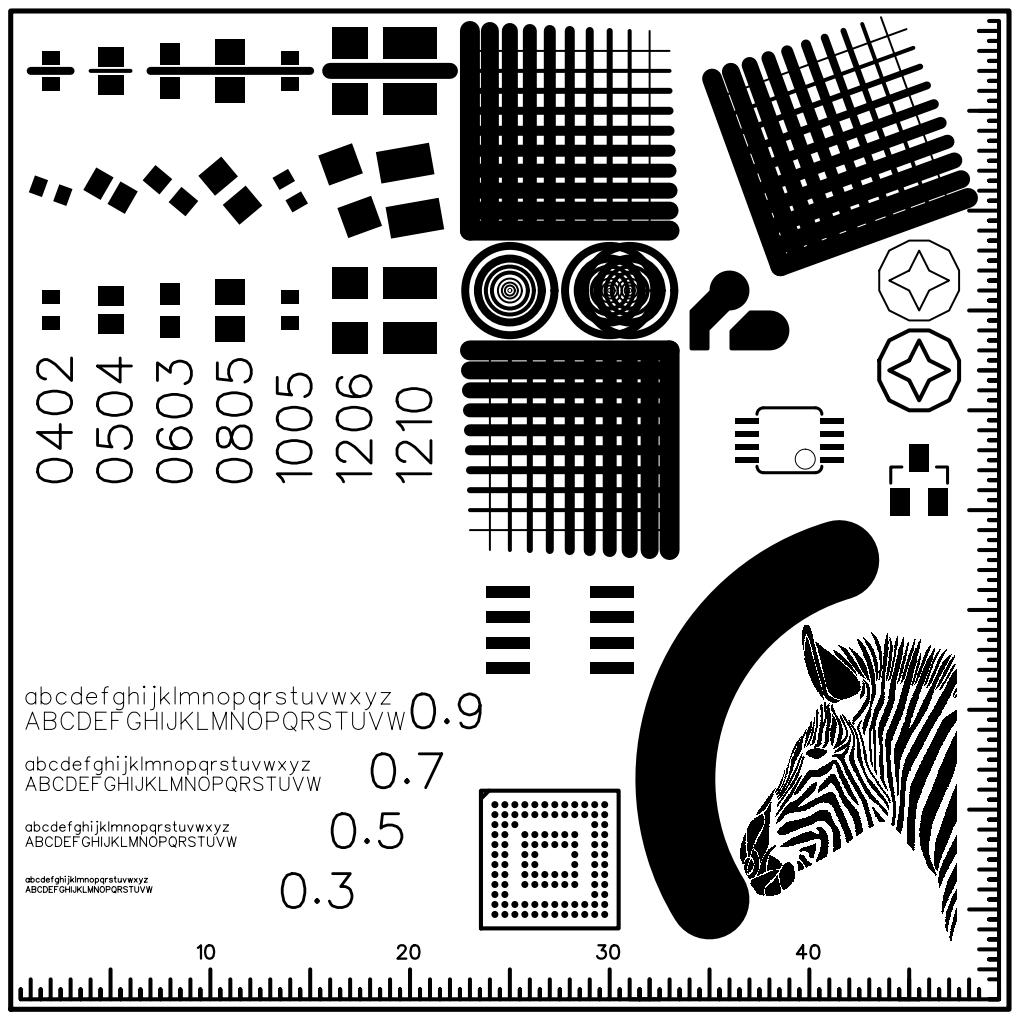
[picture p94: page 1]
