gabriel-bettanin/LAIKA/(list of files, drawings)

Other design files:
Actuator/Electronics/Altium/EasyEDA Import/Driver PCB v1.0.PcbDoc
Actuator/Electronics/Altium/EasyEDA Import/Driver Schematic v1.0.schdoc
Actuator/Electronics/Altium/EasyEDA Import/Driver Schematic v1.1.schdoc
Actuator/Electronics/Altium/LAIKA Driver.SchDoc
Actuator/Electronics/Altium/LAIKA Driver.SCHLIB
References/Controllers/SimpleFOC/ArduinoFOC.PcbDoc
References/Controllers/SimpleFOC/ArduinoFOC.PcbLib
References/Controllers/SimpleFOC/ArduinoFOC.PrjPCB
References/Controllers/SimpleFOC/ArduinoFOC.SchDoc
References/Controllers/SimpleFOC/ArduinoFOC.SchLib
