gabriel-bettanin/LAIKA/Actuator/Electronics/Eagle/Driver.brd

## EAGLE design Actuator/Electronics/Eagle/Driver.brd (2021-11-09)

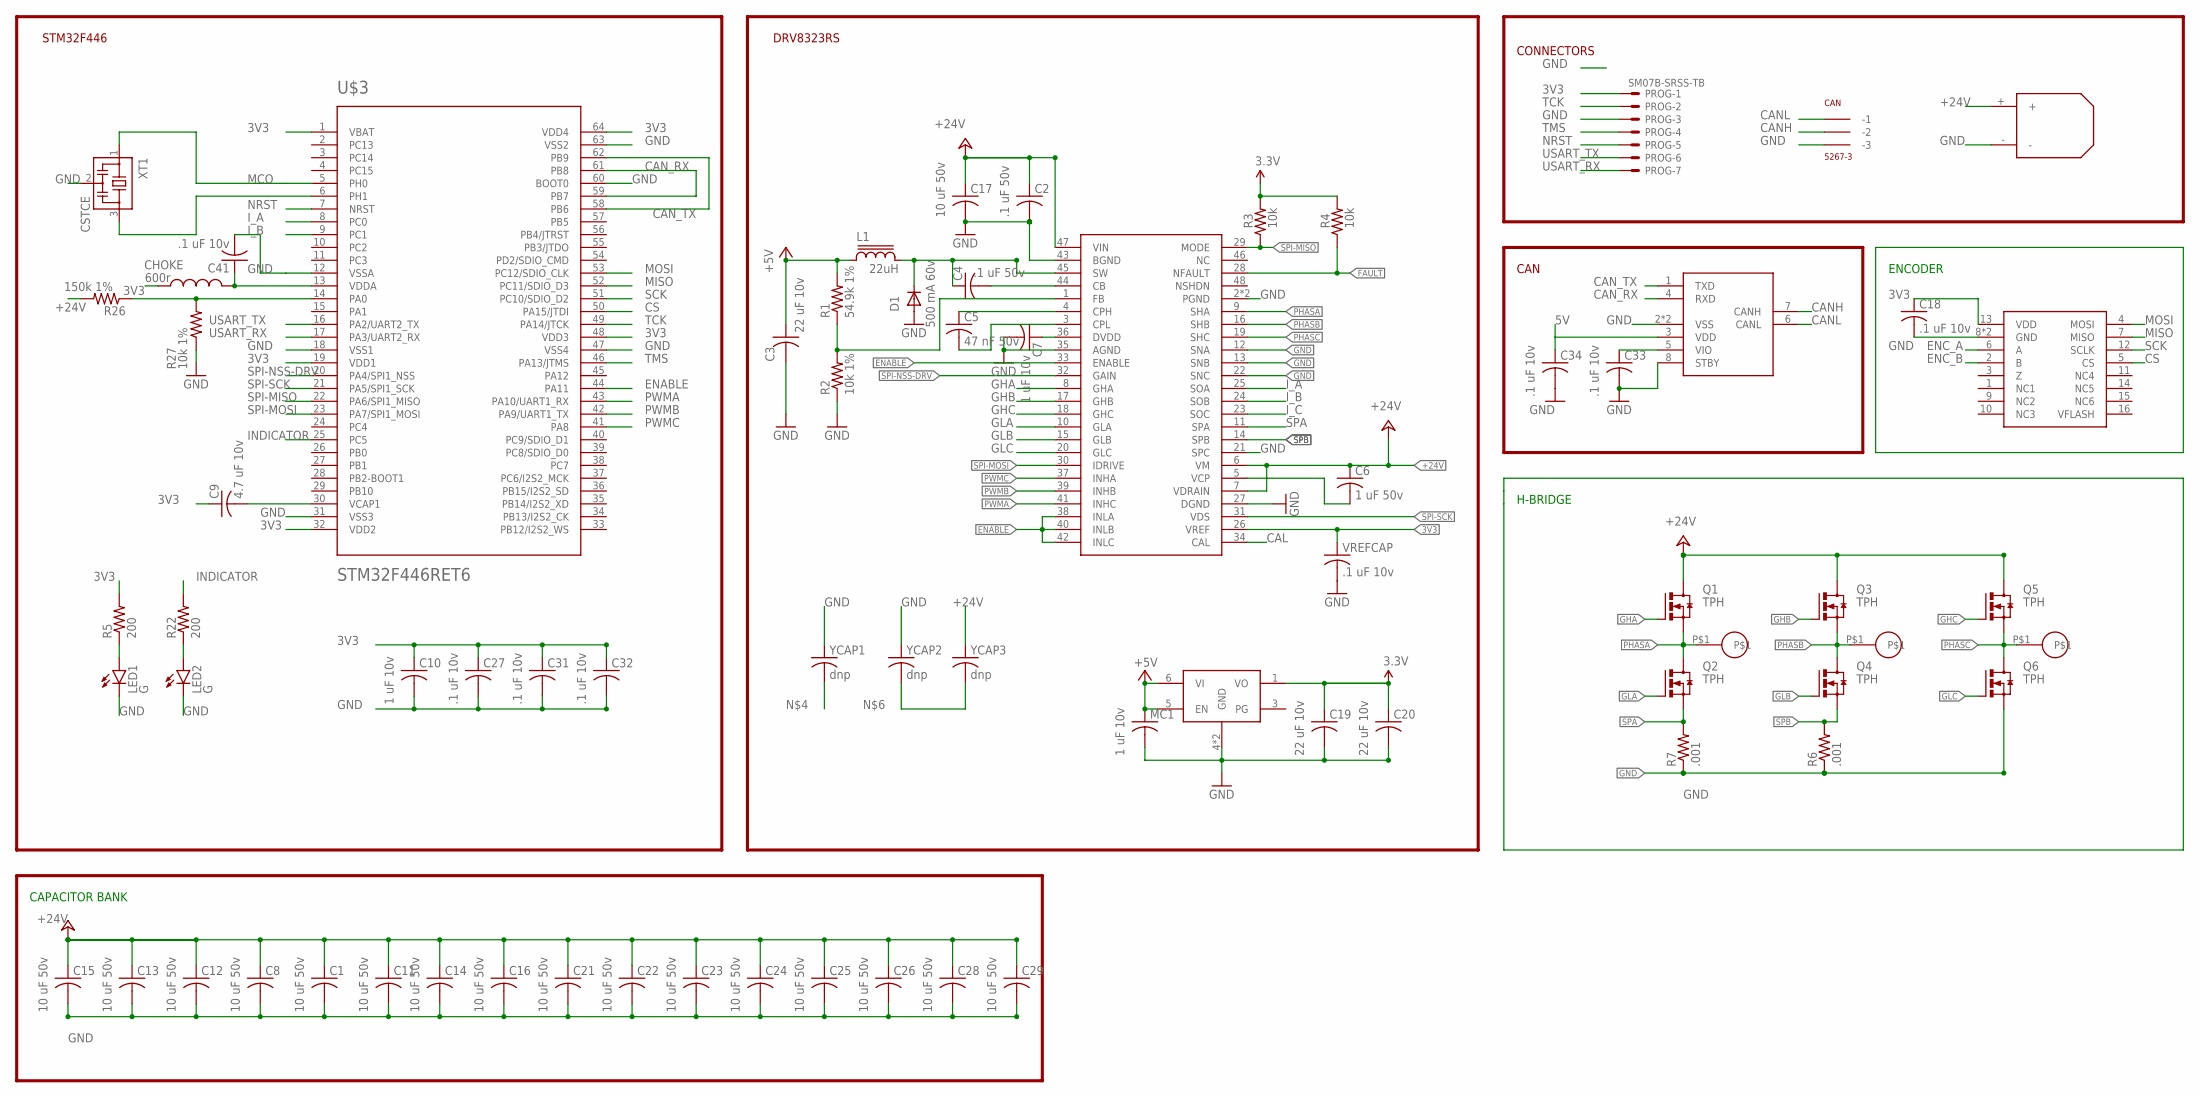
[picture p95: schematic Driver.sch]

Parts:
C1, C8, C11, C12, C13, C14, C15, C16, C17, C21, C22, C23, C24, C25, C26, C28, C29: 10 uF 50v; C1206K
C2, C4: .1 uF 50v; C0603K
C3, C19, C20: 22 uF 10v; C0603K
C5: 47 nF 50v; C0402K
C6: 1 uF 50v; C0603K
C7, C10: 1 uF 10v; C0402K
C9: 4.7 uF 10v; C0402K
C18, C27, C31, C32, C33, C34, C41: .1 uF 10v; C0402K
CAN: 5267-3
CHOKE: 600r; 0603
D1: 500 mA 60v; SOD123
L1: 22uH; SDR0302
LDFM33PUR: LDFM; DFN6-3X3
LED1, LED2: G; LED-0603
MC1: 1 uF 10v; C0402K
PROG: SM07B-SRSS-TB
Q1, Q2, Q3, Q4, Q5, Q6: TPH; TRANS_TPH5900CNH,L1Q
R1: 54.9k 1%; R0402
R2, R27: 10k 1%; R0402
R3, R4: 10k; R0402
R5, R22: 200; R0402
R6, R7: .001; R1210
R26: 150k 1%; R0402
U$1: DRV8323RH; QFN50P700X700X90-49N
U$2, U$4, U$5: 18_AWG_PAD
U$3: STM32F446RET6; TQFP64
U$6: MCP2542; TDFN
U$9: XT30; XT30_HORIZONTAL
U$11: MA700; QFN16
VREFCAP: .1 uF 10v; C0402K
XT1: CSTCE
YCAP1, YCAP2, YCAP3: dnp; C0402K

Connections:
3V3: C9.1, C10.1, C18.1, C19.1, C20.1, C27.1, C31.1, C32.1, C33.1, CHOKE.1, LDFM33PUR.1 (VO), PROG.1, R3.2, R4.2, R5.2, U$1.26 (VREF), U$3.1 (VBAT), U$3.19 (VDD1), U$3.32 (VDD2), U$3.48 (VDD3), U$3.64 (VDD4), U$6.5 (VIO), U$11.13 (VDD), VREFCAP.1
5V: C3.1, C34.1, L1.1, LDFM33PUR.5 (EN), LDFM33PUR.6 (VI), MC1.1, R1.2, U$6.3 (VDD)
+24V: C1.1, C2.1, C6.1, C8.1, C11.1, C12.1, C13.1, C14.1, C15.1, C16.1, C17.1, C21.1, C22.1, C23.1, C24.1, C25.1, C26.1, C28.1, C29.1, Q1.5 (D), Q1.6 (D), Q1.7 (D), Q1.8 (D), Q1.EP (D), Q3.5 (D), Q3.6 (D), Q3.7 (D), Q3.8 (D), Q3.EP (D), Q5.5 (D), Q5.6 (D), Q5.7 (D), Q5.8 (D), Q5.EP (D), R26.2, U$1.6 (VM), U$1.7 (VDRAIN), U$1.47 (VIN), U$9.+, YCAP3.1
BOOT: C4.2, U$1.44 (CB)
CAL: U$1.34 (CAL)
CANH: CAN.P$2 (-2), U$6.7 (CANH)
CANL: CAN.P$1 (-1), U$6.6 (CANL)
CAN_RX: U$3.59 (PB7), U$3.61 (PB8), U$6.4 (RXD)
CAN_TX: U$3.58 (PB6), U$3.62 (PB9), U$6.1 (TXD)
CPH: C5.1, U$1.4 (CPH)
CPL: C5.2, U$1.3 (CPL)
CS: U$3.50 (PA15/JTDI), U$11.5 (CS)
DEVICE3.3: C7.1, U$1.36 (DVDD)
ENABLE: U$1.33 (ENABLE), U$1.38 (INLA), U$1.40 (INLB), U$1.42 (INLC), U$3.44 (PA11)
ENC_A: U$11.6 (A)
ENC_B: U$11.2 (B)
FAULT: R4.1, U$1.28 (NFAULT)
FB: R1.1, R2.2, U$1.1 (FB)
GHA: Q1.4 (G), U$1.8 (GHA)
GHB: Q3.4 (G), U$1.17 (GHB)
GHC: Q5.4 (G), U$1.18 (GHC)
GLA: Q2.4 (G), U$1.10 (GLA)
GLB: Q4.4 (G), U$1.15 (GLB)
GLC: Q6.4 (G), U$1.20 (GLC)
GND: C1.2, C2.2, C3.2, C7.2, C8.2, C10.2, C11.2, C12.2, C13.2, C14.2, C15.2, C16.2, C17.2, C18.2, C19.2, C20.2, C21.2, C22.2, C23.2, C24.2, C25.2, C26.2, C27.2, C28.2, C29.2, C31.2, C32.2, C33.2, C34.2, C41.2, CAN.P$3 (-3), D1.A, LDFM33PUR.4 (GND), LDFM33PUR.EXP (GND), LED1.C, LED2.C, MC1.2, PROG.3, Q6.1 (S), Q6.2 (S), Q6.3 (S), R2.1, R6.1, R7.1, R27.1, U$1.2 (PGND), U$1.12 (SNA), U$1.13 (SNB), U$1.21 (SPC), U$1.22 (SNC), U$1.27 (DGND), U$1.35 (AGND), U$1.43 (BGND), U$1.49 (PGND), U$3.12 (VSSA), U$3.18 (VSS1), U$3.31 (VSS3), U$3.47 (VSS4), U$3.60 (BOOT0), U$3.63 (VSS2), U$6.2 (VSS), U$6.8 (STBY), U$6.9 (VSS), U$9.-, U$11.8 (GND), U$11.TH (GND), VREFCAP.2, XT1.2, YCAP1.1, YCAP2.1
INDICATOR: R22.2, U$3.25 (PC5)
I_A: U$1.25 (SOA), U$3.8 (PC0)
I_B: U$1.24 (SOB), U$3.9 (PC1)
I_C: U$1.23 (SOC)
MCO: U$3.5 (PH0), XT1.1
MISO: U$3.52 (PC11/SDIO_D3), U$11.7 (MISO)
MOSI: U$3.53 (PC12/SDIO_CLK), U$11.4 (MOSI)
unnamed: LED1.A, R5.1
unnamed: C41.1, CHOKE.2, U$3.13 (VDDA)
unnamed: C9.2, U$3.30 (VCAP1)
unnamed: YCAP2.2, YCAP3.2
unnamed: R26.1, R27.2, U$3.14 (PA0)
unnamed: LED2.A, R22.1
unnamed: U$3.6 (PH1), XT1.3
NRST: PROG.5, U$3.7 (NRST)
PHASA: Q1.1 (S), Q1.2 (S), Q1.3 (S), Q2.5 (D), Q2.6 (D), Q2.7 (D), Q2.8 (D), Q2.EP (D), U$1.9 (SHA), U$4.P$1
PHASB: Q3.1 (S), Q3.2 (S), Q3.3 (S), Q4.5 (D), Q4.6 (D), Q4.7 (D), Q4.8 (D), Q4.EP (D), U$1.16 (SHB), U$2.P$1
PHASC: Q5.1 (S), Q5.2 (S), Q5.3 (S), Q6.5 (D), Q6.6 (D), Q6.7 (D), Q6.8 (D), Q6.EP (D), U$1.19 (SHC), U$5.P$1
PWMA: U$1.41 (INHC), U$3.43 (PA10/UART1_RX)
PWMB: U$1.39 (INHB), U$3.42 (PA9/UART1_TX)
PWMC: U$1.37 (INHA), U$3.41 (PA8)
SCK: U$3.51 (PC10/SDIO_D2), U$11.12 (SCLK)
SPA: Q2.1 (S), Q2.2 (S), Q2.3 (S), R7.2, U$1.11 (SPA)
SPB: Q4.1 (S), Q4.2 (S), Q4.3 (S), R6.2, U$1.14 (SPB)
SPI-MISO: R3.1, U$1.29 (MODE), U$3.22 (PA6/SPI1_MISO)
SPI-MOSI: U$1.30 (IDRIVE), U$3.23 (PA7/SPI1_MOSI)
SPI-NSS-DRV: U$1.32 (GAIN), U$3.20 (PA4/SPI1_NSS)
SPI-SCK: U$1.31 (VDS), U$3.21 (PA5/SPI1_SCK)
SW: C4.1, D1.C, L1.2, U$1.45 (SW)
TCK: PROG.2, U$3.49 (PA14/JTCK)
TMS: PROG.4, U$3.46 (PA13/JTMS)
USART_RX: PROG.7, U$3.17 (PA3/UART2_RX)
USART_TX: PROG.6, U$3.16 (PA2/UART2_TX)
VCP: C6.2, U$1.5 (VCP)

Notes on the sheet:
DRV8323RS
STM32F446
CAN
CONNECTORS
ENCODER
H-BRIDGE
CAPACITOR BANK

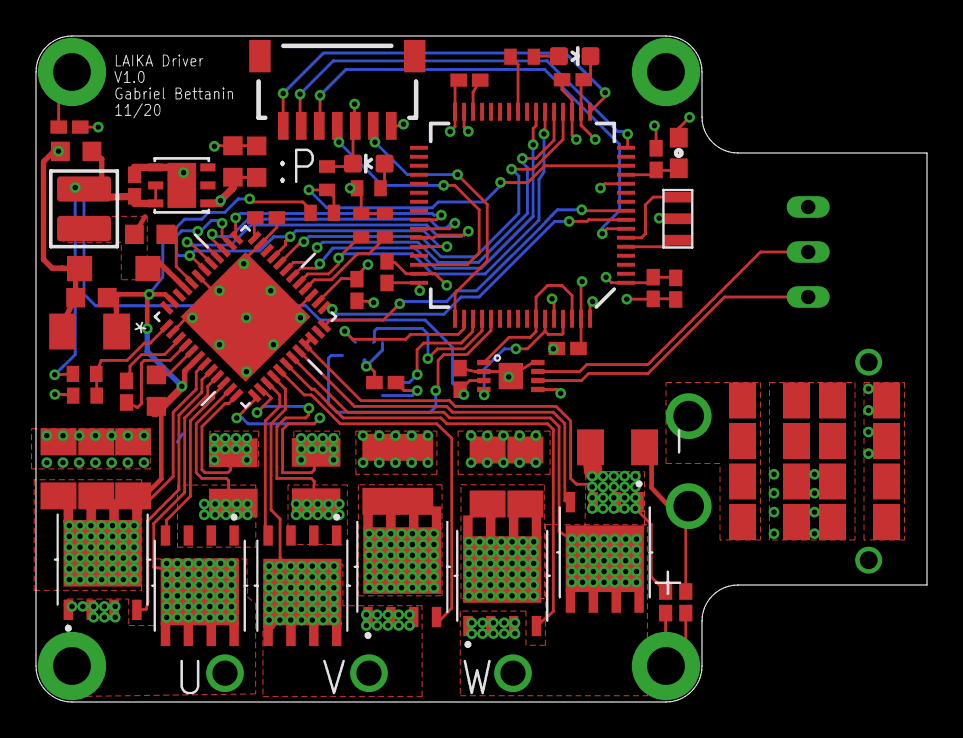
[picture p96: board Driver.brd from above]

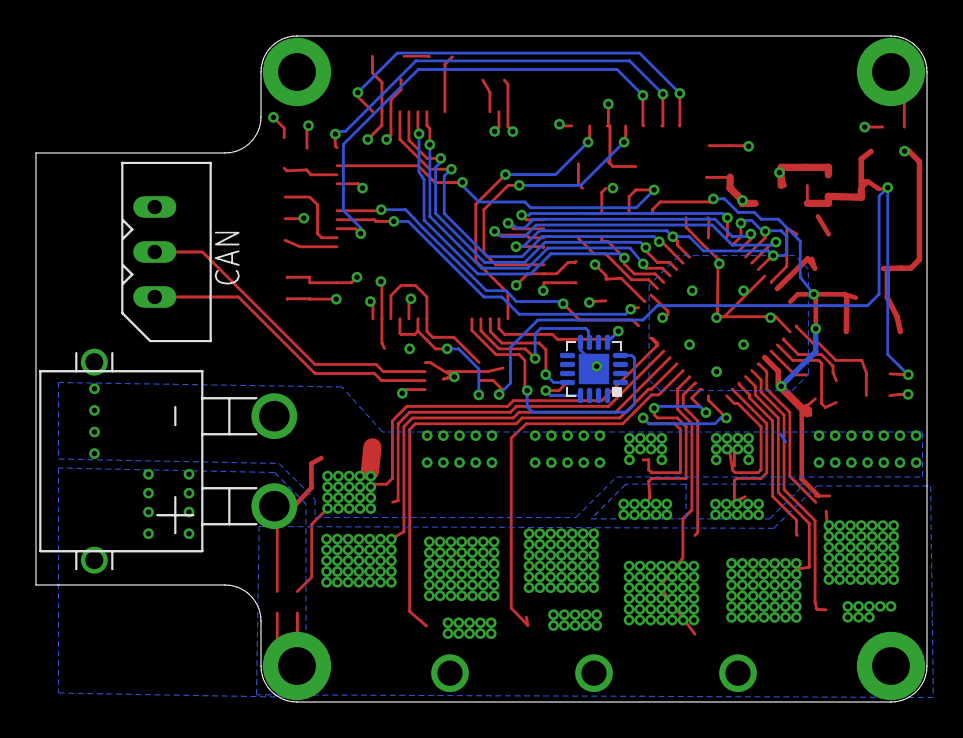
[picture p97: board Driver.brd from below]

Board: 4 copper layers, 49.5 x 37.0 mm, 72 parts (3 on the bottom side), 55 nets.
