gabriel-bettanin/LAIKA/References/Controllers/MIT Electronics/0_Sensor Board/MA700.brd

## EAGLE design References/Controllers/MIT Electronics/0_Sensor Board/MA700.brd (2021-11-09)

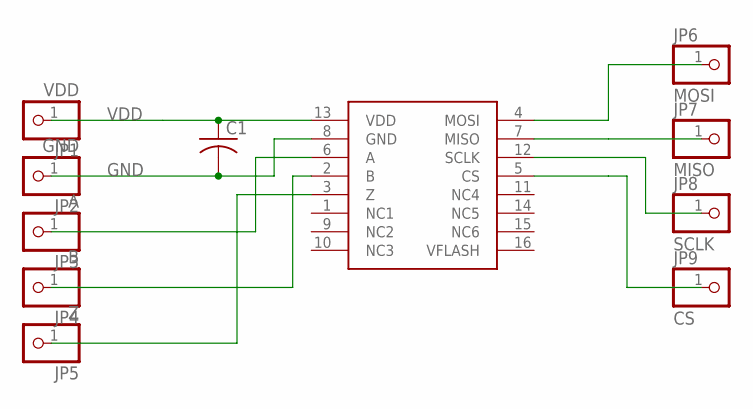
[picture p98: schematic MA700.sch]

Parts:
C1: C-USC0603; C0603
JP1: VDD; 1X01
JP2: GND; 1X01
JP3: A; 1X01
JP4: B; 1X01
JP5: Z; 1X01
JP6: MOSI; 1X01
JP7: MISO; 1X01
JP8: SCLK; 1X01
JP9: CS; 1X01
U$1: MA700; QFN16

Connections:
GND: C1.2, JP2.1, U$1.8 (GND)
unnamed: JP4.1, U$1.2 (B)
unnamed: JP9.1, U$1.5 (CS)
unnamed: JP3.1, U$1.6 (A)
unnamed: JP5.1, U$1.3 (Z)
unnamed: JP7.1, U$1.7 (MISO)
unnamed: JP8.1, U$1.12 (SCLK)
unnamed: JP6.1, U$1.4 (MOSI)
VDD: C1.1, JP1.1, U$1.13 (VDD)

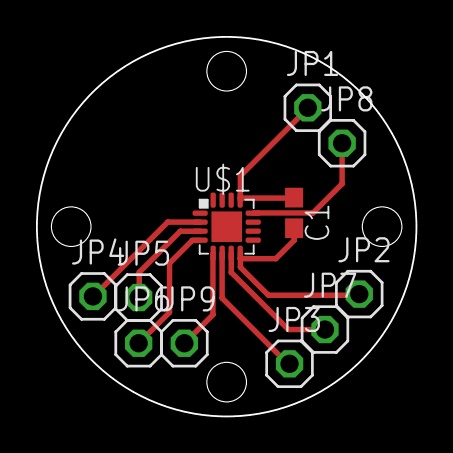
[picture p99: board MA700.brd from above]

Board: 2 copper layers, 21.1 x 21.1 mm, 11 parts (0 on the bottom side), 9 nets.
