gabriel-bettanin/LAIKA/References/Controllers/MIT Electronics/2_Integrated 2-layer/cheetah_driver_integrated.brd

## EAGLE design References/Controllers/MIT Electronics/2_Integrated 2-layer/cheetah_driver_integrated.brd (2021-11-09)

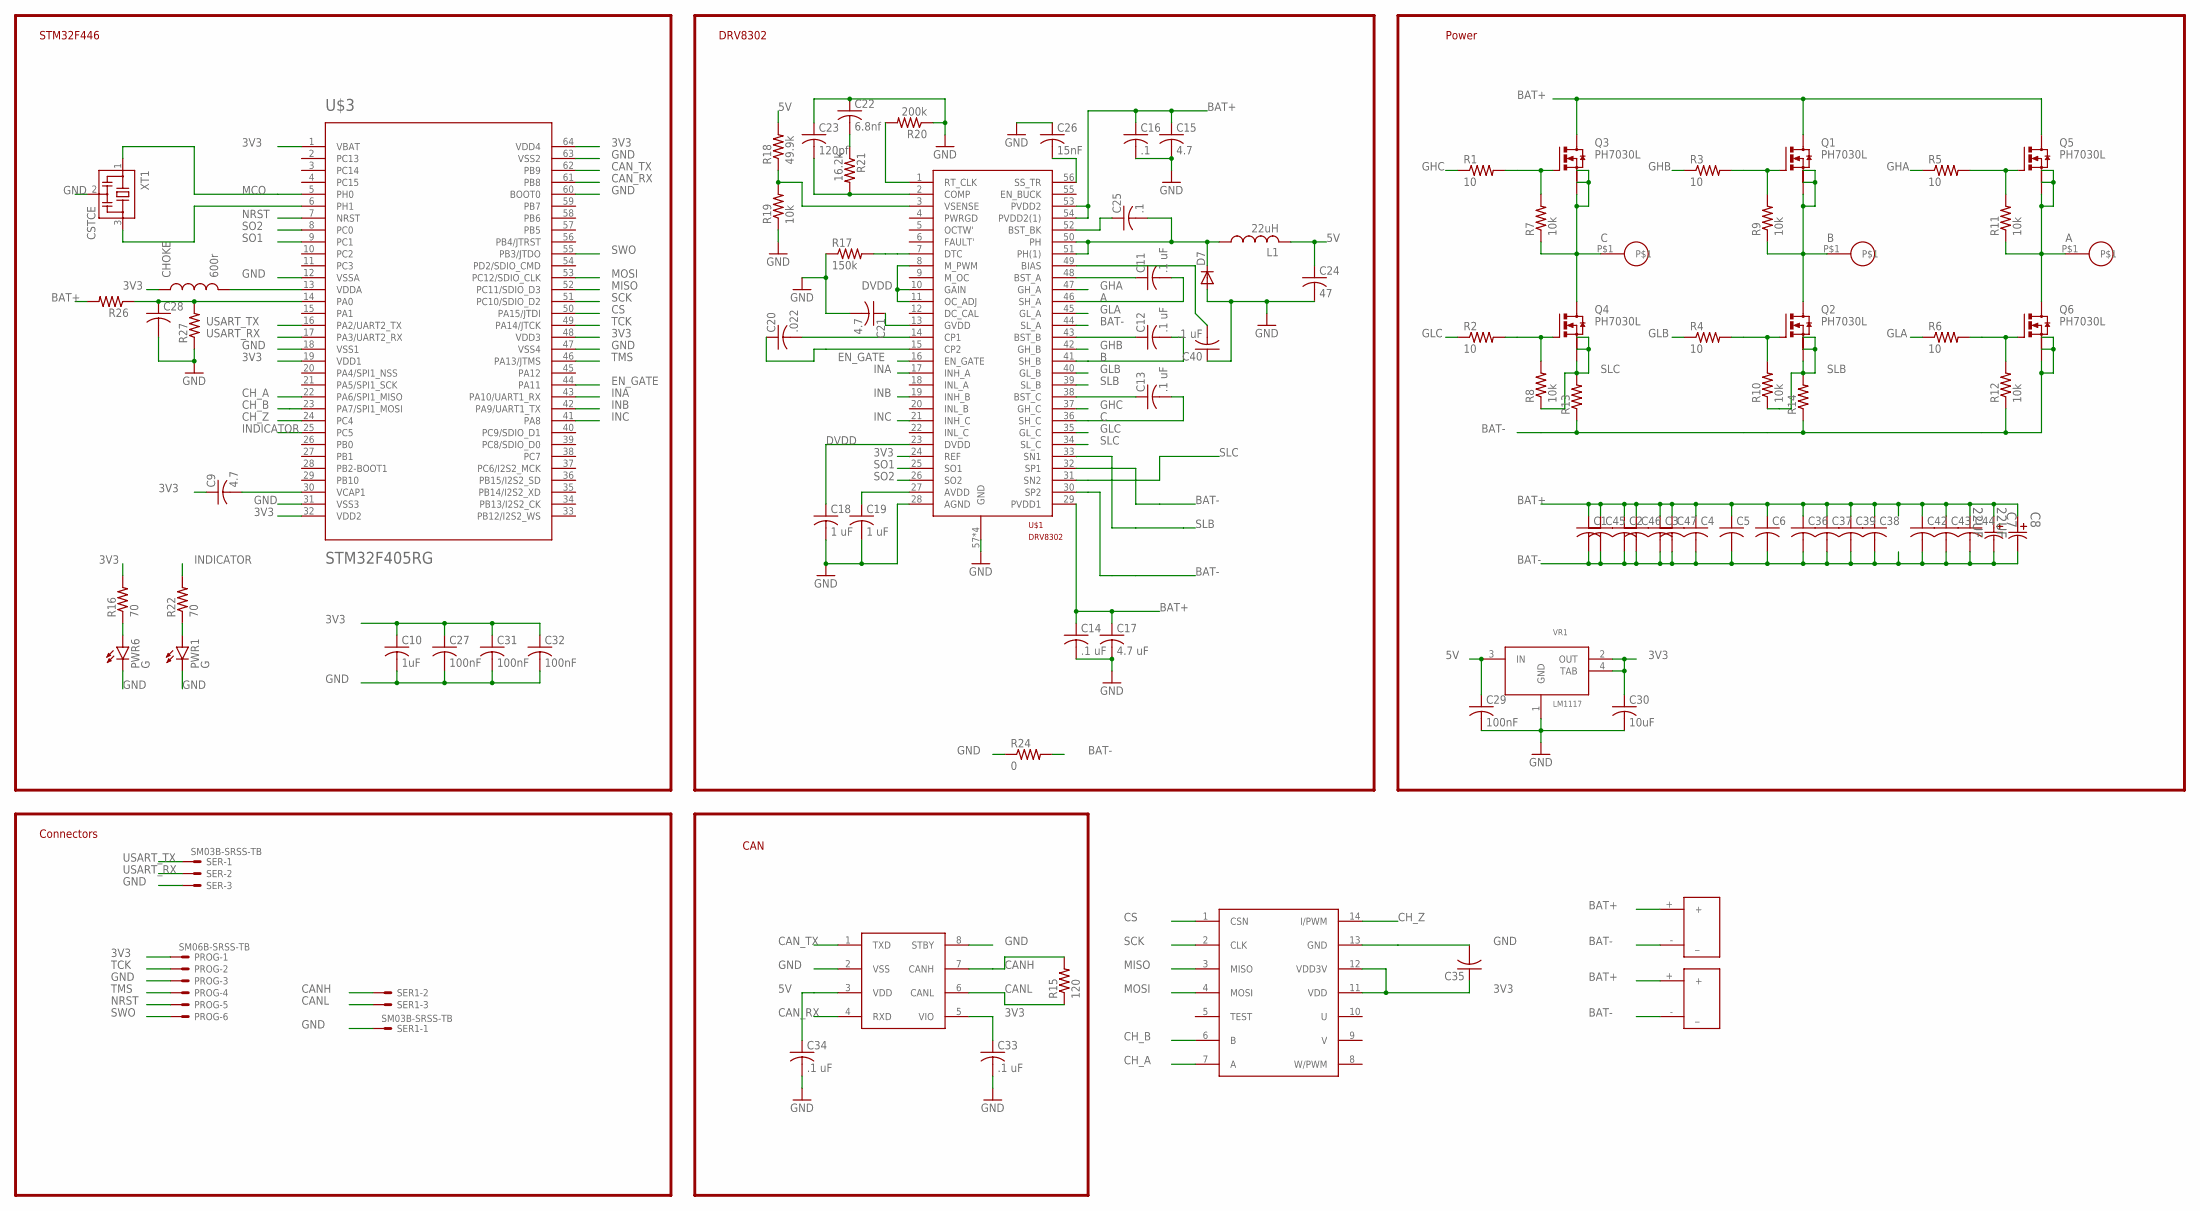
[picture p100: schematic cheetah_driver_integrated.sch]

Parts:
C1, C2, C3, C4, C5, C6, C36, C37, C38, C39, C42, C43, C44, C45, C46, C47: C-USC1206; C1206
C7, C8: 22UF; CAPAE660X610N
C9: 4.7; C0603
C10: 1uF; C0603
C11, C12, C13, C14, C40: .1 uF; C0603
C15, C21: 4.7; C0805
C16, C25: .1; C0603
C17: 4.7 uF; C0805
C18, C19: 1 uF; C0603
C20: .022; C0603
C22: 6.8nf; C0603
C23: 120pf; C0603
C24: 47; C1210
C26: 15nF; C0603
C27, C29, C31, C32: 100nF; C0603
C28, C35: C-USC0603; C0603
C30: 10uF; C0603
C33, C34: .1 uF; C0603K
CHOKE: 600r; 0603
D7: DIODE-DO-214AC; DO-214AC
L1: 22uH; L4532P
PROG: SM06B-SRSS-TB
PWR1, PWR6: G; LED-0603
Q1, Q2, Q3, Q4, Q5, Q6: PH7030L; SOT669
R1, R2, R3, R4, R5, R6: 10; R0603
R7, R8, R9, R10, R11, R12, R19: 10k; R0603
R13, R14: R-US_R1210; R1210
R15: 120; R0603
R16, R22: 70; R0603
R17: 150k; R0603
R18: 49.9k; R0603
R20: 200k; R0603
R21: 16.2k; R0603
R24: 0; R0603
R26, R27: R-US_R0603; R0603
SER, SER1: SM03B-SRSS-TB
U$1: DRV8302; HTSSOP56
U$2, U$4, U$5: 18_AWG_PAD
U$3: STM32F405RG; TQFP64
U$6: MCP2561; SO08
U$7: AS5147P; TSSOP14
U$8, U$9: DC_CONNECTOR; XT30_HORIZONTAL
VR1: LM1117; SOT-223
XT1: CSTCE

Connections:
3V3: C9.1, C10.1, C27.1, C30.1, C31.1, C32.1, C33.1, C35.1, CHOKE.1, PROG.1, R16.2, U$1.24 (REF), U$3.1 (VBAT), U$3.19 (VDD1), U$3.32 (VDD2), U$3.48 (VDD3), U$3.64 (VDD4), U$6.5 (VIO), U$7.11 (VDD), U$7.12 (VDD3V), VR1.2 (OUT), VR1.4 (TAB)
5V: C24.1, C29.1, C34.1, L1.2, R18.2, U$6.3 (VDD), VR1.3 (IN)
A: C11.2, Q5.1 (S), Q5.2 (S), Q5.3 (S), Q6.MB (D), R11.1, U$1.46 (SH_A), U$5.P$1
B: C12.2, Q1.1 (S), Q1.2 (S), Q1.3 (S), Q2.MB (D), R9.1, U$1.41 (SH_B), U$4.P$1
BAT+: C1.1, C2.1, C3.1, C4.1, C5.1, C6.1, C7.1, C8.1, C14.1, C15.1, C16.1, C17.1, C36.1, C37.1, C38.1, C39.1, C42.1, C43.1, C44.1, C45.1, C46.1, C47.1, Q1.MB (D), Q3.MB (D), Q5.MB (D), R26.2, U$1.29 (PVDD1), U$1.53 (PVDD2), U$1.54 (PVDD2(1)), U$8.+, U$9.+
BAT-: C1.2, C2.2, C3.2, C4.2, C5.2, C6.2, C7.2, C8.2, C36.2, C37.2, C38.2, C39.2, C42.2, C43.2, C44.2, C45.2, C46.2, C47.2, Q6.1 (S), Q6.2 (S), Q6.3 (S), R12.1, R13.1, R14.1, R24.2, U$1.30 (SP2), U$1.32 (SP1), U$1.44 (SL_A), U$8.- (_), U$9.- (_)
C: C13.2, Q3.1 (S), Q3.2 (S), Q3.3 (S), Q4.MB (D), R7.1, U$1.36 (SH_C), U$2.P$1
CANH: R15.2, SER1.2, U$6.7 (CANH)
CANL: R15.1, SER1.3, U$6.6 (CANL)
CAN_RX: U$3.61 (PB8), U$6.4 (RXD)
CAN_TX: U$3.62 (PB9), U$6.1 (TXD)
CH_A: U$3.22 (PA6/SPI1_MISO), U$7.7 (A)
CH_B: U$3.23 (PA7/SPI1_MOSI), U$7.6 (B)
CH_Z: U$3.24 (PC4), U$7.14 (I/PWM)
CS: U$3.50 (PA15/JTDI), U$7.1 (CSN)
DVDD: C18.1, U$1.8 (M_PWM), U$1.10 (GAIN), U$1.11 (OC_ADJ), U$1.23 (DVDD)
EN_GATE: U$1.16 (EN_GATE), U$3.44 (PA11)
GHA: R5.1, U$1.47 (GH_A)
GHB: R3.1, U$1.42 (GH_B)
GHC: R1.1, U$1.37 (GH_C)
GLA: R6.1, U$1.45 (GL_A)
GLB: R4.1, U$1.40 (GL_B)
GLC: R2.1, U$1.35 (GL_C)
GND: C10.2, C14.2, C15.2, C16.2, C17.2, C18.2, C19.2, C21.2, C22.1, C23.1, C24.2, C26.1, C27.2, C28.2, C29.2, C30.2, C31.2, C32.2, C33.2, C34.2, C35.2, C40.1, D7.A, PROG.3, PWR1.C, PWR6.C, R17.1, R19.1, R20.1, R24.1, R27.1, SER.3, SER1.1, U$1.28 (AGND), U$1.57 (GND), U$1.P$1 (GND), U$1.P$2 (GND), U$1.P$3 (GND), U$3.12 (VSSA), U$3.18 (VSS1), U$3.31 (VSS3), U$3.47 (VSS4), U$3.60 (BOOT0), U$3.63 (VSS2), U$6.2 (VSS), U$6.8 (STBY), U$7.13 (GND), VR1.1 (GND), XT1.2
INA: U$1.17 (INH_A), U$3.43 (PA10/UART1_RX)
INB: U$1.19 (INH_B), U$3.42 (PA9/UART1_TX)
INC: U$1.21 (INH_C), U$3.41 (PA8)
INDICATOR: R22.2, U$3.25 (PC5)
MCO: U$3.5 (PH0), XT1.1
MISO: U$3.52 (PC11/SDIO_D3), U$7.3 (MISO)
MOSI: U$3.53 (PC12/SDIO_CLK), U$7.4 (MOSI)
unnamed: Q3.4 (G), R1.2, R7.2
unnamed: CHOKE.2, U$3.13 (VDDA)
unnamed: C9.2, U$3.30 (VCAP1)
unnamed: C11.1, U$1.48 (BST_A)
unnamed: C40.2, U$1.49 (BIAS)
unnamed: C13.1, U$1.38 (BST_C)
unnamed: Q4.4 (G), R2.2, R8.2
unnamed: Q1.4 (G), R3.2, R9.2
unnamed: C12.1, U$1.43 (BST_B)
unnamed: Q5.4 (G), R5.2, R11.2
unnamed: Q6.4 (G), R6.2, R12.2
unnamed: R18.1, R19.2, U$1.3 (VSENSE)
unnamed: R17.2, U$1.7 (DTC)
unnamed: C19.1, U$1.27 (AVDD)
unnamed: C20.2, U$1.14 (CP1)
unnamed: C20.1, U$1.15 (CP2)
unnamed: C21.1, U$1.13 (GVDD)
unnamed: C23.2, R21.2, U$1.2 (COMP)
unnamed: R20.2, U$1.1 (RT_CLK)
unnamed: C22.2, R21.1
unnamed: C25.2, D7.C, L1.1, U$1.50 (PH), U$1.51 (PH(1))
unnamed: C25.1, U$1.52 (BST_BK)
unnamed: C26.2, U$1.56 (SS_TR)
unnamed: C28.1, R26.1, R27.2, U$3.14 (PA0)
unnamed: PWR6.A, R16.1
unnamed: Q2.4 (G), R4.2, R10.2
unnamed: PWR1.A, R22.1
unnamed: U$3.6 (PH1), XT1.3
NRST: PROG.5, U$3.7 (NRST)
SCK: U$3.51 (PC10/SDIO_D2), U$7.2 (CLK)
SLB: Q2.1 (S), Q2.2 (S), Q2.3 (S), R10.1, R14.2, U$1.33 (SN1), U$1.39 (SL_B)
SLC: Q4.1 (S), Q4.2 (S), Q4.3 (S), R8.1, R13.2, U$1.31 (SN2), U$1.34 (SL_C)
SO1: U$1.25 (SO1), U$3.9 (PC1)
SO2: U$1.26 (SO2), U$3.8 (PC0)
SWO: PROG.6, U$3.55 (PB3/JTDO)
TCK: PROG.2, U$3.49 (PA14/JTCK)
TMS: PROG.4, U$3.46 (PA13/JTMS)
USART_RX: SER.2, U$3.17 (PA3/UART2_RX)
USART_TX: SER.1, U$3.16 (PA2/UART2_TX)

Notes on the sheet:
DRV8302
STM32F446
Connectors
Power
CAN

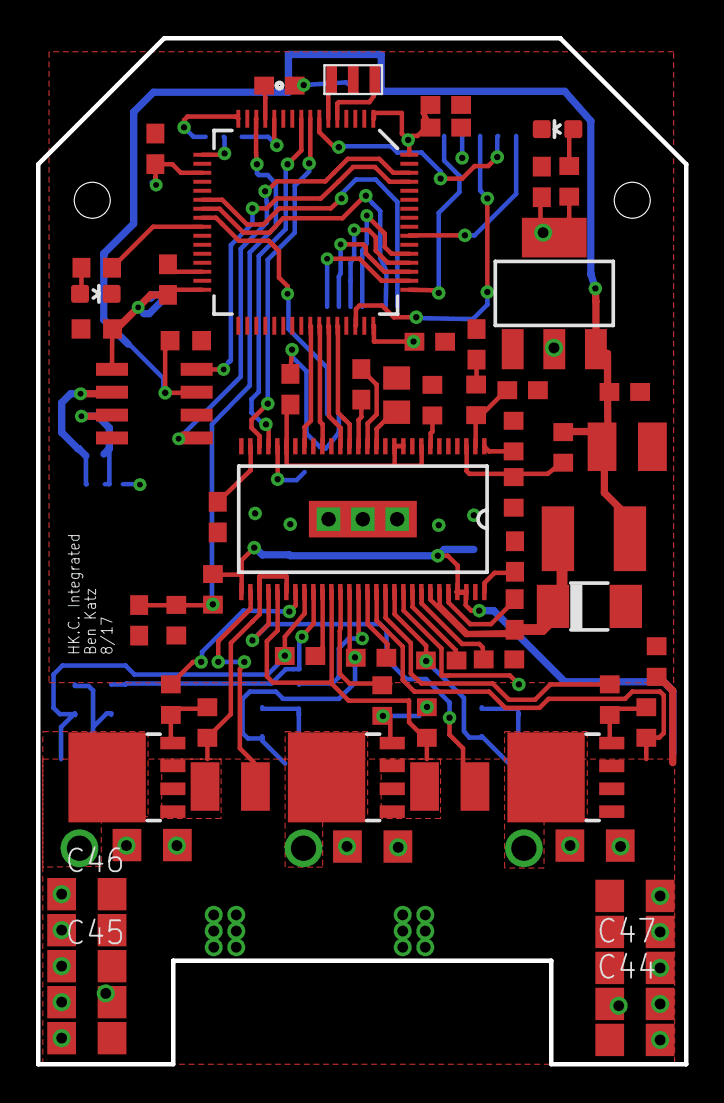
[picture p101: board cheetah_driver_integrated.brd from above]

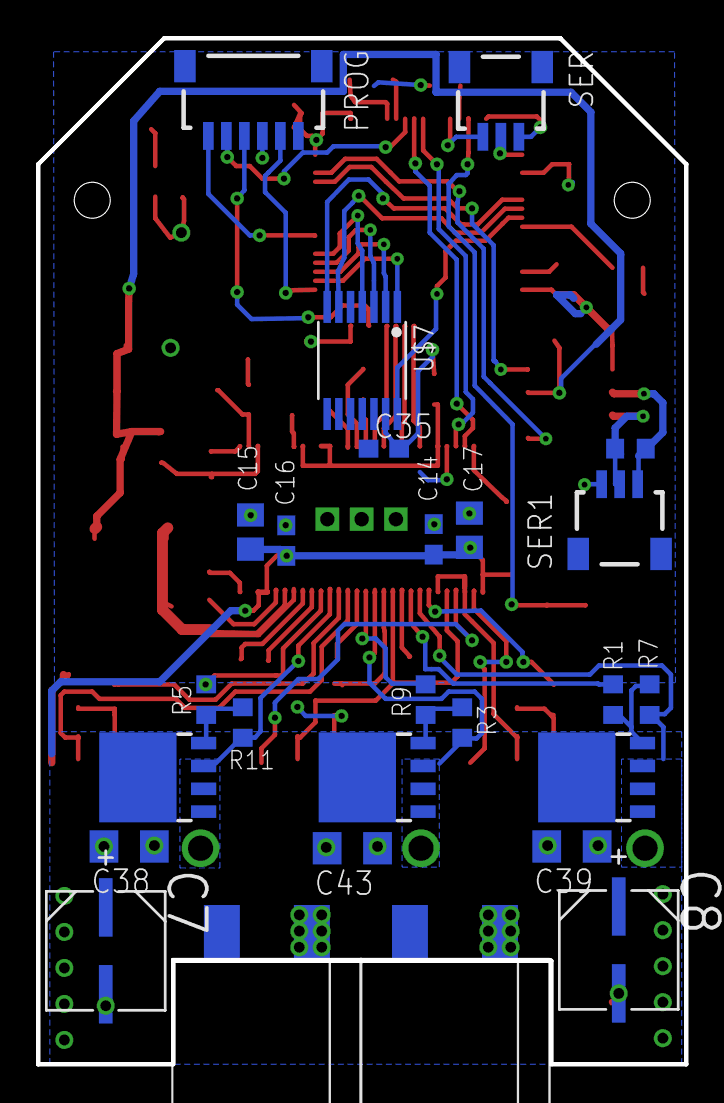
[picture p102: board cheetah_driver_integrated.brd from below]

Board: 2 copper layers, 36.0 x 57.0 mm, 96 parts (26 on the bottom side), 70 nets.
