gabriel-bettanin/LAIKA/References/Controllers/MicroDriver/microDriver_v2.brd

## EAGLE design References/Controllers/MicroDriver/microDriver_v2.brd (2021-11-09)

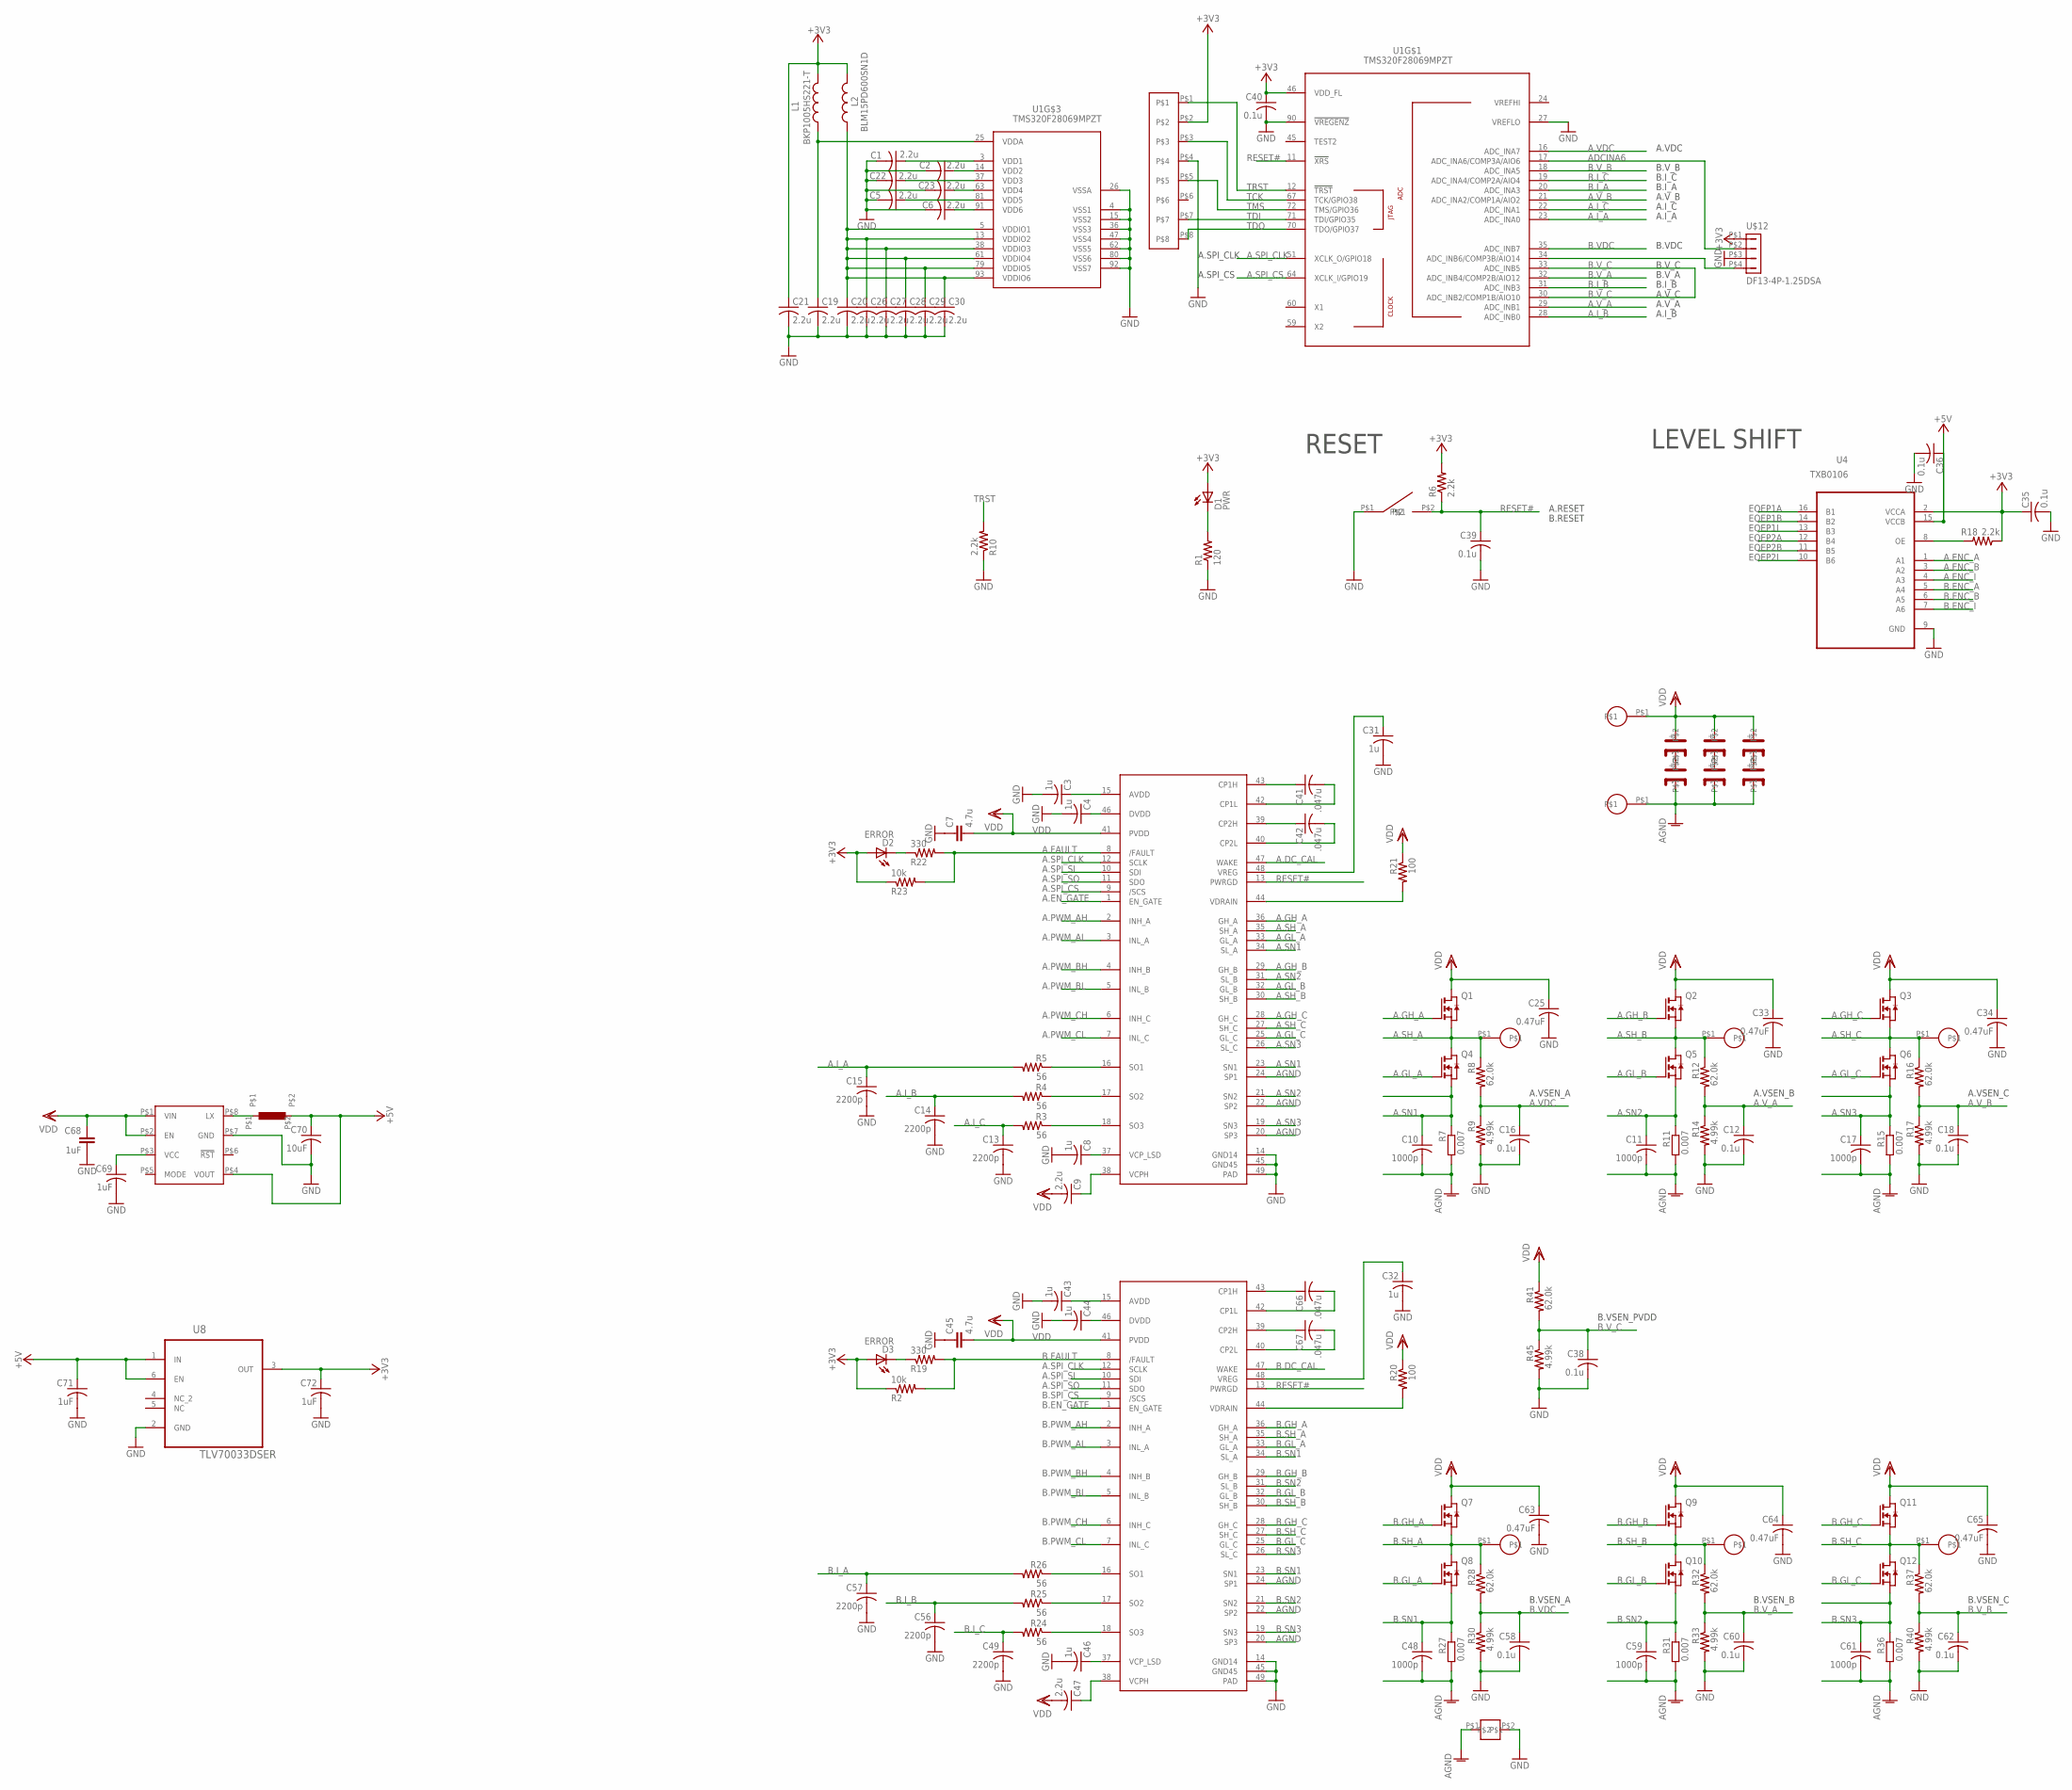
[picture p109: schematic microDriver_v2.sch, sheet 1]

Parts:
B1: B3U
C1, C2, C5, C6, C9, C19, C20, C21, C22, C23, C26, C27, C28, C29, C30, C47: 2.2u; C0402
C3, C4, C8, C31, C32, C43, C44, C46: 1u; C0402
C7, C45: 4.7u; C0805K
C10, C11, C17, C48, C59, C61: 1000p; C0402
C12, C16, C18, C35, C36, C38, C39, C40, C58, C60, C62: 0.1u; C0402
C13, C14, C15, C49, C56, C57: 2200p; C0402
C25, C33, C34, C63, C64, C65: 0.47uF; C0402
C41, C42, C66, C67: .047u; C0402
C68: 1uF; C0603
C69, C71, C72: 1uF; C0402
C70: 10uF; C0402
D1: PWR; CHIP-LED0603
D2, D3: ERROR; CHIP-LED0603
I1: NR4018; 4X4
L1: BKP1005HS221-T; R0402
L2: BLM15PD600SN1D; R0402
M1: AMP-8; AMP-MINITEK-8
Q1, Q2, Q3, Q4, Q5, Q6, Q7, Q8, Q9, Q10, Q11, Q12: CSD18540; Q5B
R1: 120; R0402
R2, R23: 10k; R0402
R3, R4, R5, R24, R25, R26: 56; R0402
R6, R10, R18: 2.2k; R0402
R7, R11, R15, R27, R31, R36: 0.007; R2512
R8, R12, R16, R28, R32, R37, R41: 62.0k; R0402
R9, R14, R17, R30, R33, R40, R45: 4.99k; R0402
R19, R22: 330; R0402
R20, R21: 100; R0402
T1, T2, T3, T4, T5, T6: 7343-CAP; M7343-CAP
U1: TMS320F28069MPZT; PQFP100
U4: TXB0106; VQFN-N16
U5, U6: DRV8305; HTQFP-48
U7: MAX15062; TDFN-8
U8: TLV70033DSER; SON50P150X150X80-6N
U$2: GND-AGND
U$3, U$4, U$5, U$6, U$7, U$8, U$9, U$10: BLDC_PAD
U$12: DF13-4P-1.25DSA

Connections:
+3V3: C21.1, C35.1, C40.1, C72.1, D1.A, D2.A, D3.A, L1.2, L2.2, M1.P$2, R2.1, R6.2, R18.1, R23.1, U1.46 (VDD_FL), U4.2 (VCCA), U8.3 (OUT), U$12.P$1 (1); also elsewhere on the board
+5V: C36.1, C70.1, C71.1, I1.P$2, U4.15 (VCCB), U7.P$4 (VOUT), U8.1 (IN), U8.6 (EN); also elsewhere on the board
A.DC_CAL: U6.47 (WAKE); also elsewhere on the board
A.ENC_A: U4.1 (A1); also elsewhere on the board
A.ENC_B: U4.3 (A2); also elsewhere on the board
A.ENC_I: U4.4 (A3); also elsewhere on the board
A.EN_GATE: U6.1 (EN_GATE); also elsewhere on the board
A.FAULT: R22.2, R23.2, U6.8 (/FAULT); also elsewhere on the board
A.GH_A: Q1.4 (G), U6.36 (GH_A)
A.GH_B: Q2.4 (G), U6.29 (GH_B)
A.GH_C: Q3.4 (G), U6.28 (GH_C)
A.GL_A: Q4.4 (G), U6.33 (GL_A)
A.GL_B: Q5.4 (G), U6.32 (GL_B)
A.GL_C: Q6.4 (G), U6.25 (GL_C)
A.I_A: C15.1, R5.2, U1.23 (ADC_INA0)
A.I_B: C14.1, R4.2, U1.28 (ADC_INB0)
A.I_C: C13.1, R3.2, U1.22 (ADC_INA1)
A.PWM_AH: U6.2 (INH_A); also elsewhere on the board
A.PWM_AL: U6.3 (INL_A); also elsewhere on the board
A.PWM_BH: U6.4 (INH_B); also elsewhere on the board
A.PWM_BL: U6.5 (INL_B); also elsewhere on the board
A.PWM_CH: U6.6 (INH_C); also elsewhere on the board
A.PWM_CL: U6.7 (INL_C); also elsewhere on the board
A.SH_A: Q1.1 (S), Q1.2 (S), Q1.3 (S), Q4.5 (D), Q4.6 (D), Q4.7 (D), Q4.8 (D), Q4.9 (D), R8.1, U6.35 (SH_A), U$6.P$1
A.SH_B: Q2.1 (S), Q2.2 (S), Q2.3 (S), Q5.5 (D), Q5.6 (D), Q5.7 (D), Q5.8 (D), Q5.9 (D), R12.1, U6.30 (SH_B), U$7.P$1
A.SH_C: Q3.1 (S), Q3.2 (S), Q3.3 (S), Q6.5 (D), Q6.6 (D), Q6.7 (D), Q6.8 (D), Q6.9 (D), R16.1, U6.27 (SH_C), U$8.P$1
A.SN1: C10.1, Q4.1 (S), Q4.2 (S), Q4.3 (S), R7.1, U6.23 (SN1), U6.34 (SL_A)
A.SN2: C11.1, Q5.1 (S), Q5.2 (S), Q5.3 (S), R11.1, U6.21 (SN2), U6.31 (SL_B)
A.SN3: C17.1, Q6.1 (S), Q6.2 (S), Q6.3 (S), R15.1, U6.19 (SN3), U6.26 (SL_C)
A.SPI_CLK: U1.51 (XCLK_O/GPIO18), U5.12 (SCLK), U6.12 (SCLK); also elsewhere on the board
A.SPI_CS: U1.64 (XCLK_I/GPIO19), U6.9 (/SCS)
A.SPI_SI: U5.10 (SDI), U6.10 (SDI); also elsewhere on the board
A.SPI_SO: U5.11 (SDO), U6.11 (SDO); also elsewhere on the board
A.VDC: C16.1, R8.2, R9.1, U1.16 (ADC_INA7)
A.V_A: C12.1, R12.2, R14.1, U1.29 (ADC_INB1)
A.V_B: C18.1, R16.2, R17.1, U1.21 (ADC_INA2/COMP1A/AIO2)
ADCINA6: U1.17 (ADC_INA6/COMP3A/AIO6), U$12.P$2 (2)
AGND: C10.2, C11.2, C17.2, C48.2, C59.2, C61.2, R7.2, R11.2, R15.2, R27.2, R31.2, R36.2, T2.-, T4.-, T6.-, U5.20 (SP3), U5.22 (SP2), U5.24 (SP1), U6.20 (SP3), U6.22 (SP2), U6.24 (SP1), U$2.P$1, U$10.P$1
AVDD: C3.1, U6.15 (AVDD)
AVDD1: C43.1, U5.15 (AVDD)
B.DC_CAL: U5.47 (WAKE); also elsewhere on the board
B.ENC_A: U4.5 (A4); also elsewhere on the board
B.ENC_B: U4.6 (A5); also elsewhere on the board
B.ENC_I: U4.7 (A6); also elsewhere on the board
B.EN_GATE: U5.1 (EN_GATE); also elsewhere on the board
B.FAULT: R2.2, R19.2, U5.8 (/FAULT); also elsewhere on the board
B.GH_A: Q7.4 (G), U5.36 (GH_A)
B.GH_B: Q9.4 (G), U5.29 (GH_B)
B.GH_C: Q11.4 (G), U5.28 (GH_C)
B.GL_A: Q8.4 (G), U5.33 (GL_A)
B.GL_B: Q10.4 (G), U5.32 (GL_B)
B.GL_C: Q12.4 (G), U5.25 (GL_C)
B.I_A: C57.1, R26.2, U1.20 (ADC_INA3)
B.I_B: C56.1, R25.2, U1.31 (ADC_INB3)
B.I_C: C49.1, R24.2, U1.19 (ADC_INA4/COMP2A/AIO4)
B.PWM_AH: U5.2 (INH_A); also elsewhere on the board
B.PWM_AL: U5.3 (INL_A); also elsewhere on the board
B.PWM_BH: U5.4 (INH_B); also elsewhere on the board
B.PWM_BL: U5.5 (INL_B); also elsewhere on the board
B.PWM_CH: U5.6 (INH_C); also elsewhere on the board
B.PWM_CL: U5.7 (INL_C); also elsewhere on the board
B.SH_A: Q7.1 (S), Q7.2 (S), Q7.3 (S), Q8.5 (D), Q8.6 (D), Q8.7 (D), Q8.8 (D), Q8.9 (D), R28.1, U5.35 (SH_A), U$3.P$1
B.SH_B: Q9.1 (S), Q9.2 (S), Q9.3 (S), Q10.5 (D), Q10.6 (D), Q10.7 (D), Q10.8 (D), Q10.9 (D), R32.1, U5.30 (SH_B), U$4.P$1
B.SH_C: Q11.1 (S), Q11.2 (S), Q11.3 (S), Q12.5 (D), Q12.6 (D), Q12.7 (D), Q12.8 (D), Q12.9 (D), R37.1, U5.27 (SH_C), U$5.P$1
B.SN1: C48.1, Q8.1 (S), Q8.2 (S), Q8.3 (S), R27.1, U5.23 (SN1), U5.34 (SL_A)
B.SN2: C59.1, Q10.1 (S), Q10.2 (S), Q10.3 (S), R31.1, U5.21 (SN2), U5.31 (SL_B)
B.SN3: C61.1, Q12.1 (S), Q12.2 (S), Q12.3 (S), R36.1, U5.19 (SN3), U5.26 (SL_C)
B.SPI_CS: U5.9 (/SCS); also elsewhere on the board
B.VDC: C58.1, R28.2, R30.1, U1.35 (ADC_INB7)
B.V_A: C60.1, R32.2, R33.1, U1.32 (ADC_INB4/COMP2B/AIO12)
B.V_B: C62.1, R37.2, R40.1, U1.18 (ADC_INA5)
B.V_C: C38.1, R41.2, R45.1, U1.30 (ADC_INB2/COMP1B/AIO10), U1.33 (ADC_INB5)
EQEP1A: U4.16 (B1); also elsewhere on the board
EQEP1B: U4.14 (B2); also elsewhere on the board
EQEP1I: U4.13 (B3); also elsewhere on the board
EQEP2A: U4.12 (B4); also elsewhere on the board
EQEP2B: U4.11 (B5); also elsewhere on the board
EQEP2I: U4.10 (B6); also elsewhere on the board
GND: B1.P$1, C1.2, C2.2, C3.2, C4.2, C5.2, C6.2, C7.1, C8.2, C12.2, C13.2, C14.2, C15.2, C16.2, C18.2, C19.2, C20.2, C21.2, C22.2, C23.2, C25.2, C26.2, C27.2, C28.2, C29.2, C30.2, C31.2, C32.2, C33.2, C34.2, C35.2, C36.2, C38.2, C39.2, C40.2, C43.2, C44.2, C45.1, C46.2, C49.2, C56.2, C57.2, C58.2, C60.2, C62.2, C63.2, C64.2, C65.2, C68.2, C69.2, C70.2, C71.2, C72.2, M1.P$4, R1.1, R9.2, R10.1, R14.2, R17.2, R30.2, R33.2, R40.2, R45.2, U1.4 (VSS1), U1.15 (VSS2), U1.26 (VSSA), U1.27 (VREFLO), U1.36 (VSS3), U1.47 (VSS4), U1.62 (VSS5), U1.80 (VSS6), U1.90 (!VREGENZ), U1.92 (VSS7), U4.9 (GND), U5.14 (GND14), U5.45 (GND45), U5.49 (PAD), U6.14 (GND14), U6.45 (GND45), U6.49 (PAD), U7.P$7 (GND), U8.2 (GND), U$2.P$2, U$12.P$3 (3); also elsewhere on the board
unnamed: U1.34 (ADC_INB6/COMP3B/AIO14), U$12.P$4 (4)
unnamed: C4.1, U6.46 (DVDD)
unnamed: R3.1, U6.18 (SO3)
unnamed: C8.1, U6.37 (VCP_LSD)
unnamed: C9.1, U6.38 (VCPH)
unnamed: C41.1, U6.43 (CP1H)
unnamed: R4.1, U6.17 (SO2)
unnamed: R5.1, U6.16 (SO1)
unnamed: C42.1, U6.39 (CP2H)
unnamed: C41.2, U6.42 (CP1L)
unnamed: C42.2, U6.40 (CP2L)
unnamed: R18.2, U4.8 (OE)
unnamed: D2.C, R22.1
unnamed: R21.2, U6.44 (VDRAIN)
unnamed: C44.1, U5.46 (DVDD)
unnamed: C46.1, U5.37 (VCP_LSD)
unnamed: C32.1, U5.48 (VREG)
unnamed: R24.1, U5.18 (SO3)
unnamed: C47.1, U5.38 (VCPH)
unnamed: R25.1, U5.17 (SO2)
unnamed: R26.1, U5.16 (SO1)
unnamed: C66.1, U5.43 (CP1H)
unnamed: C67.1, U5.39 (CP2H)
unnamed: C66.2, U5.42 (CP1L)
unnamed: C67.2, U5.40 (CP2L)
unnamed: D1.C, R1.2
unnamed: C1.1, U1.3 (VDD1)
unnamed: C2.1, U1.14 (VDD2)
unnamed: C22.1, U1.37 (VDD3)
unnamed: C23.1, U1.63 (VDD4)
unnamed: T1.-, T2.+
unnamed: T3.-, T4.+
unnamed: R20.2, U5.44 (VDRAIN)
unnamed: C5.1, U1.81 (VDD5)
unnamed: C6.1, U1.91 (VDD6)
unnamed: D3.C, R19.1
unnamed: T5.-, T6.+
unnamed: C31.1, U6.48 (VREG)
unnamed: I1.P$1, U7.P$8 (LX)
unnamed: C69.1, U7.P$3 (VCC)
RESET#: B1.P$2, C39.1, R6.1, U1.11 (!XRS), U5.13 (PWRGD), U6.13 (PWRGD)
TCK: M1.P$3, U1.67 (TCK/GPIO38)
TDI: M1.P$7, U1.71 (TDI/GPIO35)
TDO: M1.P$8, U1.70 (TDO/GPIO37)
TMS: M1.P$5, U1.72 (TMS/GPIO36)
TRST: M1.P$1, R10.2, U1.12 (!TRST)
VDD: C7.2, C9.2, C25.1, C33.1, C34.1, C45.2, C47.2, C63.1, C64.1, C65.1, C68.1, Q1.5 (D), Q1.6 (D), Q1.7 (D), Q1.8 (D), Q1.9 (D), Q2.5 (D), Q2.6 (D), Q2.7 (D), Q2.8 (D), Q2.9 (D), Q3.5 (D), Q3.6 (D), Q3.7 (D), Q3.8 (D), Q3.9 (D), Q7.5 (D), Q7.6 (D), Q7.7 (D), Q7.8 (D), Q7.9 (D), Q9.5 (D), Q9.6 (D), Q9.7 (D), Q9.8 (D), Q9.9 (D), Q11.5 (D), Q11.6 (D), Q11.7 (D), Q11.8 (D), Q11.9 (D), R20.1, R21.1, R41.1, T1.+, T3.+, T5.+, U5.41 (PVDD), U6.41 (PVDD), U7.P$1 (VIN), U7.P$2 (EN), U$9.P$1
VDDA: C19.1, L1.1, U1.25 (VDDA)
VDDIO: C20.1, C26.1, C27.1, C28.1, C29.1, C30.1, L2.1, U1.5 (VDDIO1), U1.13 (VDDIO2), U1.38 (VDDIO3), U1.61 (VDDIO4), U1.79 (VDDIO5), U1.93 (VDDIO6)

Notes on the sheet:
RESET
A.SPI_CLK
A.SPI_CS
A.RESET
B.RESET
B.VDC
B.V_A
B.V_B
B.V_C
B.I_A
B.I_B
B.I_C
A.VDC
A.V_A
A.V_B
A.V_C
A.I_A
A.I_B
A.I_C
A.VSEN_A
A.VSEN_B
A.VSEN_C
B.VSEN_A
B.VSEN_B
B.VSEN_C
B.VSEN_PVDD
LEVEL SHIFT

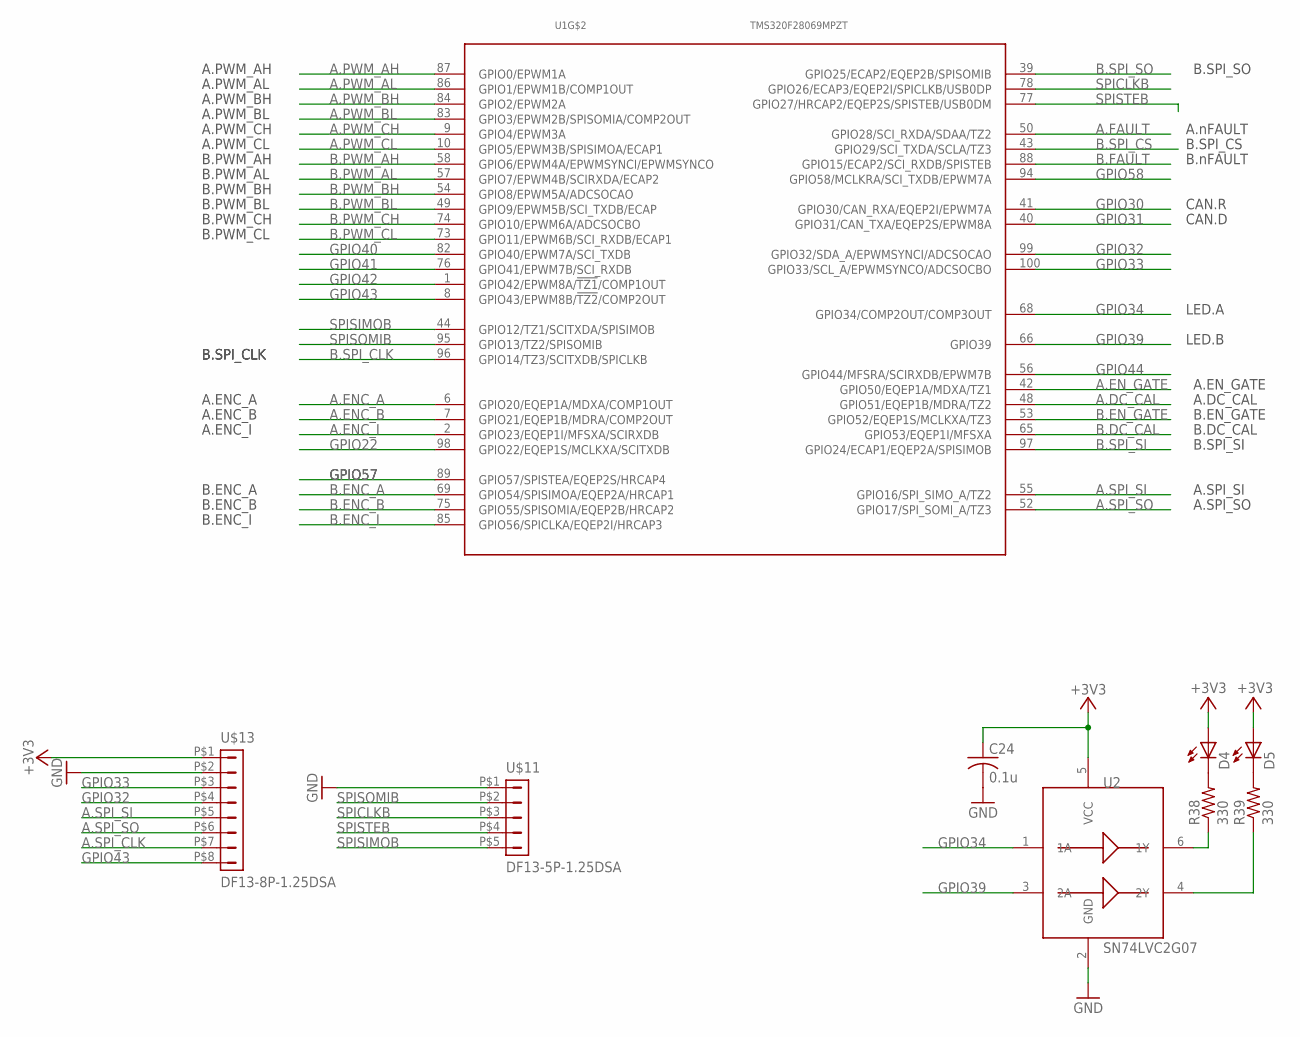
[picture p110: schematic microDriver_v2.sch, sheet 2]

Parts:
C24: 0.1u; C0402
D4, D5: LEDCHIP-LED0603; CHIP-LED0603
R38, R39: 330; R0402
U1: TMS320F28069MPZT; PQFP100
U2: SN74LVC2G07; SOT23-6-DBV
U$11: DF13-5P-1.25DSA
U$13: DF13-8P-1.25DSA

Connections:
+3V3: C24.1, D4.A, D5.A, U2.5 (VCC), U$13.P$1 (1); also elsewhere on the board
A.DC_CAL: U1.48 (GPIO51/EQEP1B/MDRA/TZ2); also elsewhere on the board
A.ENC_A: U1.6 (GPIO20/EQEP1A/MDXA/COMP1OUT); also elsewhere on the board
A.ENC_B: U1.7 (GPIO21/EQEP1B/MDRA/COMP2OUT); also elsewhere on the board
A.ENC_I: U1.2 (GPIO23/EQEP1I/MFSXA/SCIRXDB); also elsewhere on the board
A.EN_GATE: U1.42 (GPIO50/EQEP1A/MDXA/TZ1); also elsewhere on the board
A.FAULT: U1.50 (GPIO28/SCI_RXDA/SDAA/TZ2); also elsewhere on the board
A.PWM_AH: U1.87 (GPIO0/EPWM1A); also elsewhere on the board
A.PWM_AL: U1.86 (GPIO1/EPWM1B/COMP1OUT); also elsewhere on the board
A.PWM_BH: U1.84 (GPIO2/EPWM2A); also elsewhere on the board
A.PWM_BL: U1.83 (GPIO3/EPWM2B/SPISOMIA/COMP2OUT); also elsewhere on the board
A.PWM_CH: U1.9 (GPIO4/EPWM3A); also elsewhere on the board
A.PWM_CL: U1.10 (GPIO5/EPWM3B/SPISIMOA/ECAP1); also elsewhere on the board
A.SPI_CLK: U$13.P$7 (7); also elsewhere on the board
A.SPI_SI: U1.55 (GPIO16/SPI_SIMO_A/TZ2), U$13.P$5 (5); also elsewhere on the board
A.SPI_SO: U1.52 (GPIO17/SPI_SOMI_A/TZ3), U$13.P$6 (6); also elsewhere on the board
B.DC_CAL: U1.65 (GPIO53/EQEP1I/MFSXA); also elsewhere on the board
B.ENC_A: U1.69 (GPIO54/SPISIMOA/EQEP2A/HRCAP1); also elsewhere on the board
B.ENC_B: U1.75 (GPIO55/SPISOMIA/EQEP2B/HRCAP2); also elsewhere on the board
B.ENC_I: U1.85 (GPIO56/SPICLKA/EQEP2I/HRCAP3); also elsewhere on the board
B.EN_GATE: U1.53 (GPIO52/EQEP1S/MCLKXA/TZ3); also elsewhere on the board
B.FAULT: U1.88 (GPIO15/ECAP2/SCI_RXDB/SPISTEB); also elsewhere on the board
B.PWM_AH: U1.58 (GPIO6/EPWM4A/EPWMSYNCI/EPWMSYNCO); also elsewhere on the board
B.PWM_AL: U1.57 (GPIO7/EPWM4B/SCIRXDA/ECAP2); also elsewhere on the board
B.PWM_BH: U1.54 (GPIO8/EPWM5A/ADCSOCAO); also elsewhere on the board
B.PWM_BL: U1.49 (GPIO9/EPWM5B/SCI_TXDB/ECAP); also elsewhere on the board
B.PWM_CH: U1.74 (GPIO10/EPWM6A/ADCSOCBO); also elsewhere on the board
B.PWM_CL: U1.73 (GPIO11/EPWM6B/SCI_RXDB/ECAP1); also elsewhere on the board
B.SPI_CLK: U1.96 (GPIO14/TZ3/SCITXDB/SPICLKB)
B.SPI_CS: U1.43 (GPIO29/SCI_TXDA/SCLA/TZ3); also elsewhere on the board
B.SPI_SI: U1.97 (GPIO24/ECAP1/EQEP2A/SPISIMOB)
B.SPI_SO: U1.39 (GPIO25/ECAP2/EQEP2B/SPISOMIB)
GND: C24.2, U2.2 (GND), U$11.P$1 (1), U$13.P$2 (2); also elsewhere on the board
GPIO22: U1.98 (GPIO22/EQEP1S/MCLKXA/SCITXDB)
GPIO30: U1.41 (GPIO30/CAN_RXA/EQEP2I/EPWM7A); also elsewhere on the board
GPIO31: U1.40 (GPIO31/CAN_TXA/EQEP2S/EPWM8A); also elsewhere on the board
GPIO32: U1.99 (GPIO32/SDA_A/EPWMSYNCI/ADCSOCAO), U$13.P$4 (4)
GPIO33: U1.100 (GPIO33/SCL_A/EPWMSYNCO/ADCSOCBO), U$13.P$3 (3)
GPIO34: U1.68 (GPIO34/COMP2OUT/COMP3OUT), U2.1 (1A)
GPIO39: U1.66 (GPIO39), U2.3 (2A)
GPIO40: U1.82 (GPIO40/EPWM7A/SCI_TXDB)
GPIO41: U1.76 (GPIO41/EPWM7B/SCI_RXDB)
GPIO42: U1.1 (GPIO42/EPWM8A/!TZ1!/COMP1OUT)
GPIO43: U1.8 (GPIO43/EPWM8B/!TZ2!/COMP2OUT), U$13.P$8 (8)
GPIO44: U1.56 (GPIO44/MFSRA/SCIRXDB/EPWM7B)
GPIO57: U1.89 (GPIO57/SPISTEA/EQEP2S/HRCAP4)
GPIO58: U1.94 (GPIO58/MCLKRA/SCI_TXDB/EPWM7A)
unnamed: D4.C, R38.2
unnamed: D5.C, R39.2
unnamed: R38.1, U2.6 (1Y)
unnamed: R39.1, U2.4 (2Y)
SPICLKB: U1.78 (GPIO26/ECAP3/EQEP2I/SPICLKB/USB0DP), U$11.P$3 (3)
SPISIMOB: U1.44 (GPIO12/TZ1/SCITXDA/SPISIMOB), U$11.P$5 (5)
SPISOMIB: U1.95 (GPIO13/TZ2/SPISOMIB), U$11.P$2 (2)
SPISTEB: U1.77 (GPIO27/HRCAP2/EQEP2S/SPISTEB/USB0DM), U$11.P$4 (4)

Notes on the sheet:
A.nFAULT
B.nFAULT
B.SPI_CLK
B.PWM_AH
B.PWM_AL
B.PWM_BH
B.PWM_BL
B.PWM_CH
B.PWM_CL
A.PWM_AH
A.PWM_AL
A.PWM_BH
A.PWM_BL
A.PWM_CH
A.PWM_CL
B.SPI_CS
B.SPI_SI
B.SPI_SO
B.EN_GATE
B.DC_CAL
A.EN_GATE
A.DC_CAL
A.SPI_SI
A.SPI_SO
A.ENC_A
A.ENC_B
A.ENC_I
B.ENC_A
B.ENC_B
B.ENC_I
CAN.R
CAN.D
LED.A
LED.B

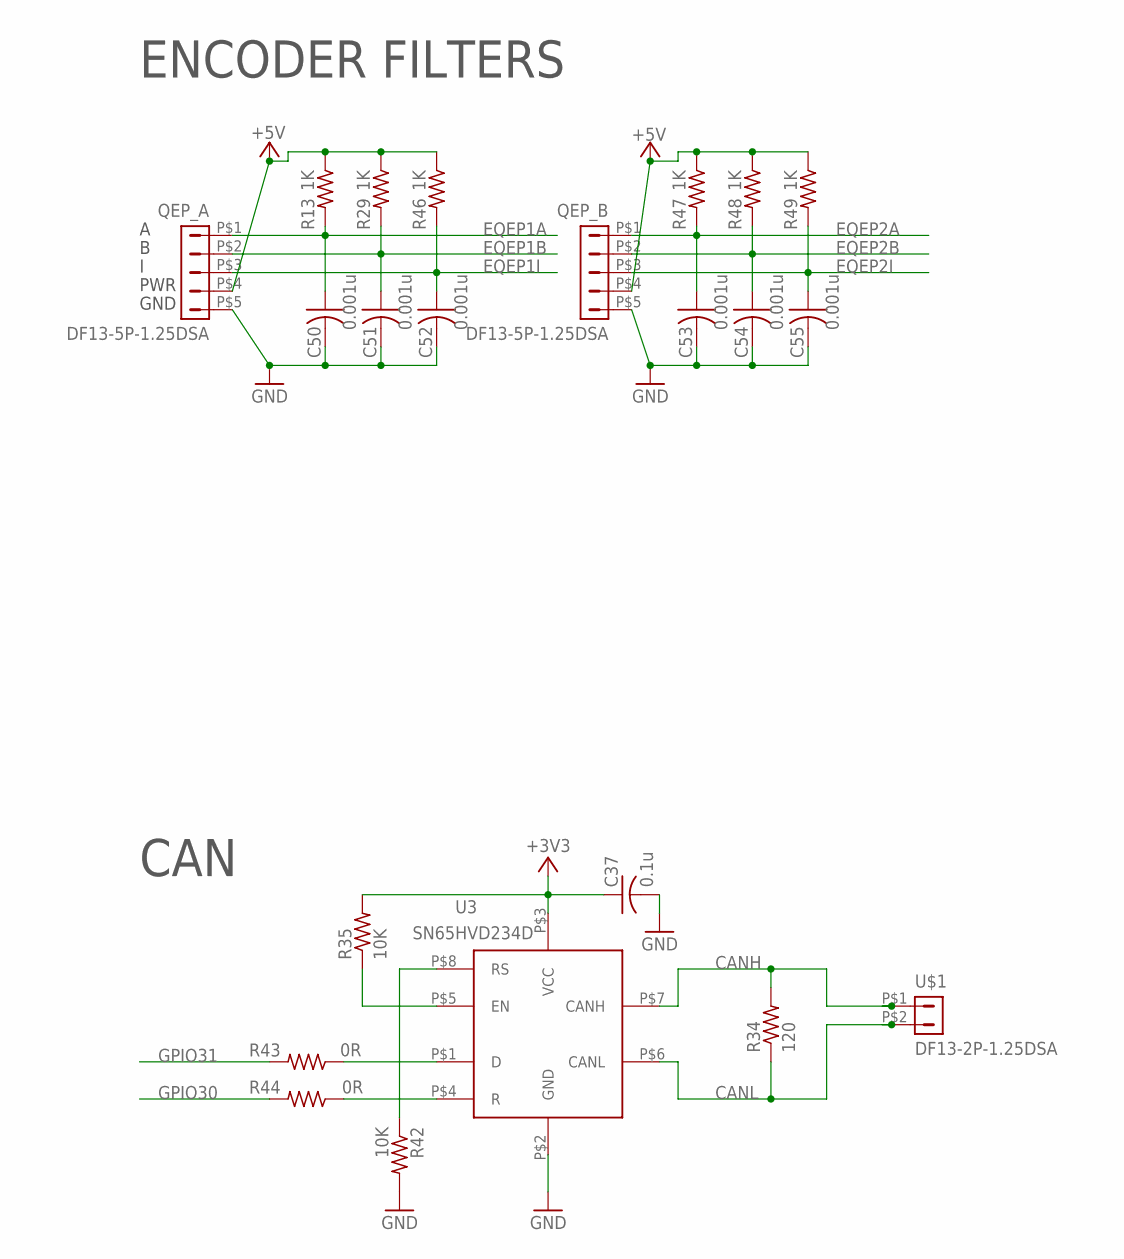
[picture p111: schematic microDriver_v2.sch, sheet 3]

Parts:
C37: 0.1u; C0402
C50, C51, C52, C53, C54, C55: 0.001u; C0402
QEP_A: DF13-5P-1.25DSA
QEP_B: DF13-5P-1.25DSA
R13, R29, R46, R47, R48, R49: 1K; R0402
R34: 120; R0402
R35, R42: 10K; R0402
R43, R44: 0R; R0402
U3: SN65HVD234D; SOIC8-PDSO
U$1: DF13-2P-1.25DSA

Connections:
+3V3: C37.1, R35.2, U3.P$3 (VCC); also elsewhere on the board
+5V: QEP_A.P$4 (4), QEP_B.P$4 (4), R13.1, R29.1, R46.1, R47.1, R48.1, R49.1; also elsewhere on the board
CANH: R34.2, U3.P$7 (CANH), U$1.P$1 (1)
CANL: R34.1, U3.P$6 (CANL), U$1.P$2 (2)
EQEP1A: C50.1, QEP_A.P$1 (1), R13.2; also elsewhere on the board
EQEP1B: C51.1, QEP_A.P$2 (2), R29.2; also elsewhere on the board
EQEP1I: C52.1, QEP_A.P$3 (3), R46.2; also elsewhere on the board
EQEP2A: C53.1, QEP_B.P$1 (1), R47.2; also elsewhere on the board
EQEP2B: C54.1, QEP_B.P$2 (2), R48.2; also elsewhere on the board
EQEP2I: C55.1, QEP_B.P$3 (3), R49.2; also elsewhere on the board
GND: C37.2, C50.2, C51.2, C52.2, C53.2, C54.2, C55.2, QEP_A.P$5 (5), QEP_B.P$5 (5), R42.2, U3.P$2 (GND); also elsewhere on the board
GPIO30: R44.2; also elsewhere on the board
GPIO31: R43.2; also elsewhere on the board
unnamed: R35.1, U3.P$5 (EN)
unnamed: R42.1, U3.P$8 (RS)
unnamed: R43.1, U3.P$1 (D)
unnamed: R44.1, U3.P$4 (R)

Notes on the sheet:
GND
PWR
CAN
ENCODER FILTERS

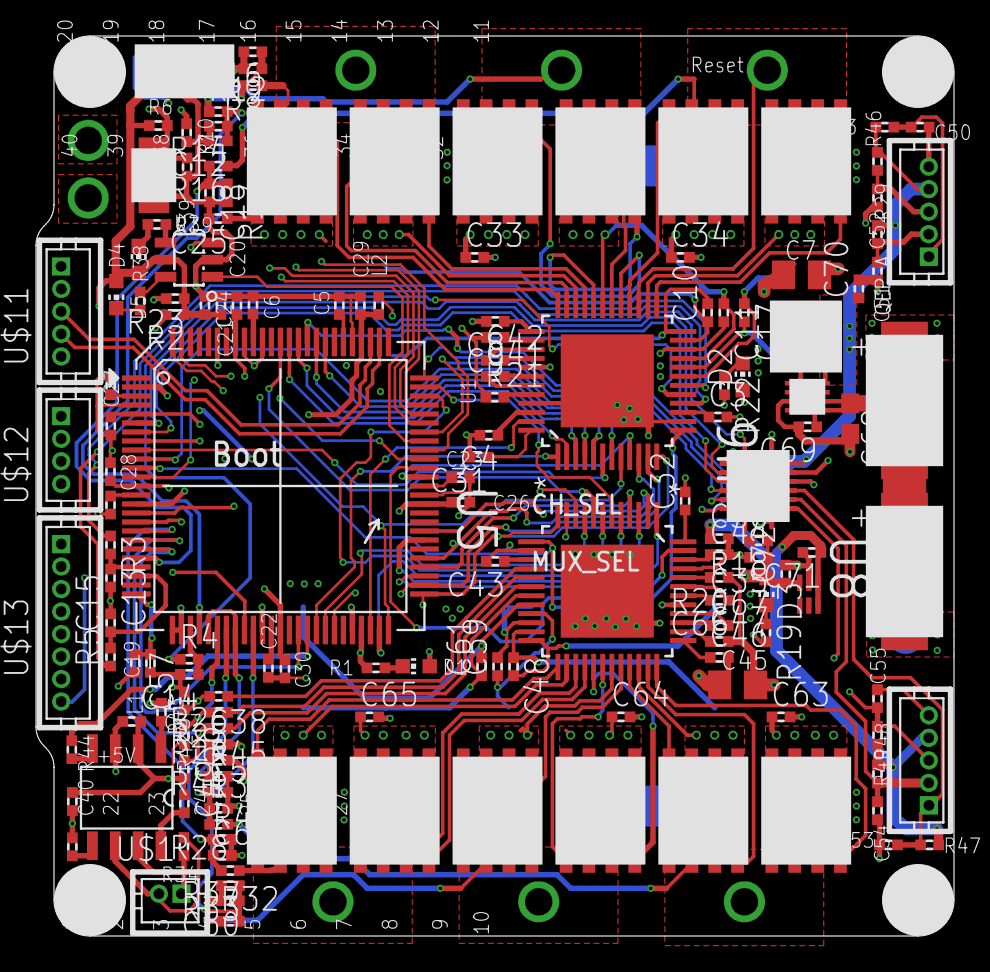
[picture p112: board microDriver_v2.brd from above]

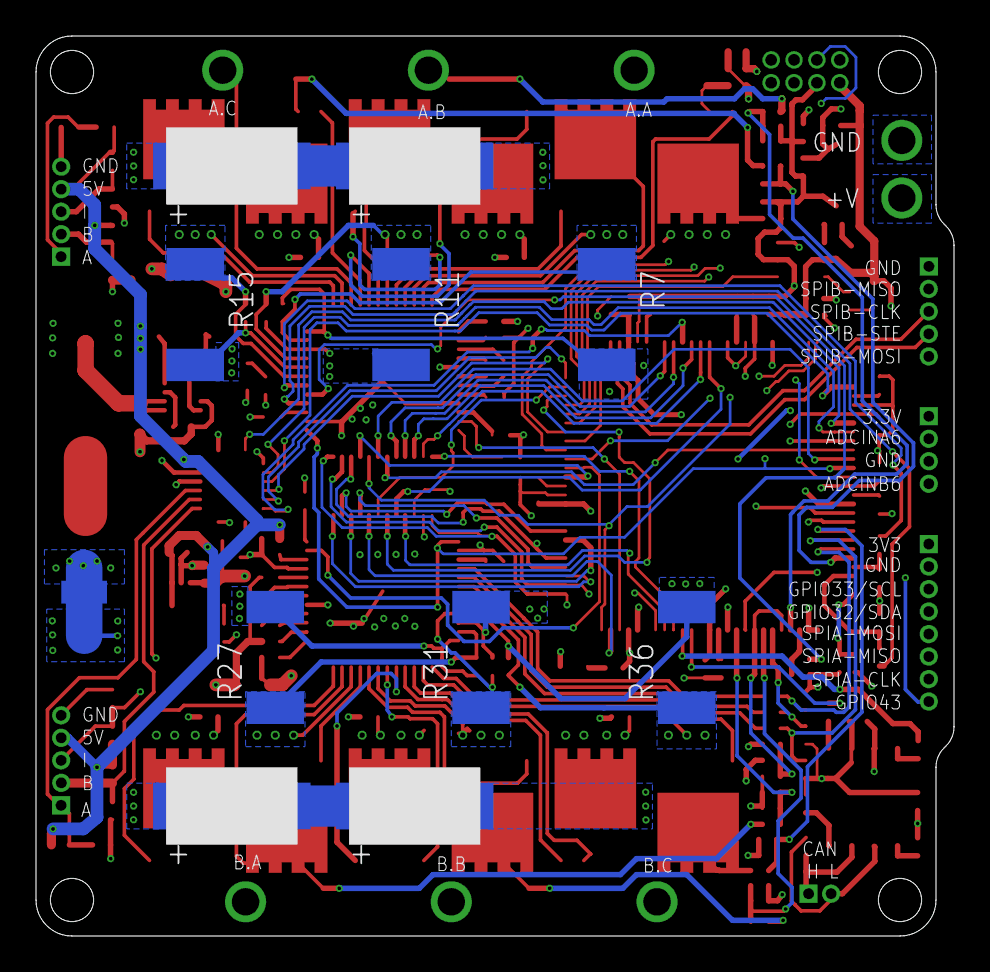
[picture p113: board microDriver_v2.brd from below]

Board: 6 copper layers, 51.0 x 50.0 mm, 172 parts (11 on the bottom side), 149 nets.
