gabriel-bettanin/LAIKA/(notices)

Notices in the files:
References/Controllers/Moteus driver/r4.5.sch:
Licensed under the Apache 2.0 License
References/Controllers/Moteus driver/r4.5.brd:
(c) 2020
parts and their libraries:
SparkFun-Passives: Licensing: Creative Commons ShareAlike 4.0 International - https://creativecommons.org/licenses/by-sa/4.0
inductor-bourns: Copyright (C) 2008, Bob Starr
